derTino89/RotaCon/README.md

# RotaCon
 full Project with 3D-Print, PCB-Layouts, Arduino-Program etc.
