derTino89/RotaCon/Documentation/dokumentation.pdf

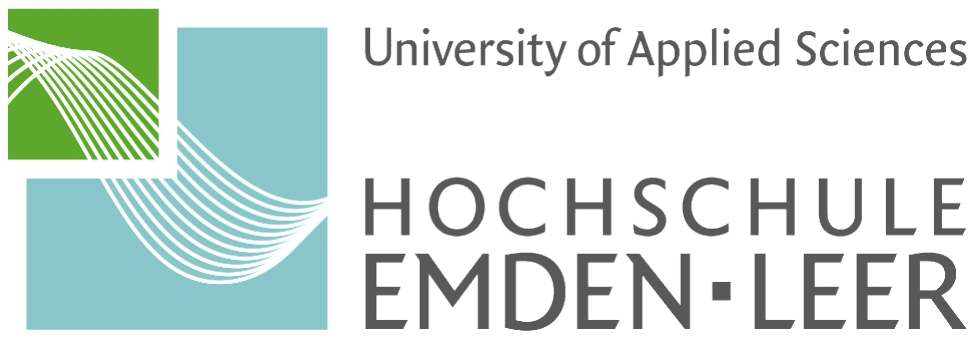
[picture p15: figure]

Projektarbeit

# RotaCon - Dokumentation

### vorgelegt von:

### - Tino Liebenow - Matrikelnummer 7011830

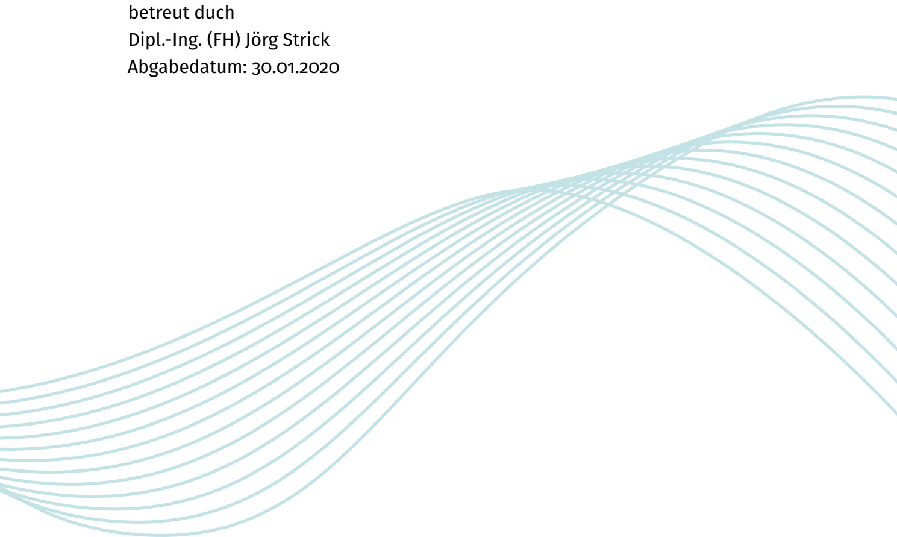
[picture p16: figure]
betreut duch; Dipl.-Ing. (FH) Jörg Strick; Abgabedatum: 30.01.2020

# Inhaltsverzeichnis

1 Prolog | 4
2 Konzeptentwurf | 5
3 Prototyp-Entwicklung | 7

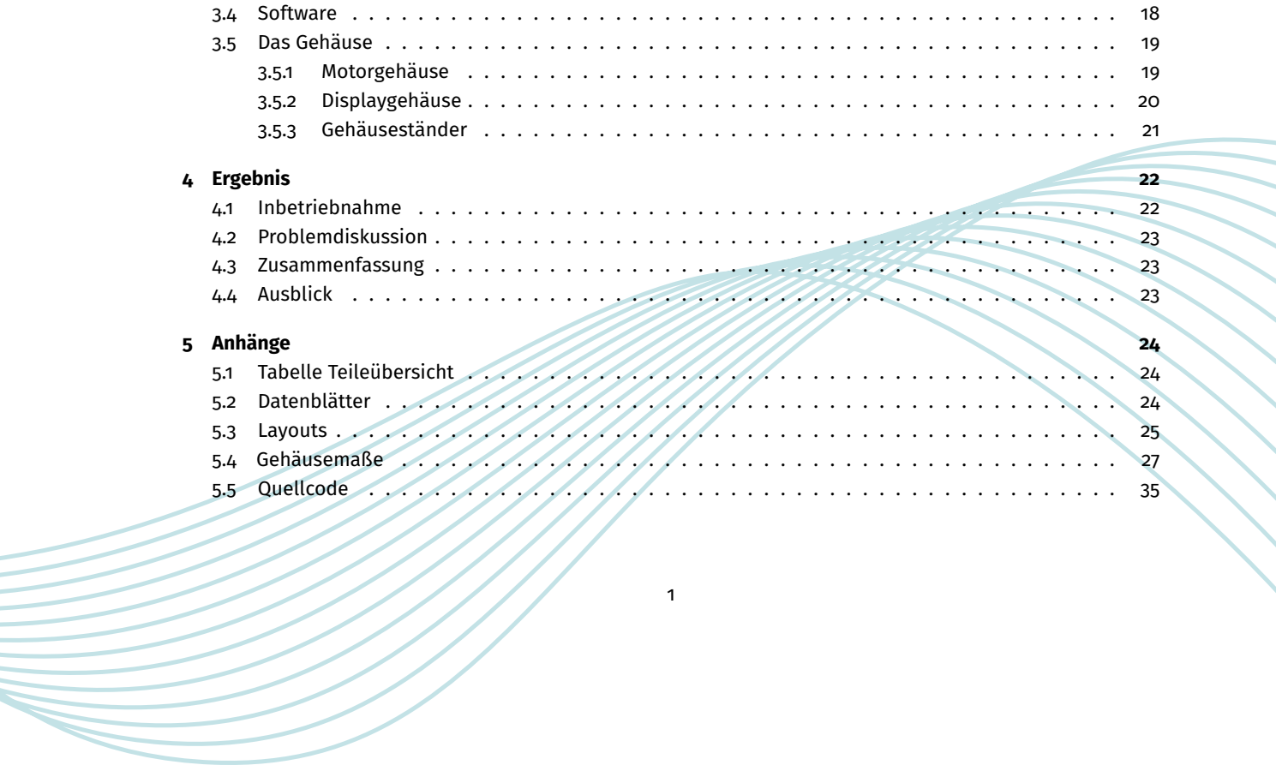
[picture p17: figure]
4 Ergebnis; 5 Anhänge

# Abbildungsverzeichnis

3.1 | Aufbau eines unipolaren Schrittmotors. | | | 9
3.2 | Ansteuerung des Motors durch Arduino und Darlington-Transistortreiber ULN2003. | | | 10
3.3 | Infrarot-Empfänger mit Pull-Up-Widerstand und Filterkondensator. | | | 11
3.4 | D-Sub-Pinbelegung für Display und IR-Receiver(gestrichelte Linie) | | 12
3.5 | Einsatz eines nicht-invertierenden Verstärkers zur Strommessung | | | 13
3.6 | Finale Schaltung der Display-Platine | | 16
3.7 | Finale Schaltung der Motor-Platine. | | | 17
3.8 | Skizze Des Motorgehäuses | | | 19
3.9 | Skizze Des Displaygehäuses | | 20
3.10 Gehäuseständer des Prototyps | | | 21
5.1 | Display-Platine | | 25
5.2 | Motor-Platine | | | 26

# Tabellenverzeichnis

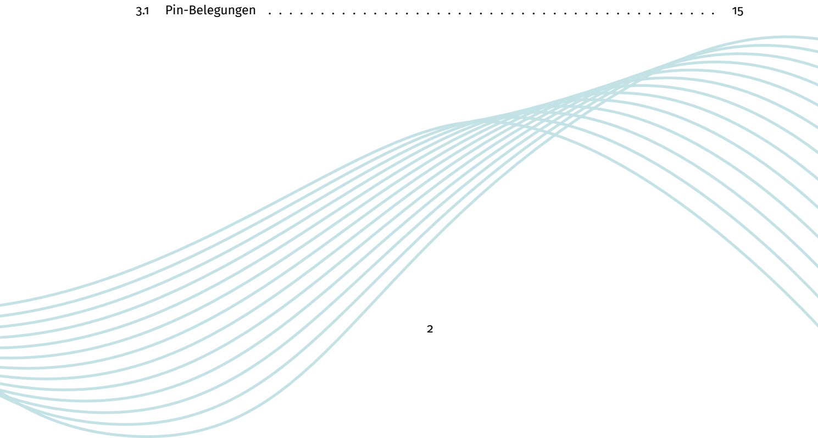
[picture p18: figure]

3.1 | Pin-Belegungen | | | 15

# Abkürzungsverzeichnis

### A/D Analog / Digital

CAD computer-aided design

D-Sub D-Subminiatur, eine Bauform für ein Steckersystem

EEPROM electrically erasable programmable read-only memory

### EQ Equalizer

HSEL Hochschule Emden Leer

IDE Integrated Development Environment

I/O Input / Output

IR Infrarot

### LCD liquid crystal display

TP Tiefpass

USB Universal Serial Bus

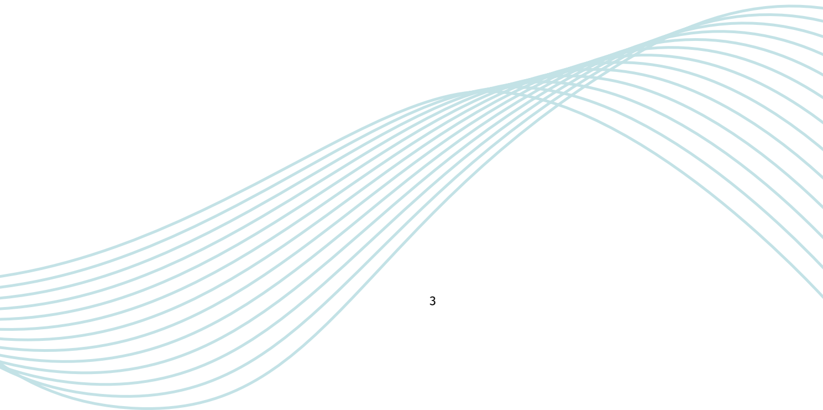
[picture p19: figure]

# Kapitel 1

# Prolog

Hier wird Tino am Ende der Arbeit eine tolle Einleitung hinzaubern, die dei Ausgangslage zu derzeitigen Aktiv-

lautsprechern beschreibt, ähnlich der Idee. Außerdem schreibe ich in männlicher Form etc...

Außerdem reden wir immer vom AKTIV-Lautsprecher...

# Überblick

Überblick über den Aufbau der Dokumentation.

Diese Dokumentation ist in vier Hauptteile gegliedert. Im Prolog wird die Ausgangssituation geschildert, sowie

die Kerngedanken zum RotaCon.

# Ziel

was möchte Tino heute eigentlich machen?

Ziel ist es ein Gerät zur Fernbedienbarkeit von Potentiometern, speziell an Lautsprechern, zu entwickeln.

Dabei sollen weder Veränderungen am Lautsprechergehäuse, oder an der Technik vorgenommen werden.

Zusätzlich ist eine Diskretisierung der Pegelwerte und deren Visualisierung via LCD-Display angedacht, sodass

der Benutzer sichtbare Werte zur Orientierung der aktuellen Einstellung bekommt.

# Stand der Technik

gibts sowas schon?

Fernsteuerungen für Pegeleinstellungen sind nicht neu auf dem Markt. Dabei sind zwei Varianten verbreitet,

zum Einen besteht die Möglichkeit, den Potentiometer auf der Platine des Lautsprechers auszutauschen, zum

Anderen die Integrierung eines Controllers in den Signalweg. Die erste Variante setzt somit die Önung des

Lautsprechergehäuses sowie Manipulation der Elektronik voraus. Dies ist nicht nur für den durchschnittlichen

Lautsprecherbesitzer ein schwieriger Eingri, sondern hat ebenfalls Einfluss auf diverse Garantieansprüche.

Die andere Variante beinhaltet keine Veränderungen am Lautsprecher selbst, regelt jedoch nur die Signalpegel

zum Lautsprecher hin und nicht den integrierten Verstärker. Somit muss für diese Version der Verstärker stets

auf Maximum geregelt sein, dies hat je nach Verstärker Einflüsse auf Soundqualität und Stromverbrauch.

4

# Kapitel 2

# Konzeptentwurf

Das folgende Kapitel beinhaltet die theoretischen Bestandteile zur Umsetzung der Idee. Diese bilden in ihrer

Gesamtheit das Konzept, nachdem der Prototyp entwickelt wird.

# 2.1 Theorie Hardware

Lautstärkeregler sind in den meisten Fällen Potentiometer oder Inkrementalgeber. Diese besitzen in der Regel

eine 6mm oder 6.35mm Achse, in D-Form oder gerielt. Um diese Achse rotieren zu können muss also ein Motor

mit einer passenden Kupplung angebracht werden. Für präzise Kontrolle und ausreichendes Drehmoment ist

ein Schrittmotor geeignet. Diesen gibt es in verschiedenen Ausfertigungen: unipolar und bipolar. Unipolare

Schrittmotoren haben vier Phasen (Elektromagnete) und werden nur in einer Richtung von Strom durchflossen.

Bipolare polen ihre Magnetfelder durch Umkehrung der Stromrichtung um, sie haben zwei Phasen, erreichen

ein höheres Drehmoment und sind durch ihre Funktionsweise etwas aufwendiger anzusteuern.

Für eine Schrittmotorsteuerung sind drei Funktionseinheiten notwendig. Diese bestehen aus Mikrocontroller,

Steuerschaltung und Treiberstufen. Für dieses Projekt ist ein unipolarer Schrittmotor ausreichend, da keine

hohen Drehmomente erreicht werden müssen. Dies hat zusätzlich den Vorteil, dass die Steuerschaltung simpel

ist und rein auf Softwarebasis gelegt werden kann. Als Treiber soll eine Darlington-Schaltung für den Motor

dienen. Die softwaretechnische Besteuerung ist durch ein Arduino mit integriertem Mikrocontroller angestrebt,

dessen Spannungsversorgung von 5V idealer Weise auch für die anderen Komponenten ausreichen soll, sodass

ein Betrieb des Gerätes durch USB-Spannungsversorgung ermöglicht wird.

Da analoge Drehregler durch eine Minimal- und Maximalstellung begrenzt sind, ist auch der Antrieb des Motors

in diesen Bereichen zu stoppen. In erster Linie sollen Endschalter den Potentiometer-Anschlag erkennen und

Software-gesteuert die Rotation einstellen. Redundant dazu wird der Stromverbrauch des Schrittmotors durch

die Kombination eines nicht-invertierenden Verstärkers und dem Analog-Digital-Wandler vom Mikrocontroller

überwacht.

Für die Bedienung des Gerätes soll ein Infrarotempfänger mit passender Fernbedienung im Frequenzbereich

verwendet werden. Da sich Lautstärkeregler meist nicht sichtbar am Lautsprecher befinden, ein IR-Empfänger

jedoch eine quasioptische Verbindung voraussetzt, bieten sich zwei getrennte Gehäuseteile an, die durch ein

Kabel verbunden sind. In dem sichtbaren Gehäuse befindet sich zusätzlich das Display.

5

# 2.2 Theorie Software

Softwaretechnisch sind drei Bereiche in diesem Projekt abzudecken:

1. Programmierung des Mikrocontrollers
2. Entwurf von Schaltung und Platinenlayout
3. Modellierung der Gehäuse

Bei der Programmierung des Mikrocontrollers soll beachtet werden, dass die aktuellen Werte der Motorstellung

und der dazugehörigen Lautstärkeanzeige gespeichert werden, damit bei jeder Inbetriebnahme die jeweils

vorherigen Werte beibehalten bleiben. Die einzige Schnittstelle zum Benutzer ist das Display, daher müssen

Fehler, Warnungen und wichtige Informationen auf dem Display abgebildet werden. Alle variablen Funktionen

des Gerätes sollen über die Fernbedienung steuerbar sein, also die Steuerung der Lautstärke, aber auch das

Aktivieren, bzw. Deaktivieren der Displaybeleuchtung.

Für den Entwurf der Schaltung sowie die Erstellung des Platinenlayouts soll ein Leiterplatten-Editor benutzt

werden. So können externe Platinen-Hersteller oder hochschuleigene Maschinen die Produktion der

Leiterplatten sicherstellen.

Die Gestaltung der Gehäuse muss präzise modeliert werden, damit Steckverbindungen und Display form-

schlüssig integriert werden können. Dabei soll zusätzlich darauf geachtet werden, dass alle Teile von einem

3D-Drucker gerfertigt werden können.

# 2.3 Theorie Mechanik und Design

Die Übertragung des Drehmoments vom Motor an den Drehregler des Lautsprechers kann nur stattfinden,

wenn der Motor starr gelagert ist. Daher ist das Gehäuse mit Motor und Motorsteuerung zu fixieren. Weiterhin

sind Lautstärkeregler an unterschiedlichen Lautsprechern auch an verschiedenen Positionen, sodass dieses

Gehäuse zusätzlich in seiner Position variabel positionierbar sein muss.

Einige Lautsprecher mit stärkeren Verstärkern haben zusätzlich Kühlkörper an der Lautsprecherrückseite, aus

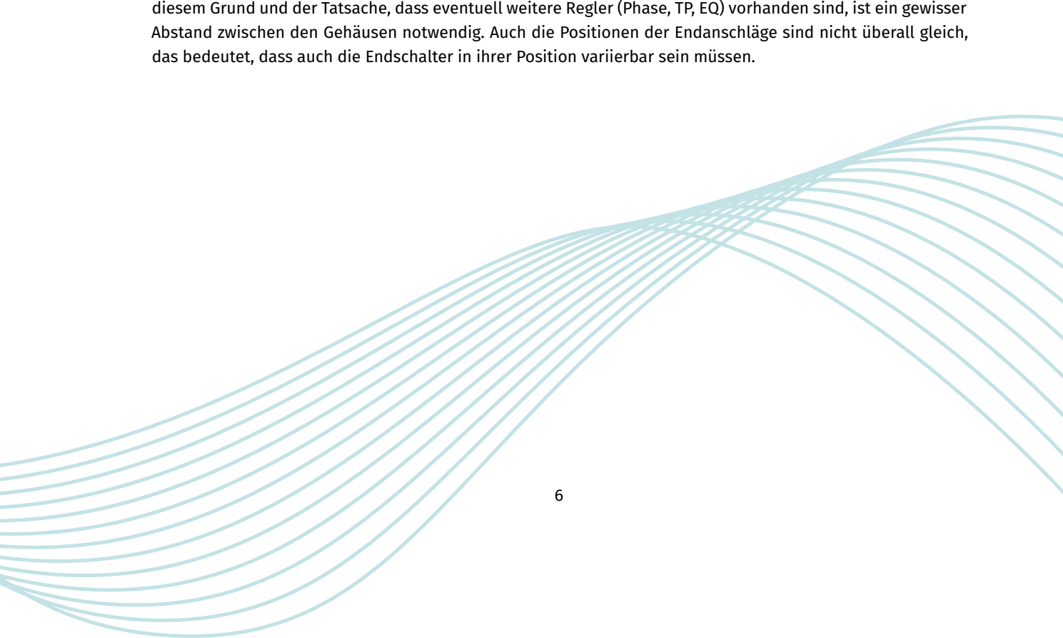
[picture p20: figure]

diesem Grund und der Tatsache, dass eventuell weitere Regler (Phase, TP, EQ) vorhanden sind, ist ein gewisser

Abstand zwischen den Gehäusen notwendig. Auch die Positionen der Endanschläge sind nicht überall gleich,

das bedeutet, dass auch die Endschalter in ihrer Position variierbar sein müssen.

# Kapitel 3

# Prototyp-Entwicklung

Folgendes Kapitel beinhaltet die Beschreibung aller im RotaCon verwendeten Bestandteile, sowie der Software,

die zum Entwickeln benutzt wurden. Es wird auf die Programmierung des Mikrocontrollers eingegangen, die

elektronische Schaltung und der Entwurf der Gehäuse wird erläutert.

# 3.1 Notwendige Software

Die folgend näher erläuterten Programme wurden bei der Entwicklung des RotaCon verwendet und sind

keine zwingende Vorraussetzung zur Produktion. Jedes dieser Programme kann bei Bedarf durch äquivalente

Software ersetzt werden.

# Arduino IDE

Diese Entwicklungsumgebung (IDE¹

) stellt den Softareteil der Arduino-Plattform dar und basiert auf

Processing, einer | stark typisierten | Programmiersprache | mit integrierter | Entwicklungsumgebung. | Die
Programmiersprache | ähnelt C++ | und ist darauf ausgelegt, ohne | tiefgründige | Programmierkenntnisse

Programme schreiben zu können. Programme dieser IDE werden ”Sketch” genannt.

Solch ein Sketch wird in der Umgebung compiliert und kann via USB-Schnittstelle direkt auf den Speicher des

Arduino-Boards geladen werden. Ein in die IDE integrierter serieller Monitor kann die jeweiligen Zustände der

Ein- und Ausgänge überwachen und ist ein Hilfsmittel zur Fehlersuche in der Entwicklungsphase.

Damit die Übertragung des Sketches stattfinden kann, muss jedoch vorerst das richtige Board mit dem

richtigen Prozessor in den Werkzeugen ausgewählt werden. Verwendete Version: Arduino 1.8.10

# FreeCAD

### FreeCAD²

ist eine parametrische Modellierungsanwendung. 3D-Objekte können mit hoher Päzision modelliert

und angeordnet werden. Vorteil gegenüber einer Modellierungsanwendung, wie Cinema 4D, besteht in der

Möglichkeit der Herstellung von Unterlagen zum designten Modell. So können beispielsweise technische

Zeichnungen und Montagepläne erstellt werden. [FreeCAD(1)]

Die Anwendung ist ein Open-Source Projekt, daher wird es gemeinschaftlich weiterentwickelt und wächst in

seinem Funktionsumfang. Verwendete Version: FreeCAD 0.18

1
IDE steht für Integrated Development Environment und bedeutet Entwicklungsumgebung.

2
CAD steht für computer-aided design und beschreibt das rechnergestützte Erzeugen geometrischer Modelle

7

# Cura

Cura ist eine Slicing Software der Firma Ultimaker. Dieses Programm ist für die Umwandlung von 3D-

Objektmodellen in spezifische Druckanweisungen verantwortlich. Dazu wird ein 3D-Modell zu einem Stapel

von flachen Schichten umgerechnet beziehungsweise ”zerschnitten”. Zusätzliche Einstellungen für den

3D-Drucker werden vorgegeben, sodass Druckablauf, Temperaturen von Druckbett und Extruder, Filament-Art,

Vortriebsgeschwindigkeiten und gegebenenfalls Stützen für den Druck von Überhängen festgelegt sind. [Cura

User-Manual(2, S.26-29)]

# Eagle

Die Software Eagle von Autodesk ist ein Platinen-CAD Programm zum entwerfen von Schaltplänen und

Platinenlayouts. Dabei sind zwei Hauptschritte der Bearbeitung auszuführen. Zum Einen die Gestaltung des

Schaltplans, dazu bietet Eagle durch Einbinden von Bibliotheken annähernd alle erdenklichen Schaltsymbole

und Bezeichnungen die für den Entwurf der Schaltung notwendig sind. Zusätzlich können manuell Symbole

erstellt werden, falls spezielle unkonventionelle oder eigens entwickelte Elemente verwendet werden. Im

zweiten Schritt wird das Layout der Platine entworfen, um die Leiterbahnen und Bohrungen passend zu

platzieren bzw. zu dimensionieren.

# 3.2 Verwendete Hardware

# Arduino Nano

Arduino ist eine Open-Source Elektronik Plattform, die aus zwei Teilen besteht. Einem Hardware- und einem

Softwareteil [Brühlmann | (3, S.23)]. | Der | Hardware-Teil ist eine | Mikrocontroller-Schaltung mit serieller

Schnittstelle. Diese ”Mikrocontroller-Boards” gibt es in verschiedenen Ausführungen und unterscheiden sich

in ihrer Größe, dem verwendeten Mikrocontroller und den somit einhergehenden Eigenschaften von Ein- und

Ausgängen. Die Eingänge können Daten von Sensoren einlesen, die Ausgänge dienen zur Ansteuerung von

Motoren, Dioden, Relais oder anderen elektronischen Komponenten. Die Spannungsversorgung kann über

die USB-Schnittstelle oder externem Netzteil erfolgen. Der im RotaCon verwendete Arduino Nano ist eine

Leiterplattenversion von geringer Baugröße und nutzt als Basis den ATmega328 [Arduino (4)]. Der Arduino

Nano hat insgesamt 22 Input/Output-Pins, 8 davon können als analoge Eingänge benutzt werden. Die

logische Spannung des Nanos beträgt 5V, die maximale Stromstärke pro Pin 40 mA. Mit einer Taktrate von 16

MHz und einem integrierten Speicher (EEPROM) von 1KB ist der Arduino Nano in seinen Funktionen für dieses

Projekt gweählt worden.

8

# Schrittmotor (unipolar)

Der im RotaCon verwendete unipolare Schrittmotor 28BYJ-48 hat vier Phasen. Das bedeutet vier Elektro-

magneten steuern die Bewegung des Dauermagnetrotors. Diese vier Elektromagneten werden durch zwei

Spulen realisiert, deren Wicklungen je hälftig aufgeteilt und entgegengesetzt gewickelt sind. Sie sind

statisch um den Rotor angeordnet (3.1a). Die einzelnen Phasen werden nur in einer Richtung von Strom

durchflossen und steuern so die Polung der Magneten beziehungsweise die Rotationsrichtung des Motors.

Die Versorgungsspannung beträgt 5V und der Widerstand einer Spule ist mit 50Ω +- 7% angegeben. Je nach

Einphasensteuerung oder Zweiphasensteuerung ergeben sich daher Ströme von etwa 100mA (zweiphasig),

bzw. 200mA (einphasig). Bei Schrittmotoren werden im Datenblatt Schrittwinkel und Getriebeübersetzung

angegeben. Der hier verwendete Motor hat einen Schrittwinkel von 5,625° bei 64 Schritten angegeben und

ein Getriebeverhältnis von 1/64. Daraus ergibt sich, dass eine volle Umdrehung der Motorachse 4096

Schritte benötigt (64x64). Diese Winkelangabe bezieht sich auf einen Halbschrittbetrieb, daher ist im

Vollschrittbetrieb der Schrittwinkel 11,25° und eine Achsenumdrehung benötigt 2048 Schritte [vergl. Tkotz et

al. (5, S.641)]. Bei einem Halbschrittverfahren werden Ein- und Zweiphasensteuerung zusammen benutzt um

den Motor in 45° Schritten zu bewegen [vergl. Deltron AG (6)] Die Verwendung eines unipolaren Motors hat

den Vorteil, dass auf Grund der einseitigen Stromflussrichtung, die Steuerung rein durch Software erfolgen

kann und daher auf H-Brücken oder ähnliche zusätzliche Schutzmaßnahmen in diesem Projekt verzichtet

werden kann.

I =

U
R

=

5V
50Ω

# = 100mA bzw. =

5V
25Ω
= 200mA | (3.1)

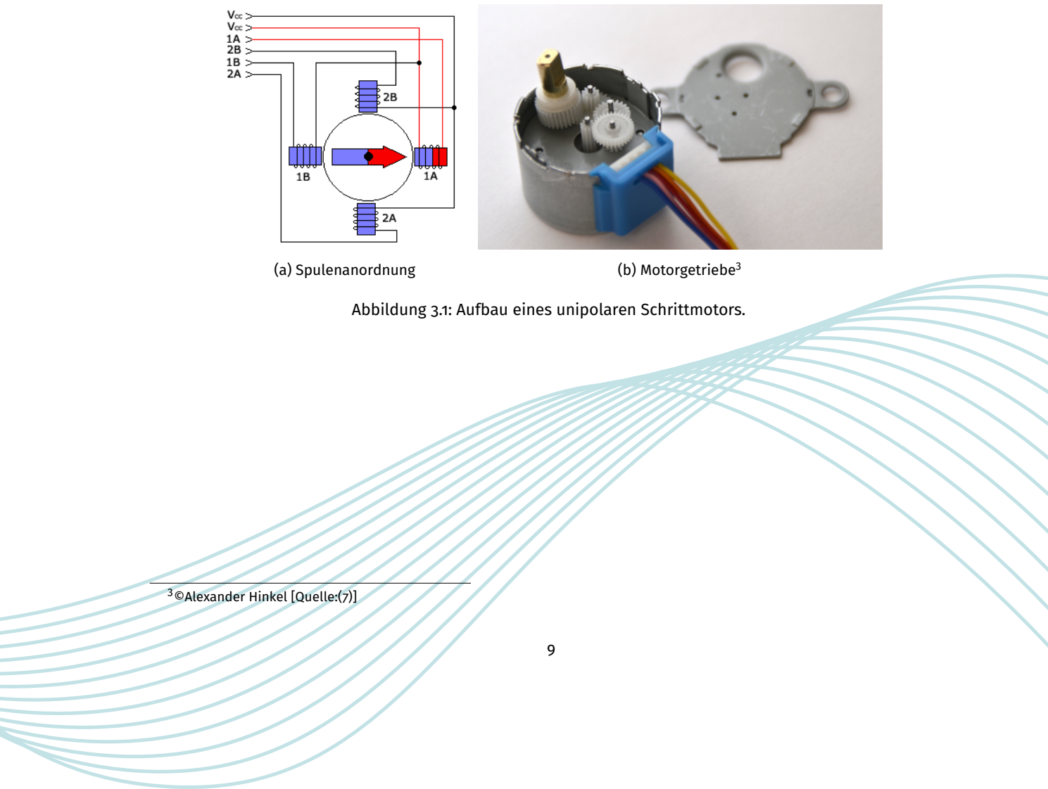
[picture p21: figure]
(a) Spulenanordnung; (b) Motorgetriebe³; 3©Alexander Hinkel [Quelle:(7)]

Abbildung 3.1: Aufbau eines unipolaren Schrittmotors.

# 3.3 Realisierung der Schaltung

# 3.3.1 Motorsteuerung

Eine Darlington-Schaltung ist eine Schaltung zweier Transistoren mit hoher Stromverstärkung und wird zur

Schaltung beziehungsweise Steuerung größerer Lasten eingesetzt [Böhmer et al. (8, S.290)]. Dabei können die

nötigen Steuerströme gering gehalten werden. Der hier verwendete ULN2003 beinhaltet mehrere Darlington-

Transistoren in einem Gehäuse und verstärkt die Steuersignale des Arduinos ohne dessen Ausgänge mit

zu hohen Stromstärken zu belasten. Gemäß Datenblatt ist die Kollektor-Emitter-Sättigungs-Spannung im

leitenden Zustand zwischen 0,9 und 1,3 Volt bei in Kapitel 3.2 angenommenen 100mA bis 200mA. Bei der

höchsten angenommenen Sättigungsspannung von 1,3 V ergibt sich ein Potentialunterschied an den

jeweiligen Wicklungen von 3,7 V. Die Messung der Widerstände der einzelnen Halbspulen⁴ des verwendeten

Motors ergibt, dass jede Phase etwa 23 Ω Widerstand hat. Bei Vollschrittbetrieb des Motors, bei dem je genau

eine Phase geschalten wird, lassen sich die Ströme daher berechnen:

### IP hase =

Versorgungsspannung (5V) − Sättigungsspannung

Phasenwiderstand

(3.2)

Stromberechung⁵
je nach Sättigung:

### Imin =

3, 7V
23Ω
= 160mA | Imax =

4, 1V
23Ω
= 178mA | (3.3)

Da die Spannungsversorgung des Motors je zwischen den Halbspulen anliegt (vergl.3.1) und sie somit parallel

geschaltet sind, betragen Strom und Spannung bei einer Zweiphasensteuerung pro Phase nur die Hälfte. Der

Gesamtstrom am Treiber jedoch entspricht dem der Einphasensteuerung.

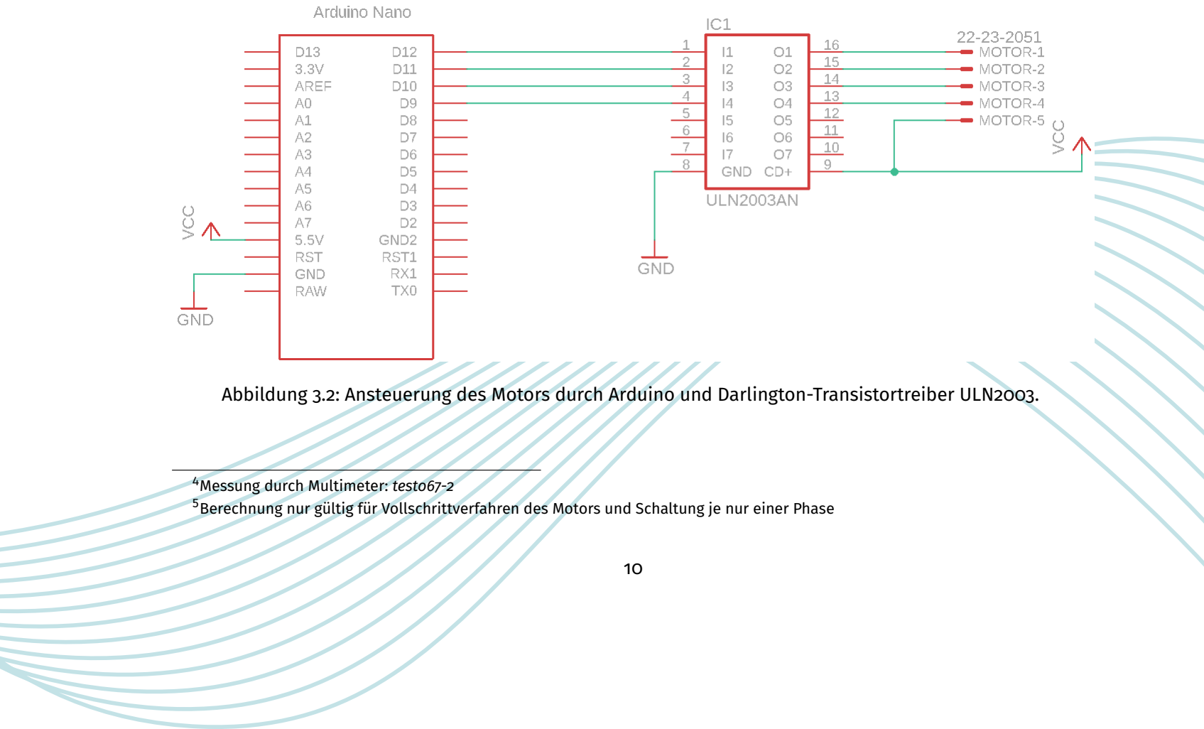
[picture p22: figure]
4Messung durch Multimeter: testo67-2

Abbildung 3.2: Ansteuerung des Motors durch Arduino und Darlington-Transistortreiber ULN2003.

Berechnung nur gültig für Vollschrittverfahren des Motors und Schaltung je nur einer Phase

# 3.3.2 IR-Empfänger

Das | verwendete | Infrarotempfänger-Modul TSOP4838 beinhaltet einen | Photosensor, Demodulator | und

Vorverstärker. Signalpulse mit einer Trägerfrequenz von 38 KHz werden Empfangen, demoduliert, vorverstärkt

und an den Output gegeben. Durch den Pull-Up-Widerstand wird dieses Signal weiter verstärkt und an den

Arduino Nano geleitet. Der analoge Eingang A5 des Arduinos kann als digitaler Eingang betrieben werden und

wird hier benutzt um das Platinenlayout übersichtlich zu halten. Zur Filterung von Störsignalen dient der

RC-Tiefpassfilter.

Tastendrücke auf einer Fernbedieung in diesem Frequenzbereich werden vom Empfänger als Hexadezimalco-

de weitergegeben. Bei Betrieb des Arduinos und zeitgleich verbundener serieller Schnittstelle, können die de-

modulierten Hexadezimalcodes über den Seriellen Monitor der Arduino IDE ausgegeben werden.

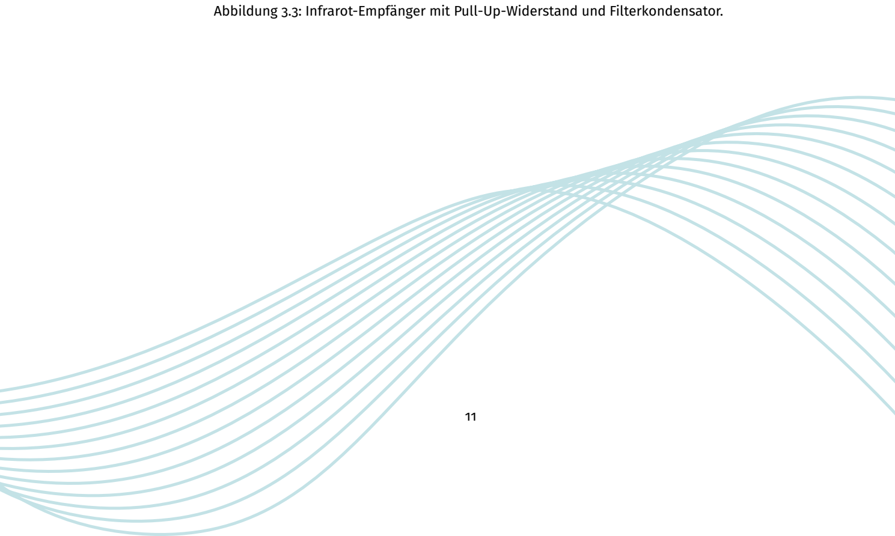
[picture p23: figure]

Abbildung 3.3: Infrarot-Empfänger mit Pull-Up-Widerstand und Filterkondensator.

# 3.3.3 Display

Das im RotaCon verwendete LCD-Display ist ein TC1602B-01. Wie in Kapitel 2.1 erläutert, besteht der RotaCon

aus 2 Gehäusen. Neben dem IR-Empfänger befindet sich auch das Display in einem für den Nutzer sichtbaren

Gehäuse, dass mit einem D-Sub-Kabel⁶
verbunden ist. Die meisten Pins sind direkt mit dem Arduino Nano

verbunden, werden rein über Software gesteuert und sind in 3.3.6 beschrieben oder dem Datenblatt zu

entnehmen. | Display-Pin | 3 setzt zusätzlich einen | Spannungsteiler | voraus | um | den | Bildschirmkontrast

festzulegen. Die im RotaCon benutzten Widerstandsgrößen sind durch den Einsatz eines Potentiometers

(10kΩ) ermittelt und ergeben die optimale Lesbarkeit bei einer Versorgungsspannung des verwendeten

Display von 5V.


Abbildung 3.4: D-Sub-Pinbelegung für Display und IR-Receiver(gestrichelte Linie).

An dieser Stelle sei genannt, dass durch die Spiegelung der D-Dub-Schnittstelle die Pin-Nummern beachtet

werden müssen. So ist beispielsweise die Versorgungsspannung bei dem D-Sub der Hauptplatine auf Pin 1, bei

### der Display-Platine jedoch auf Pin 5. (siehe Abbildung 3.4)

6
D-Sub ist eine Bauform für Steckersysteme mit n Datenpolen und einer Zusätzlichen Masse. Im RotaCon wird ein 9 Pol D-Sub

benutzt

12

# 3.3.4 Anschlagerkennung durch Strommessung

LM324N Durch eine zusätzliche Schaltung wird der durch den Motor verbrauchte Strom gemessen. Dadurch

wird untersucht, ob der Motor bei Erreichen der Maximalstellung des Potentiometers vom Normalstrom-

verbrauch abweicht und dies softwaretechnisch zur Motorsteuerung beitragen kann. Durch einen nicht

invertierenden Verstärker wird der Strom zu einer für den Arduino auswertbaren Spannung gewandelt. Die

allgemeine Funktionsweise von Operationsverstärkern wird hier nicht weiter erläutert. Aufgrund der in

Abschnitt 3.3.1 genannten Sättigung wird die Ausgangsspannung (Ua) der Operationsverstärkerschaltung als

Ausgangsgröße auf 4V festgelegt. Diese soll durch den in den Arduino integrierten Analog-Digitalwandler

ausgewertet werden können. Für einen möglichst geringen Leistungsverlust, werden 2 parallel geschal-

tete Strommess-Widerstände (R1 und R2 in Abb.3.5) eingesetzt und die Eingangsspannung (Ue) auf 0,5V

festgelegt. R3 und R4 in der Schaltung haben einen Widerstand von 4,7 kΩ. Durch die angenommenen

Spannungen ergibt sich ein benötigter Verstärkungsfaktor (V) von 8, welcher wiederum zur Berechnung von

R5 ausschlaggebend ist.

V =

Ua
Ue

=

4V
0, 5V
= 8 | V = 1 + R5 R4

# R5 = R4 · V − 1 = 32900Ω ≡ 33kΩ (3.4)

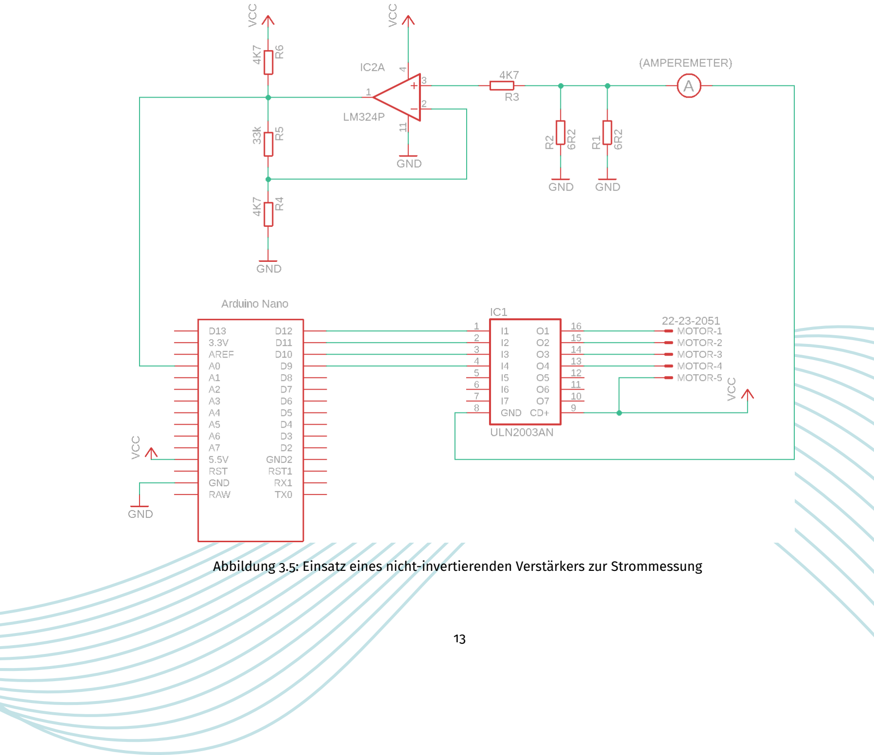
[picture p24: figure]

Abbildung 3.5: Einsatz eines nicht-invertierenden Verstärkers zur Strommessung

Der in Abschnitt 3.3.1 ermittelte Strom wird für diese Berechnung auf 160 mA festgelegt und teilt sich hälftig auf

die beiden Messwiderstände R1 und R2 auf an denen je die Eingangsspannung Ue anliegt. Durch das ohmsche

Gesetz leiten sich daher die Widerstandsgrößen her.

# Ue = R1 ·

I
2
= 0, 5V | R1 = R2 =

2 · Ue
I

=

1V
0, 16A
= 6, 25Ω ≡ 6R2 | (3.5)

Bei Schaltung einer Phase des Motors misst der Arduino mit dem integrierten A/D-Wandler 3,5V. Durch

die bekannte Verstärkung⁷
errechnet sich so ein Ue von 0,441V am Widerstand R1. Daraus ergibt sich eine

errechnete Stromstärke von 146 mA. Das Amperemeter⁸
gemäß Abb. 3.5 misst 144mA als Maximalwert. Somit

entsprechen die im seriellen Monitor der Arduino IDE gelisteten Werte den etwa tatsächlichen Werten der

Schaltung und können ausgewertet werden.

Induktivitäten benötigen eine gewisse Zeit um sich zu entladen und ein Schritt des RotaCons entspricht 64

Schaltvorgängen, die mit einer Frequenz von 500Hz (siehe Abschnitt 3.4) stattfinden. Somit wird jede Phase

einmal alle 8ms geschalten wobei 2 Phasen zu je einer Induktivität gehören. Der Strom ist daher nicht konstant

und der Zeitpunkt des Messens muss möglichst nah am Schaltzeitpunkt liegen.

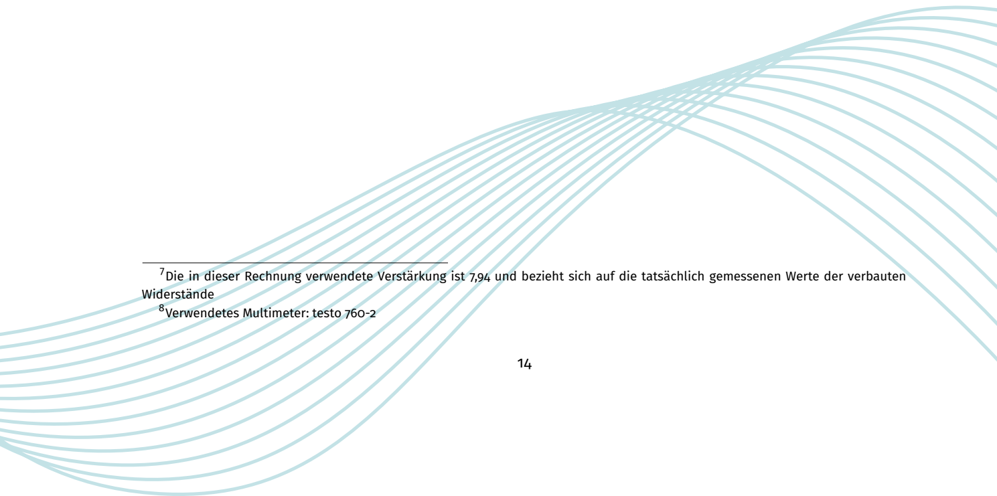
[picture p25: figure]
Widerstände; Verwendetes Multimeter: testo 760-2

Die in dieser Rechnung verwendete Verstärkung ist 7,94 und bezieht sich auf die tatsächlich gemessenen Werte der verbauten

# 3.3.5 Anschlagerkennung durch Endschalter

Redundant zur Strommessung und Auswertung besitzt der RotaCon zwei Endschalter, diese sind Mikroschal-

ter mit Flachhebel und im ”normaly open” -Modus betrieben. Bei dem Prototypen sind diese Schalter durch

Klebemasse befestigt und können je nach Potentiometer beliebig auf dem RotaCon-Gehäuse befestigt

werden. Motorachse und Potentiometer sind durch eine flexible Wellenkupplung verbunden. An dieser

Kupplung ist zusätzlich eine 25mm Schraube mit M4-Gewinde eingeschraubt, die als Hebel zum Auslösen der

Schalter dient. Sobald einer der Schalter ausgelöst wird, wechselt der entsprechende Pin des Arduinos auf

LOW und der Motor wird durch Software für diese Drehrichtung gestoppt.

# 3.3.6 Pinbelegungen

Durch die Verwendung zweier Platinen und resultierender Kabelverbindung, sind einzelne Signalpfade nur

schwer nachzuvollziehen. Folgende Tabelle bietet eine Übersicht aller Pins. Die Platinen sind abgekürzt mit

DB(Display-Board) und MB (Motor-Board).

Tabelle 3.1: Pin-Belegungen

Arduino | DSUB MB | DSUB DB | Leiste DB | Display | Symbol | Level | Beschreibung
– | – | – | Pin 1 | Pin 1 | VSS/GND | 0V | Ground
– | – | – | Pin 2 | Pin 2 | VDD/VCC | 5V | DP Versorgungsspannung
– | – | – | Pin 3 | Pin 3 | V0/CONTR | – | LCD-Kontrast
D2 | Pin 9 | Pin 6 | Pin 4 | Pin 4 | RS | H/L | H: Datensignal, L: Befehl
– | – | – | Pin 5 | Pin 5 | R/W | H/L | H: Lesen, L: Schreiben
D3 | Pin 4 | Pin 2 | Pin 6 | Pin 6 | E | H/L | Enable Display
– | – | – | – | Pin 7-10 | D0-D3 | H/L | Display-Daten
D4 | Pin 8 | Pin 7 | Pin 7 | Pin 11 | D4 | H/L | Display-Daten
D5 | Pin 3 | Pin 3 | Pin 8 | Pin 12 | D5 | H/L | Display-Daten
D6 | Pin 7 | Pin 8 | Pin 9 | Pin 13 | D6 | H/L | Display-Daten
D7 | Pin 2 | Pin 4 | Pin 10 | Pin 14 | D7 | H/L | Display-Daten
D8 | Pin 6 | Pin 9 | Pin 11 | Pin 15 | A | 5V | LED-Backlight Anode
– | – | – | Pin 12 | Pin 16 | K | 0V | LED-Backlight Kathode
D9 | – | – | – | – | Orange | H/L | Motor (Spule 1a)
D10 | – | – | – | – | Gelb | H/L | Motor (Spule 2a)
D11 | – | – | – | – | Pink | H/L | Motor (Spule 1b)
D12 | – | – | – | – | Blau | H/L | Motor (Spule 2b)
A5 | Pin 5 | Pin 1 | – | – | – | H/L | IR-Receiver
– | Pin 1 | Pin 5 | – | – | VCC | 5V | VCC
A0 | – | – | – | – | – | 0-5V | A/D Strommessung Motor
A1 | – | – | – | – | – | H/L | Taster 1
A2 | – | – | – | – | – | H/L | Taster 2

15

# 3.3.7 Gesamtschaltung der Display-Platine

Da das Display durch seine Platzierung im Displaygehäuse von der Platine getrennt ist, wird eine Pinleiste auf

der Platine eingesetzt. Display und Platine sind durch Kabelbrücken miteinander verbunden.

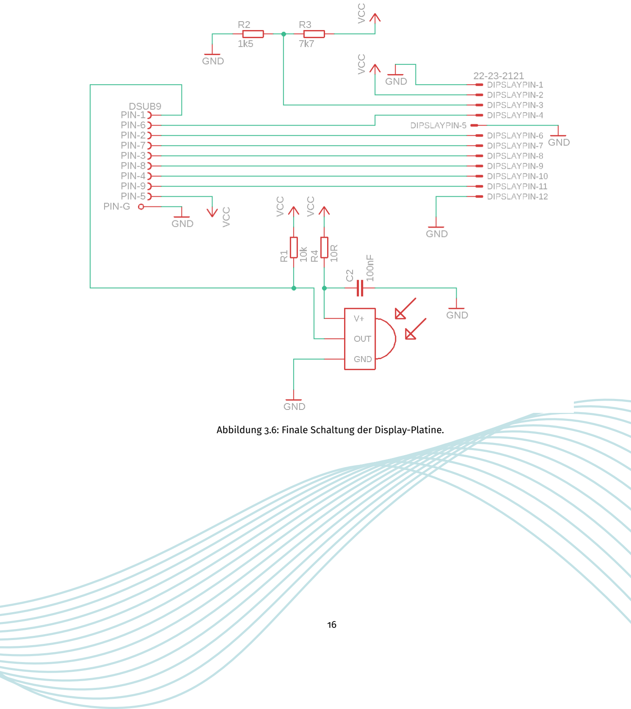
[picture p26: figure]

Abbildung 3.6: Finale Schaltung der Display-Platine.

# 3.3.8 Gesamtschaltung der Motor-Platine

Die Endschalter sind ebenfalls seperat zur Hauptplatine und daher nur als Steckverbindung zu erkennen.

Diverse Testpunkte sind in die Schaltung integriert. Die USB-Spannungsquelle sowie sätzliche Klemmen für

eine redundante Spannungsversorgung wurden hinzugefügt. Ein Anschluss für den Betrieb eines weiteren

Ports des Arduinos um eventuelle Erweiterungen durchzuführen ist ebenfalls implementiert (A3).

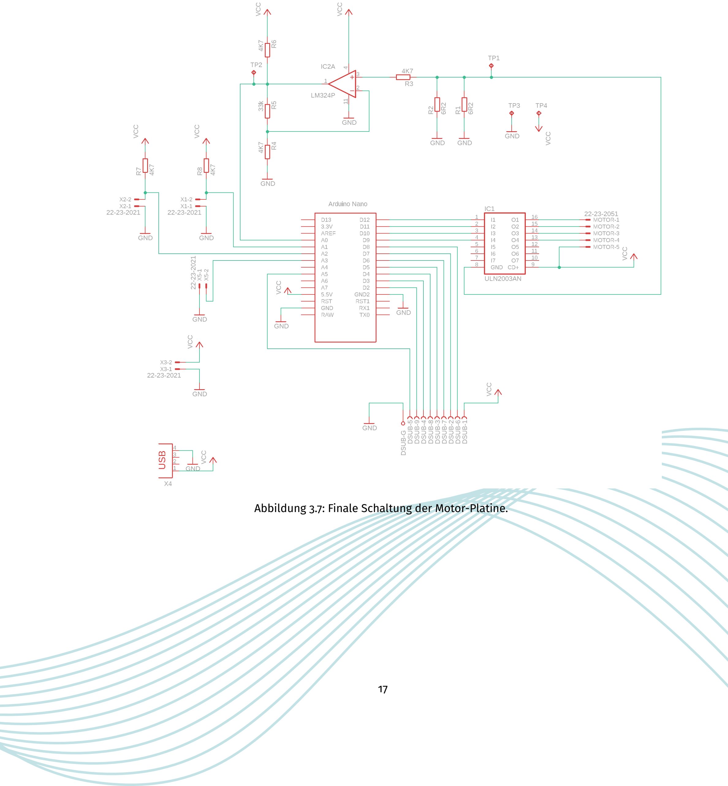
[picture p27: figure]

Abbildung 3.7: Finale Schaltung der Motor-Platine.

# 3.4 Software

Die Schaltung des Motors ist einfach gehalten. Die vier Phasen-Ports sind über eine Liste angesteuert in der

jeweils ein Wert auf HIGH und der Rest auf LOW gesetzt ist. Je nach Rotationsrichtung des Motors muss das

HIGH-Bit nun innerhalb der Liste verschoben werden. Da es bei dem Einphasenbetrieb im Vollschrittverfahren

nur vier Varianten dieser Liste gibt, wurde hier eine 4x4 Matrix implementiert deren Zeilen je einer dieser Listen

entsprechen:

## i n t s t epM a t rix [ 4 ] [ 4 ] = {

{ HIGH , LOW, LOW, LOW } ,

{LOW, HIGH , LOW, LOW } ,

{LOW, LOW, HIGH , LOW } ,

{LOW, LOW, LOW, HIGH } ,
} ;

Eine volle Umdrehung der Motorachse benötigt 2048 dieser ”Zeilensprünge” (siehe 3.2). Als Anhalt für

den maximalen Drehwinkel eines Potentiometers wird 320° angenommen. Dies entspricht etwa 1820

Motorschritten. Für die angestrebten 28 bis 30 Lautstärkestufen des RotaCons bedeutet das, dass je 64

Motorschritte für eine Lautstärkestufe passieren müssen. Damit Rotor und Getriebe sich in Bewegung setzen

können, ist bewusst ein Delay zwischen den einzelnen Schritten implementiert.

Unmittelbar nach jedem Schritt wird die am A/D-Wandler liegende Spannung abgefragt, die den Motor-

Stromverbrauch repräsentiert. Der tiefste Wert nach 64 Schritten wird übergeben und dient zur Feststellung

ob der Motor den Endanschlag des Potentiometers erreicht hat. Sind die Werte überhalb eines Schwellwertes,

ist dies ein Anzeichen, dass der Rotor starr schwischen den schaltenden Elektromagneten steht. Der

Schwellwert wurde über Tests im seriellen Monitor ermittelt und liegt bei 2,8V.

Wird somit ein Anschlag erkannt, oder einer der beiden Taster betätigt, ist die Motorsteuerung für eine

Rotation in diese Richtung gesperrt und auf dem Display wird eine Warnung ausgegeben. Das Display lässt

sich durch eine Methode deaktivieren, die die Hintergrundbeleuchtung ausschaltet.

Für die Displaysteuerung und Datenauwertung des Infrarotempfängers werden entsprechende Bibliotheken

benutzt. Eine ”Switch-Case-Anweisung” koordiniert die Eingaben der Fernbedienung. So kann jeder Hexadezi-

malwert vom IR-Empfänger einer Methode zugewiesen werden. Hält der Benutzer eine beliebige Taste der

Fernbedienung gedrückt, so sendet sie den Wert ”0xFFFFFFFF”. Dieser Wert steht für die Wiederholung des

zuletzt gesendeten Hex-Codes, daher ist dieser Wert gesondert in der Software betrachtet. (siehe Anhang 5.5)

Die aktuelle Motorposition, sowie Lautstärke wird im internen EEPROM-Speicher abgelegt. Sollte der RotaCon

vom Strom getrennt werden, bleiben diese Werte somit unverändert.

Die komplette Software ist in dem GitHub-Projekt einsehbar, daher werden weitere Details hier nicht weiter

erläutert um den Umpfang dieser Dokumentation übersichtlich zu halten.

18

# 3.5 Das Gehäuse

Dieser Abschnitt bezieht sich auf Feststellungen aus Kapitel 2.3. Alle Angaben beziehen sich auf die in diesem

Projekt verwendeten Materialien. So sind die Maße der Platinen und deren Bohrungen zum Beispiel

ausschlaggebend für den Gehäuseentwurf.

# 3.5.1 Motorgehäuse

Für den Prototypen wurde ein Gehäuse entworfen, dass weder verklebt noch vielseitig verschraubt werden

muss. Somit kann zu Entwicklungszwecken ein häufiges unkompliziertes Önen stattfinden. Exakte Maße sind

den detaillierteren technischen Zeichungen im Anhang zu entnehmen. Ausmaße des Gehäuses ergeben sich

durch Platinen- und Motorgröße, da der Motor komplett im Gehäuse untergebracht ist. Dieses Gehäuse

besteht aus zwei einzeln gefertigten Teilen, die mit einem 3D-Drucker produziert werden. 3D-Modell und

notwendige Dateien zum Druck sind im GitHub-Projekt abgelegt, variieren jedoch je nach verwendetem

Filament und Drucker.

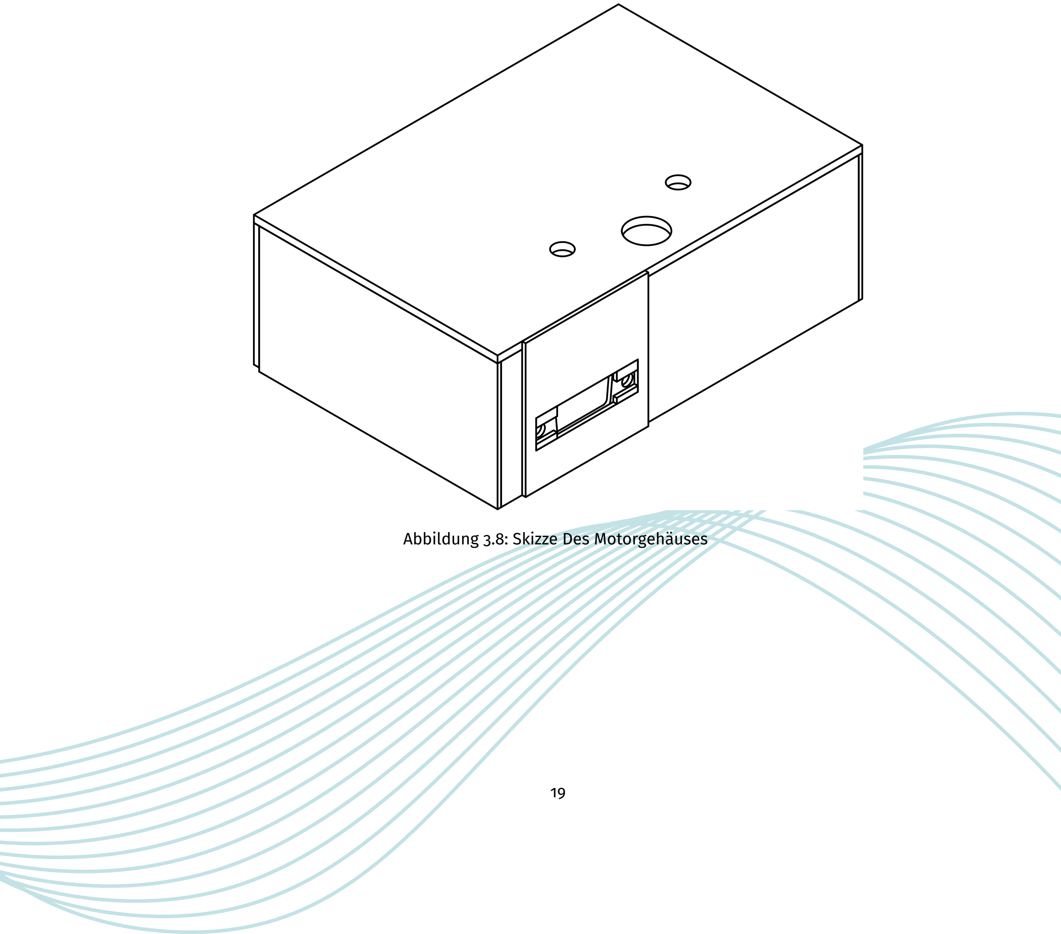
[picture p28: figure]
Abbildung 3.8: Skizze Des Motorgehäuses

# 3.5.2 Displaygehäuse

Auch bei diesem Gehäuse wurde darauf geachtet, dass es möglichst einfach geönet werden kann. Höhe und

Breite sind durch die Displaymaße beeinflusst. Die Önung für den IR-Empfänger ist mit möglichst dunkler

Folie verdeckt, da Licht der Displaybeleuchtung sonst nach außen scheint. Display und Platine sind in diesem

Gehäuse auf Platikstifte gesteckt und halten ohne Einsatz von Heißkleber oder Schrauben. Durch das 40cm

lange D-Sub-Kabel kann dieses Gehäuse frei auf der Oberseite des Lautsprechers platziert werden. Zum Einen

verbinden keilförmige Haken als Klemmverschlus die beiden Gehäuseteile miteinander, zum Anderen sorgt die

D-Sub-Steckverbindung für den Zusammenhalt.

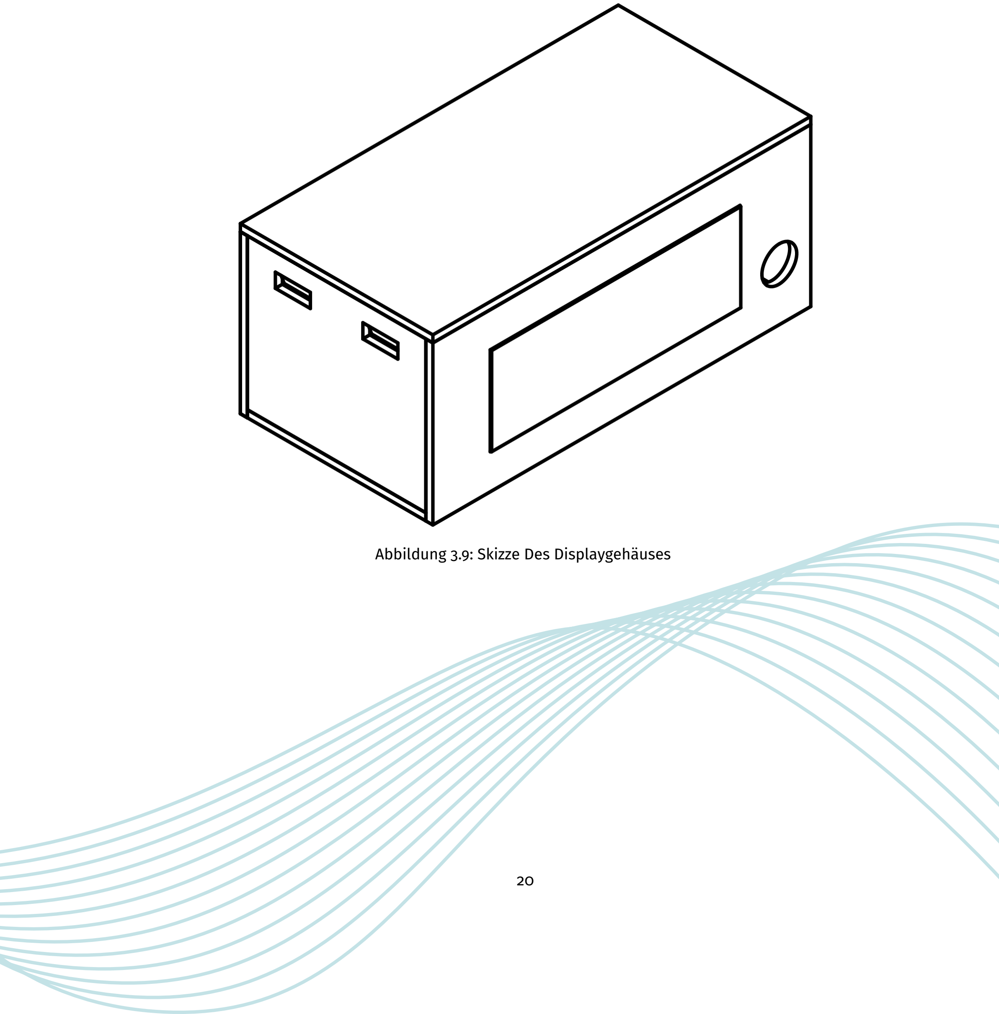
[picture p29: figure]

### Abbildung 3.9: Skizze Des Displaygehäuses

# 3.5.3 Gehäuseständer

Das Gehäusestativ ist provisorisch und aus entwicklungszeitlichen Gründen nur für den Protoytpen gestaltet.

Eine Gewindestange ist in eine Einschraubmutter des lackierten Holzfußes eingeschraubt und durch ein an das

Motorgehäuse geklebtes Winkelblech gesteckt. Durch Einsatz zweier Flügelmuttern und Unterlegscheiben lässt

sich das Gehäuse somit sehr fein in der Höhe verstellen. Dieses Winkelblech kann bei zukünftigen Versionen

zum Beispiel durch Laschen am Motorgehäuse direkt ersetzt werden. Angenehmer für den Benutzer wäre ein

Gewinde innerhalb dieser Laschen und die gewindelose Lagerung der Gewindestange im Fuß, so könnte die

Gehäusehöhe durch Rotation der Gewindestange eingestellt werden (z.B. via Motor oder Kurbel).

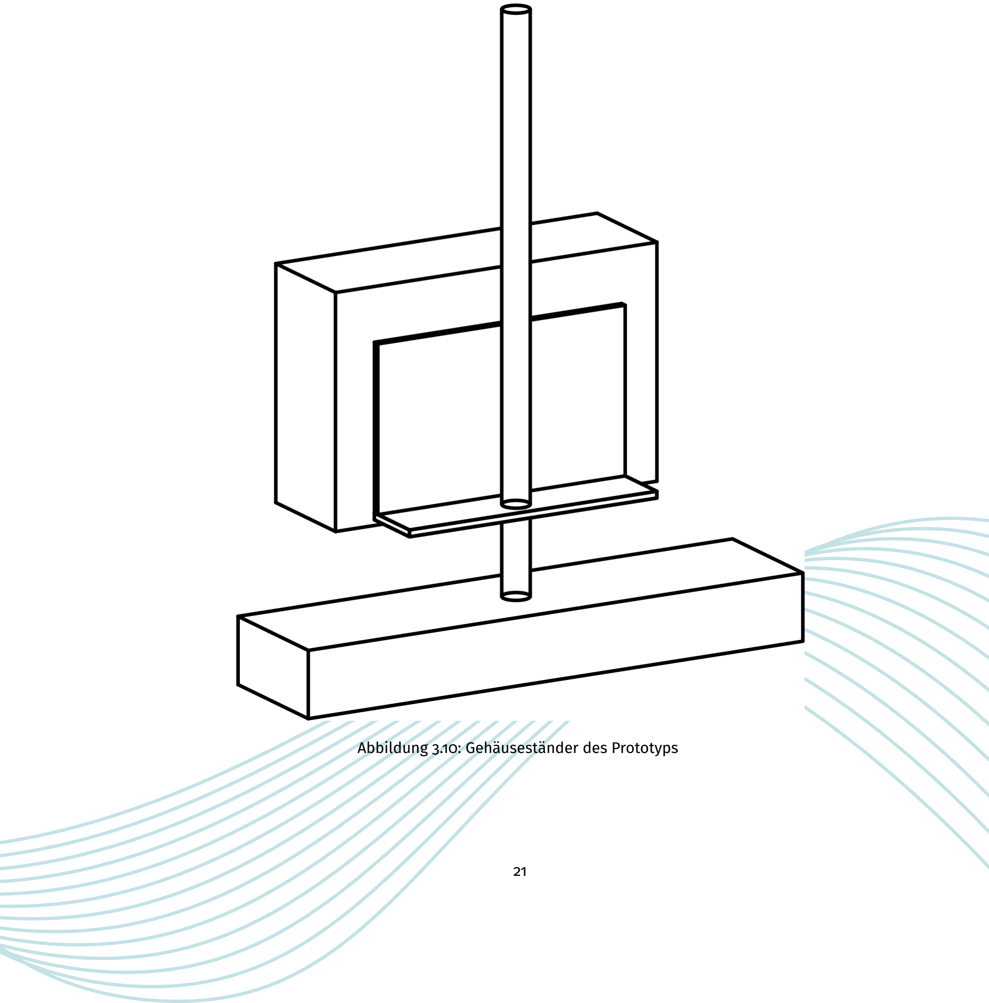
[picture p30: figure]

Abbildung 3.10: Gehäuseständer des Prototyps

# Kapitel 4

# Ergebnis

In diesem Kapitel wird die Inbetriebnahme des Prototypen geschildert. Probleme, die bei diesem Projekt

aufgetreten sind werden dargestellt und Lösungsansätze erwähnt. Nach einer kurzen Zusammenfassung des

RotaCon-Projekts folgt ein kurzer Abschnitt über mögliche Erweiterungen durch Folgeprojekte.

# 4.1 Inbetriebnahme

1. Abnehmen der Potentiometerkappe am Lautsprecher
2. Einstellen der Höhe des Motorgehäuses durch Flügelmuttern
3. Festschrauben der Wellenkupplung (Innensechskant 2mm)
4. Potentiometer mit Wellenkupplung auf Minimalwert stellen
5. Anbringen des ersten Tasters durch Klebemasse (Hebel gedrückt)
6. Stellung auf Maximalwert und letzten Schritt wiederholen

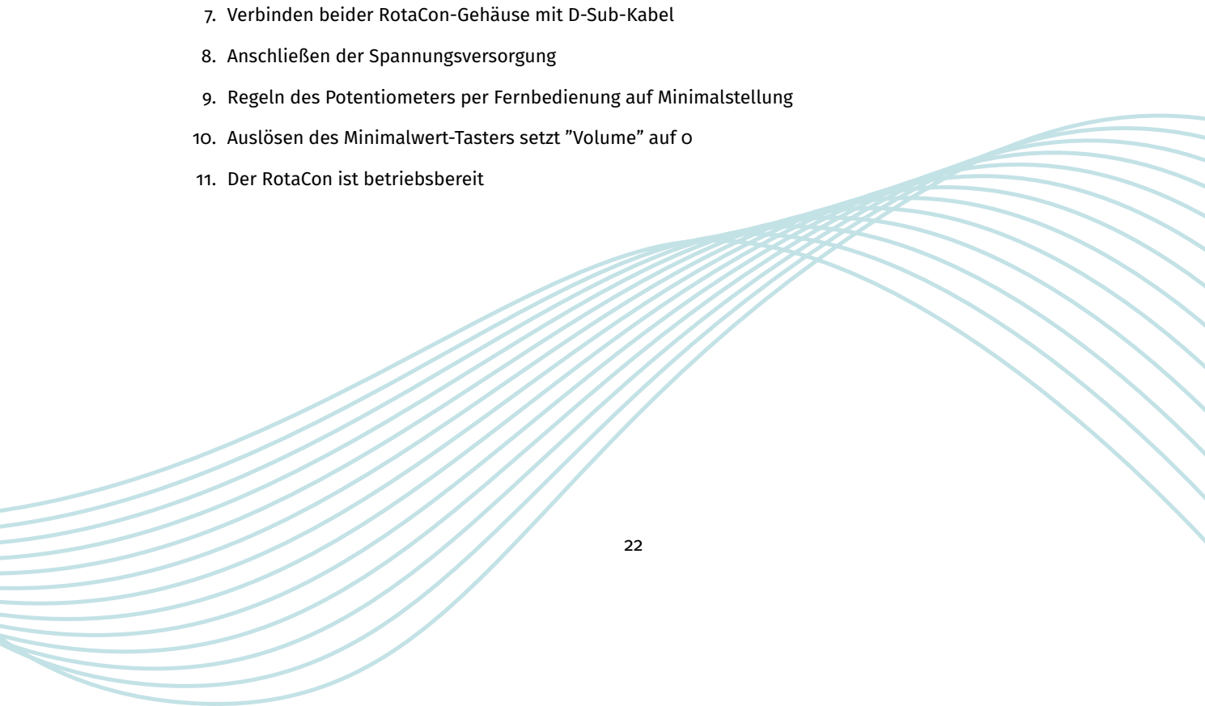
[picture p31: figure]
8. Anschließen der Spannungsversorgung; 11. Der RotaCon ist betriebsbereit

7. Verbinden beider RotaCon-Gehäuse mit D-Sub-Kabel
9. Regeln des Potentiometers per Fernbedienung auf Minimalstellung
10. Auslösen des Minimalwert-Tasters setzt ”Volume” auf 0

# 4.2 Problemdiskussion

Das D-Sub-Verbindungskabel ist sperrig und schränkt die Platzierung des Display-Gehäuses ein. Durch den

Einsatz eines I

2C-Datenbuses können die Pinbelegungen und somit auch die Anzahl der Leitungen im Kabel

so reduziert werden, dass ein flexibleres Micro-USB-Kabel verwendet werden kann.

Die Platzierung der Endschalter mit Klebemasse ist unzweckmäßig aber für den ersten Prototypen

ausreichend. Eine in das Gehäuse integrierte Ringscheibe auf der die beiden Endschalter verschoben

und befestigt werden können ist eine zweckmäßigere Variante. Darauf wurde jedoch aus Kosten- und

Aufwandsgründen bisher verzichtet.

Die Strommessung ist ein guter Ansatz, jedoch noch nicht ausreichend um sichere Aussagen über die

Stellung des Potentiometers treen zu können. Je nach Menge der Eingangssignale von der Fernbedienung

oder der Leichtgängigkeit des Potentiometers variieren die gemessenen Werte. Weitere Tests durch Variation

des Motorbetriebes (Softwaretechnisch) und damit verbundener Änderung der Messwiederstände können

Abhilfe schaen, wurden aus zeittechnischen Gründen in diesem Projekt jedoch nicht durchgeführt.

# 4.3 Zusammenfassung

Viele aktive Lautsprechersysteme werden über einen am Lautsprechergehäuse befindlichen Potentiometer

geregelt. Daher ist es üblich diese Pegel stets auf Maximalwert zu stellen und die tatsächliche Lautstärke

über den Signalpegel zum Lautsprecher hin zu verstellen. Je nach verbautem Verstärker kann dies zu

hohem Stromverbrauch, Störgeräuschen und hoher Temperaturentwicklung führen. Der RotaCon ist ein

Gerät, durch das der Benutzer in der Lage ist, das Potentiometer direkt fernzusteuern. Er besteht aus zwei

Gehäusen und einem Stativ. Das Hauptgehäuse auf dem Stativ ist in der Position verstellbar und beinhaltet

einen Schrittmotor zur Rotation des Potentiometers. Über ein Kabel ist das zweite Gehäuse verbunden,

welches auf dem Lautsprecher positioniert werden kann. Dieses beinhaltet den Infrarotempfänger für

die Fernbedienbarkeit und ein Display zur Visualisierung der Lautstärke. Der RotaCon verbraucht sehr

wenig Strom und ist daher über USB angeschlossen (Typ A male zu Typ A male). Um Motorgetriebe und

Potentiometer zu schonen, erkennt der RotaCon selbst die Maximalstellungen und verhindert weitere

Krafteinwirkung nach Anschlag. Dieser Prototyp wird über einen Arduino Nano gesteuert und bietet somit

eine geeignete Schnittstelle zur Anpassung und Weiterentwicklung.

# 4.4 Ausblick

Neben der Behebung bereits erwähnter Probleme und Optimierung des Gehäusedesigns bietet der Prototyp

des RotaCon mehrere Bereiche an, die erweitert werden können. Durch die Synchronisierung mehrerer

RotaCon zum Beispiel, wäre es möglich multiple Lautsprecher simultan oder unabhängig von einander mit

der gleichen Fernbedienung zu bedienen. Um den Benutzer selbst entscheiden zu lassen, wie sichtbar das

Gerät sein soll, wäre es möglich die Bedienung von Infrarotsteuerung auf WLAN-Steuerung zu verlegen.

Durch die Verwendung des Arduinos, ist es leicht weitere Funktionen zu implementieren, so zum Beispiel die

Speicherung von Pegelwerten als ”Preset” für ein schnelles Wechseln zwischen Standartlautstärken.

23

# Kapitel 5

# Anhänge

# 5.1 Tabelle Teileübersicht

# 5.2 Datenblätter

Eine Tabelle mit der Auflistung aller Einzelteile mit anschließenden wichtigen Bereichen der Datenblätter. Die

gesamten Datenblätter werden nicht eingefügt, jedoch ein Link der zu einem derzeitigen Datenblatt im Internet

führt.

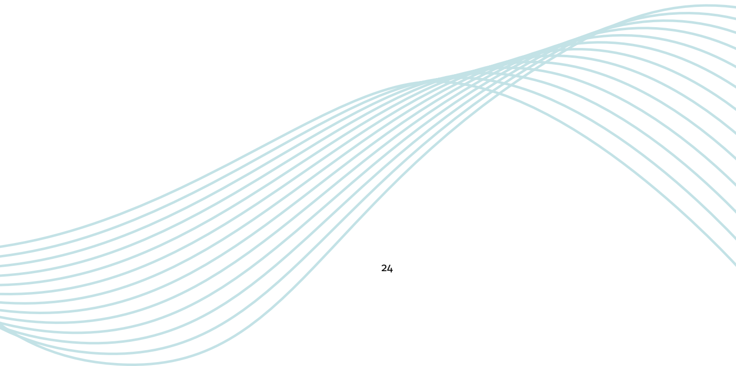
[picture p32: figure]

# 5.3 Layouts

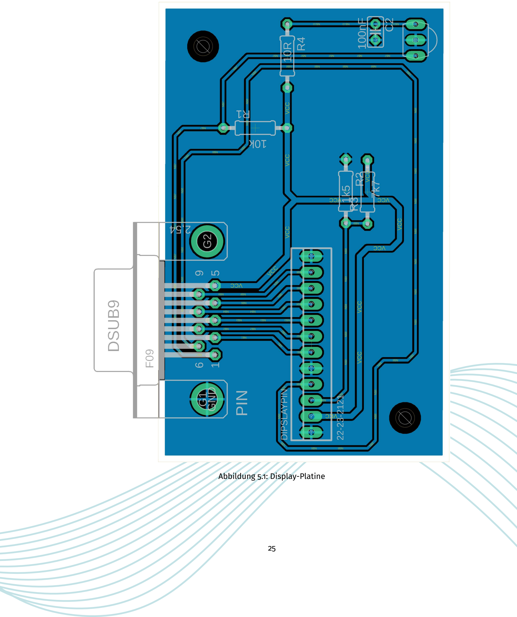
[picture p33: figure]
Abbildung 5.1: Display-Platine

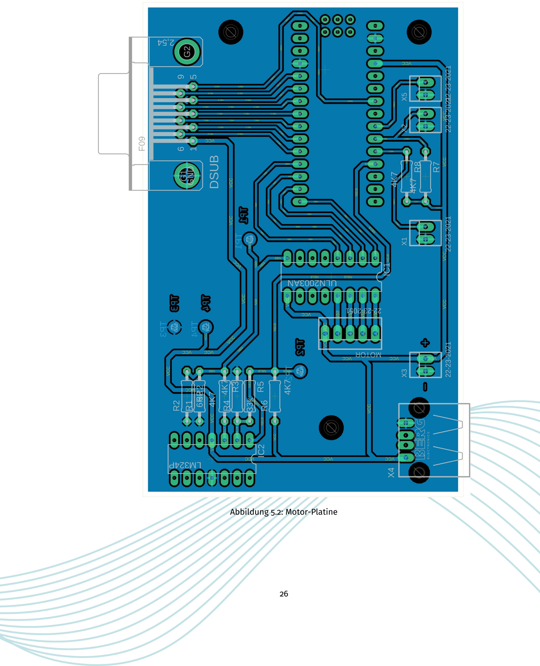
[picture p34: figure]
Abbildung 5.2: Motor-Platine

27

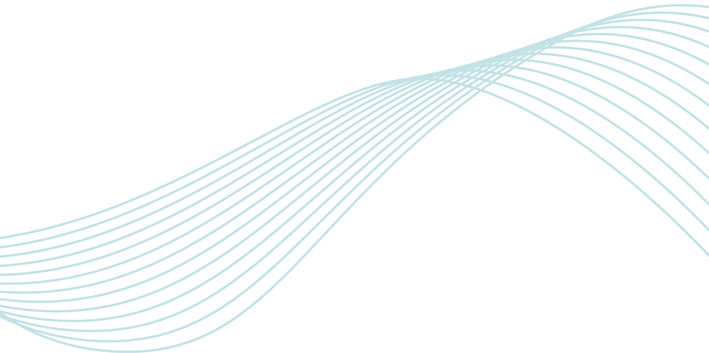
[picture p35: figure]
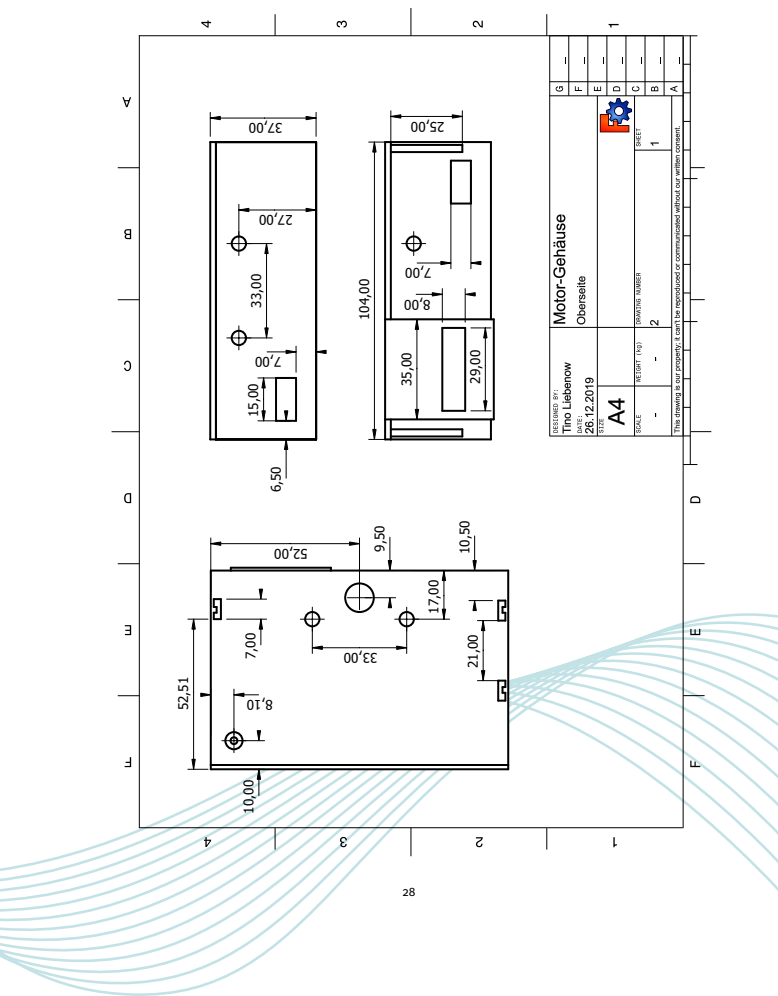
[picture p36: page 29]

29

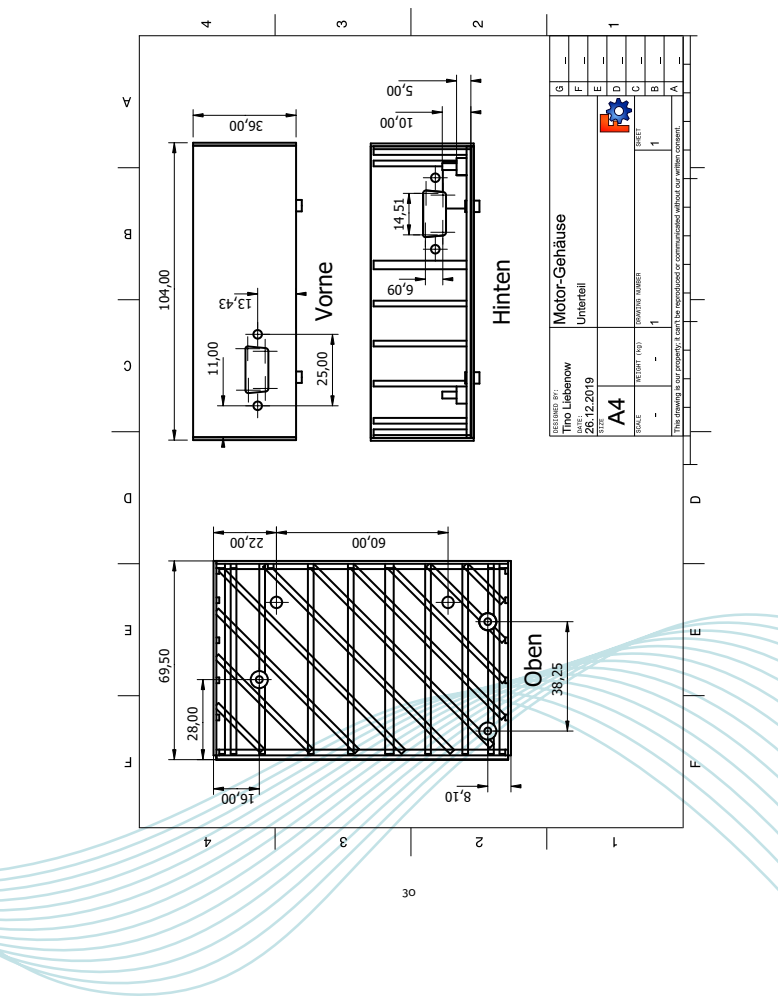
[picture p37: page 31]
Vorne 25,00; Oben; Hinten

31

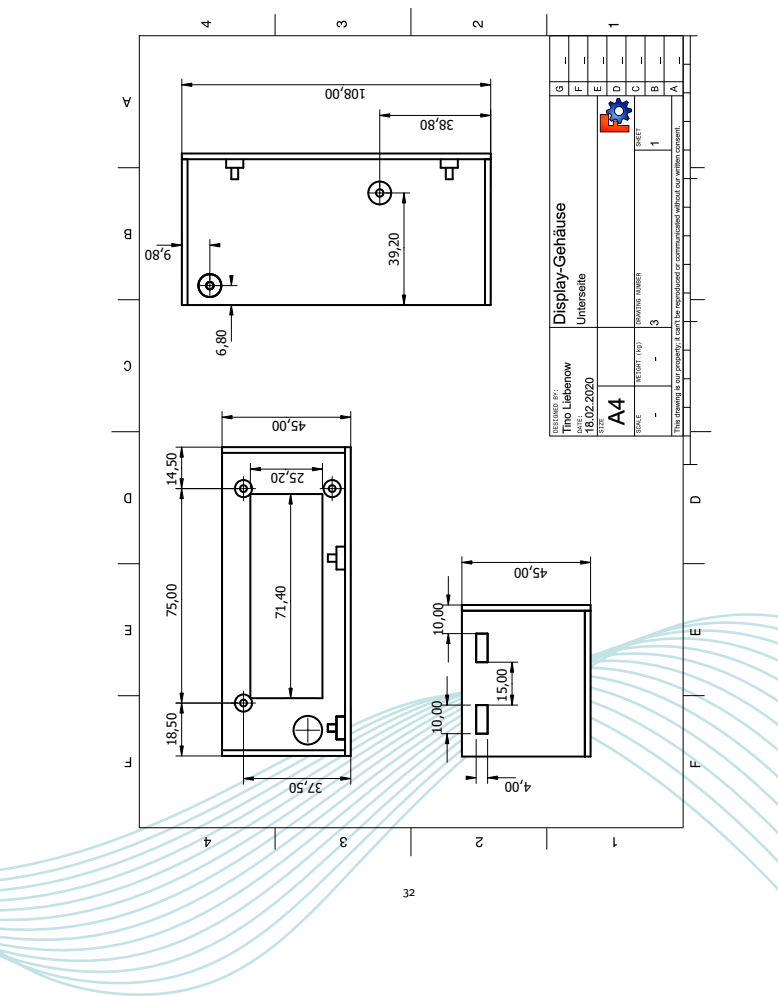
[picture p38: page 33]

33

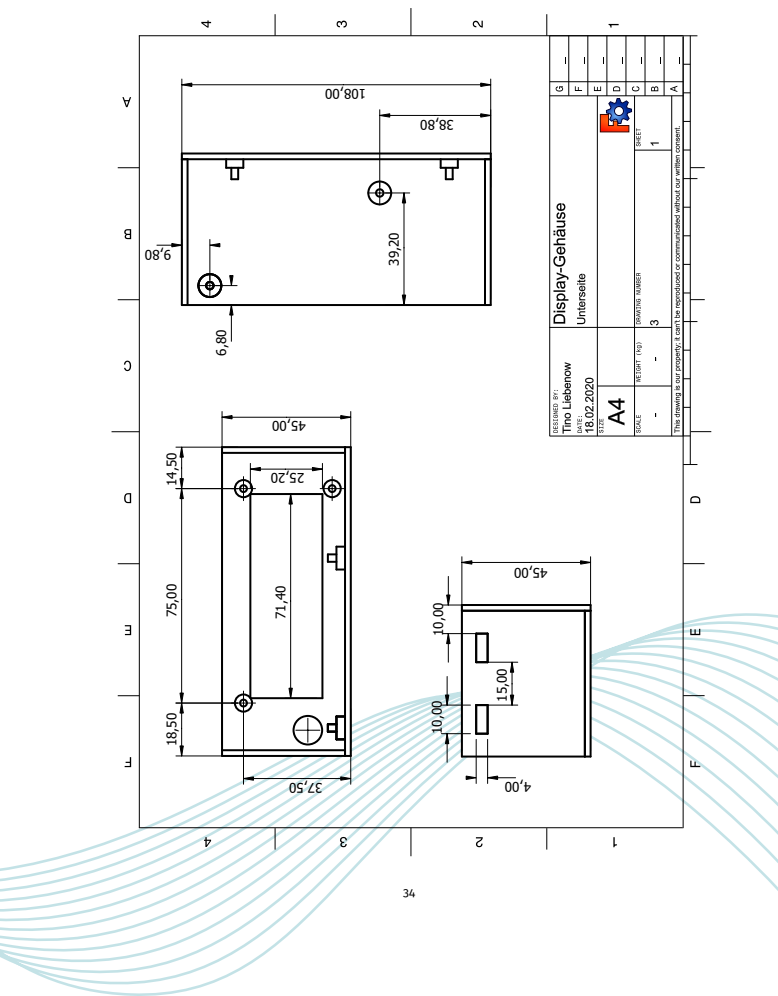
[picture p39: page 35]

# 5.5 Quellcode

Ausschnitte des Quellcodes zur Motorsteuerung:

i n t a r r ayD e f a ul t [ 4 ] = {LOW, LOW, LOW, LOW } ;

i n t ou tA r ray [ 4 ] ;

## i n t s t epM a t rix [ 4 ] [ 4 ] = {

{ HIGH , LOW, LOW, LOW } ,

{LOW, HIGH , LOW, LOW } ,

{LOW, LOW, HIGH , LOW } ,

{LOW, LOW, LOW, HIGH } ,
} ;

## void w ri te S tep ( i n t ou tA r ray [ 4 ] ) {

d i g i t a l W r i t e ( 9 , ou tA r ray [ 0 ] ) ;

d i g i t a l W r i t e ( 1 0 , ou tA r ray [ 1 ] ) ;

d i g i t a l W r i t e ( 1 1 , ou tA r ray [ 2 ] ) ;

d i g i t a l W r i t e ( 1 2 , ou tA r ray [ 3 ] ) ;
}

## void moveOneStep ( bool d i r ) { // di r = Richtung des S teps

i f ( cu r ren tS tep >= 0 | | | cu r ren tS tep <= | 3 ) {

w ri te S tep ( s t epM a t rix [ cu r ren tS tep ] ) ;

## } e lse {

w ri te S tep ( a r r ayD e f a ul t ) ;
}
( di r | == | true ) ? ( cu r ren tS tep ++ ) : | ( cu r ren tS tep −−);
i f ( cu r ren tS tep > | 3 ) {
cu r ren tS tep = | 0;
} e lse i f ( cu r ren tS tep < | 0 ) {
cu r ren tS tep = | 3 ;
}

EEPROM . put ( 1 , cu r ren tS tep ) ;
}
void moveSteps ( bool di r , | i n t s teps ) {
f l o a t lowes tVol tage | = | 5 . 0 ;
fo r ( i n t i = | 0; | i < | s teps ; | i ++ ) {

moveOneStep ( di r ) ;
f l o a t u= cu r r en t Vol t a g e ( ) ;
i f ( u < | lowes tVol tage ) {
lowes tVol tage | = u ;
}

delay ( 2 ) ;
}

lcd . cl e a r ( ) ;

uaMin= lowes tVol tage ;
}

35

Auschnitte der Messung und Auswertung der IR-Signale:

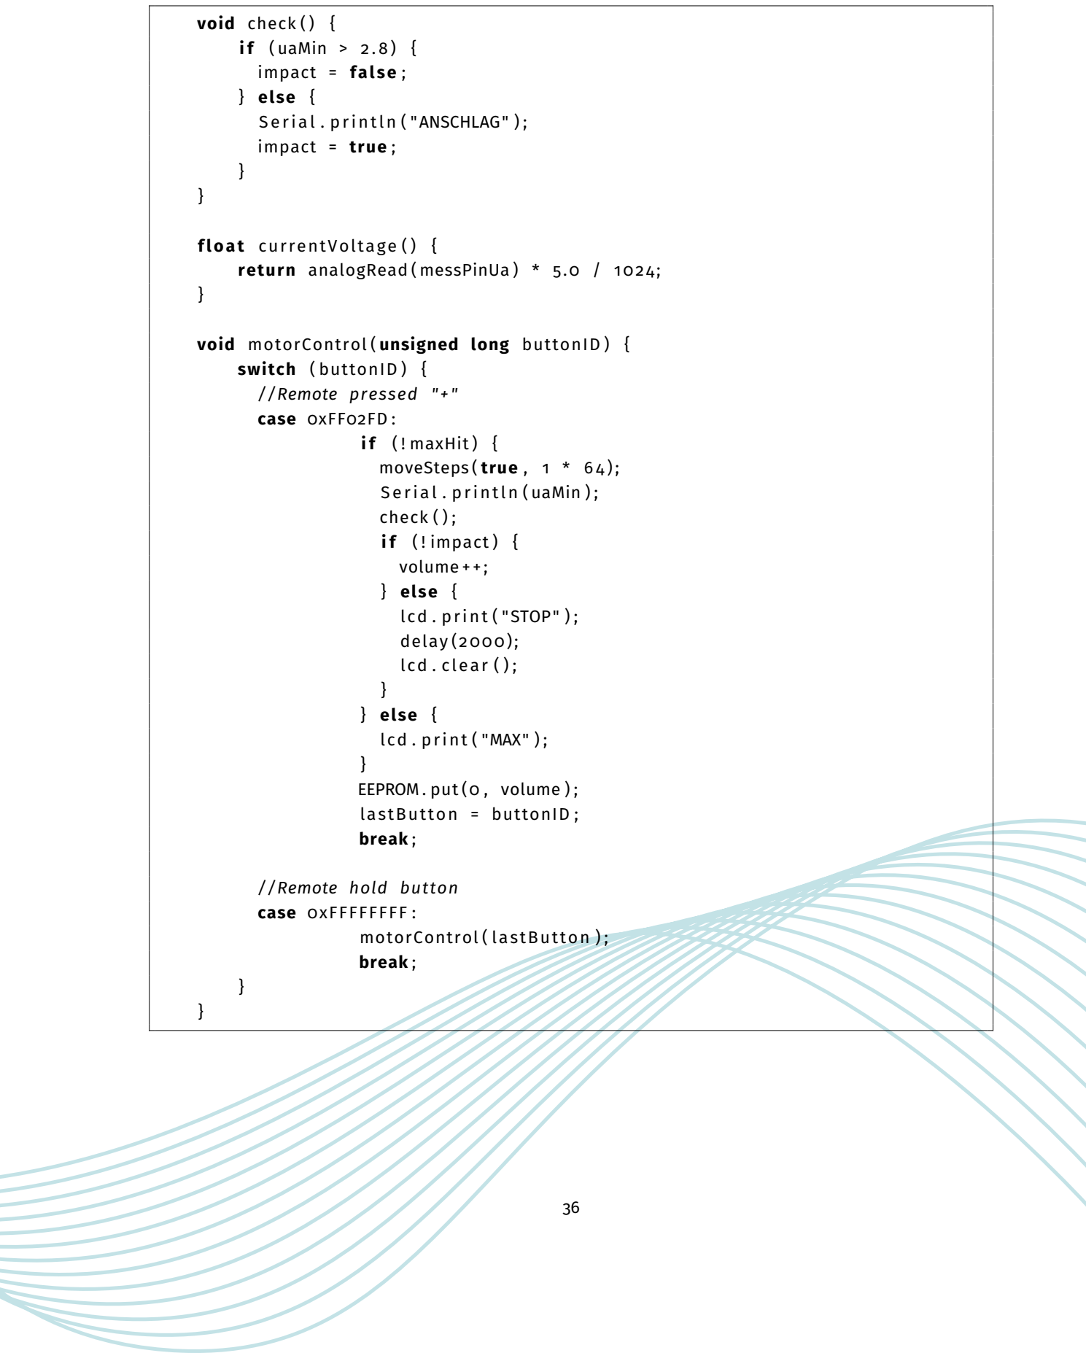
[picture p40: figure]
void check ( ) {; i f ( uaMin; impact =; } e lse {; true ;; f l o a t cu r r en t Vol t a g e ( ) {; switch ( bu ttonID ) {; //Remote pressed " + "; case 0xFF02FD : i f ( ! maxHit ) {; moveSteps ( true , 1; S e r i al . p r i n tl n ( uaMin ) ;; check ( ) ;; i f ( ! impact ) {; volume + + ; } e lse {; lcd . p ri n t ( " STOP " ) ;; delay ( 2 0 0 0 ) ;; lcd . cl e a r ( ) ;; lcd . p ri n t ( "MAX" ) ;; EEPROM . put ( 0 , volume ) ;; but tonID ;; break ;; //Remote hold button; case 0xFFFFFFFF :; motorControl ( l as tB u t to n ) ;

S e r i al . p r i n tl n ( "ANSCHLAG " ) ;

re tu rn analogRead ( messPinUa ) * 5.0 / 1 0 2 4 ;

## void motorControl ( unsigned long but tonID ) {

# Literatur

(1) o.A. Erste Schritte. 2020. url: https : / / www . freecadweb . org / wiki / Getting _ started / de (https://www.freecadweb.org/wiki/Getting_started/de)

(besucht am 13. 02. 2020) (siehe S. 7).
(2) o.A. Cura 13.11.2 User manual. o.J. url: https://ultimaker.com/download/170/Cura_User-

Manual_v1.0.pdf (https://ultimaker.com/download/170/Cura_User-Manual_v1.0.pdf) (besucht am 07. 02. 2020) (siehe S. 8).
(3) Thomas Brühlmann. Arduino Praxiseinstieg. Behandelt Arduino 1.0. mitp, 2012. isbn: 978-3-8266-8342-8

(siehe S. 8).
(4) o.A. Arduino Nano. o.J. url: https://store.arduino.cc/arduino-nano (besucht am 02. 02. 2020)

(siehe S. 8).

(5) Tkotz, Klaus Burgmaier, Monika Eichler, Walter Kober, Karsten Bastian, Peter Bumiller, Horst Käppel,

Thomas Spielvogel, Otto Schwarz, Jürgen Manderla, Jürgen Ziegler, Klaus Klee, Werner Winter, Ulrich.

Fachkunde Elektrotechnik. Europa-Fachbuchreihe für elektrotechnische Berufe. Europa Lehrmittel, 2009.

isbn: 978-3-8085-3188-4 (siehe S. 9).
(6) o.A. Schrittmotor kurz erklärt. o.J. url: https://wiki.ntb.ch/infoportal/_media/hardware/sysp/bauteile/schrittmotor_kurz_erklaert_d.pdf (https://wiki.ntb.ch/infoportal/_media/hardware/sysp/bauteile/schrittmotor_kurz_erklaert_d.pdf) (besucht am 02. 02. 2020) (siehe S. 9).
(7) Alexander Hinkel. Eagle Tutorial. o.J. url: http://www.arduino-projekte.de/index.php?n=63

(besucht am 02. 02. 2020) (siehe S. 9).
(8) Erwin Böhmer, Dietmar Ehrhardt, Wolfgang Oberschelp. Elemente der angewandten Elektronik. Kompendium für Ausbildung und Beruf. Vieweg+Teubner, 2010. isbn: 978-3-8348-0543-0 (siehe S. 10).

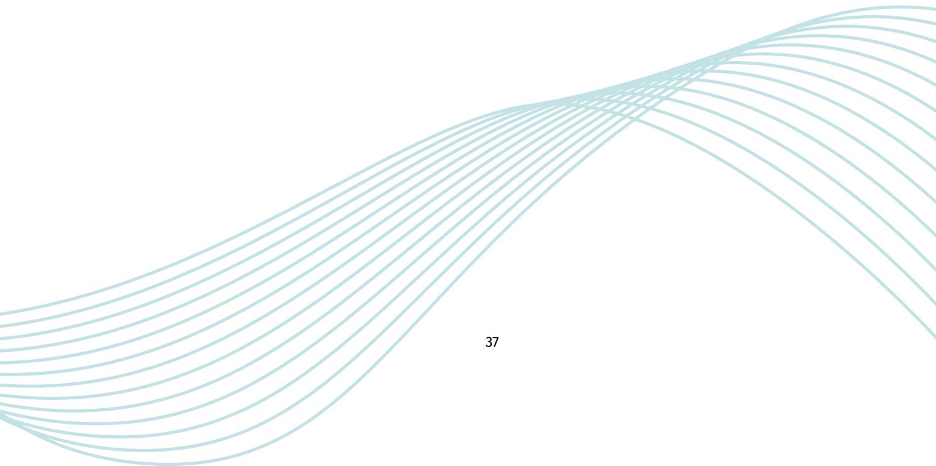
[picture p41: figure]
