derTino89/RotaCon/Datenblätter/arduino-nano-pins.pdf

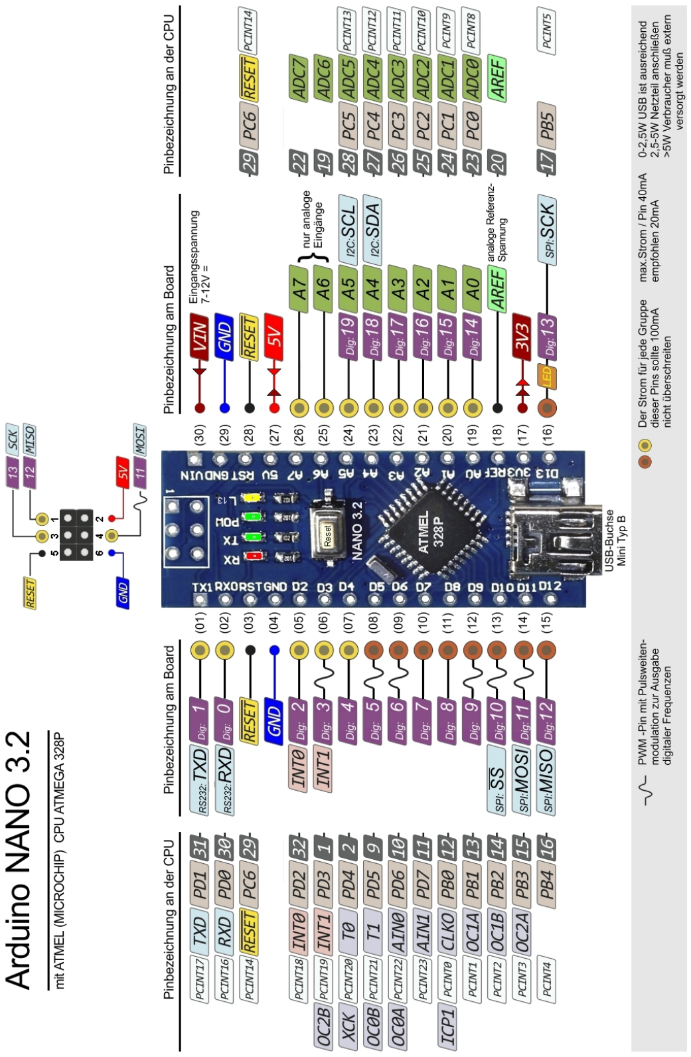
[picture p43: page 1]
