derTino89/RotaCon/Documentation/docs/Display_LayoutW.pdf

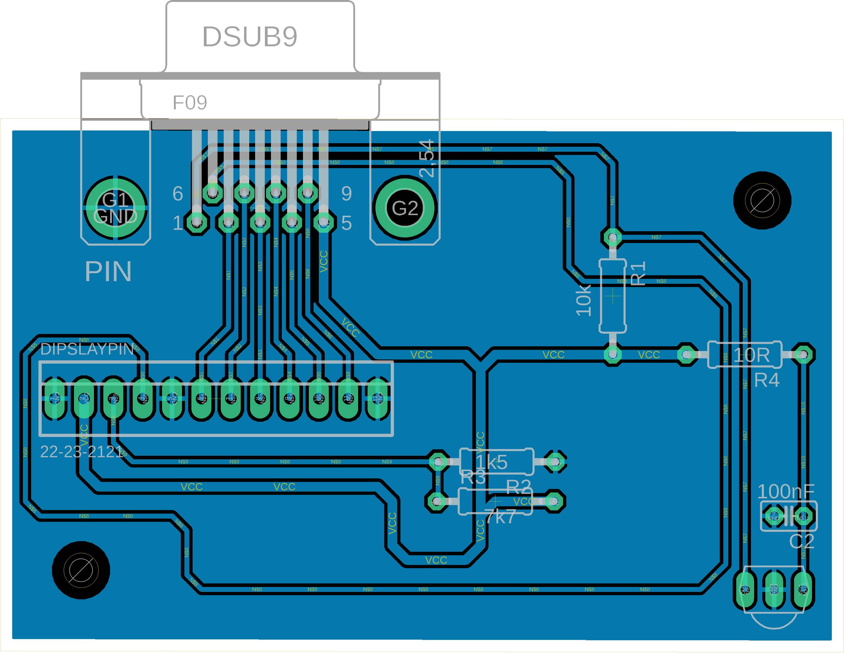
[picture p44: page 1]
