derTino89/RotaCon/Documentation/docs/Motor_Layout_white.pdf

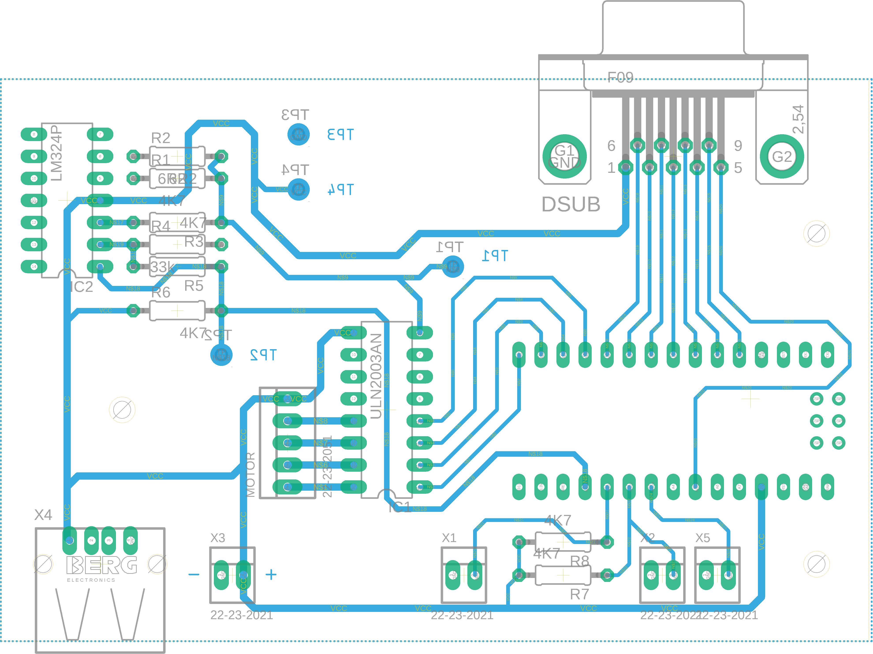
[picture p45: page 1]
