derTino89/RotaCon/Documentation/docs/Motor_LayoutW.pdf

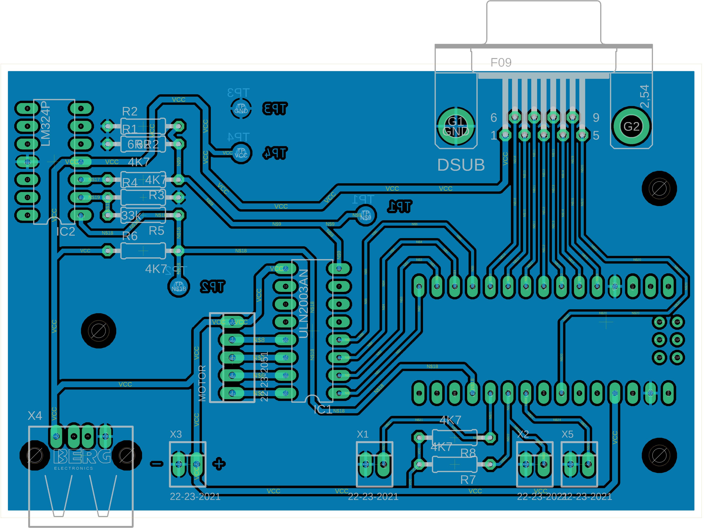
[picture p46: page 1]
