derTino89/RotaCon/Schaltung_Motorsteuerung/docuSymbol_0.1/Eagle für Dokus.pdf

# CadSoft EAGLE 7 für Dokumentationen

# Download

## EAGLE 7

# Download

## Infos & Symbole

Windows/Linux/Mac

Beim Installieren „Als Freeware lizenzieren“ Einschränkungen: Eine Schaltplanseite, 100x80mm Platinenfläche

Portable: Regulär installieren, Ordner „EAGLE-7.4.0“ auf Stick kopieren
X:\ EAGLE-7.4.0\bin\eagle.exe starten

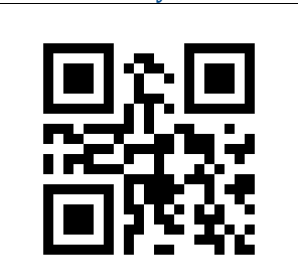
[picture p47: figure]

http://cadsoft.de/download-eagle | http://lowe.li/j

### Alternativen

- (Altium/Mentor Pads/Zuken)
- Fritzing
- KiCad
- Inkscape (Symbole: https://commons.wikimedia.org/wiki/Category:SVG_electrical_symbols)

### Lizenz der docuSymbol Bibliothek: CC-BY-SA 3.0
