derTino89/RotaCon/Documentation/img/display.png

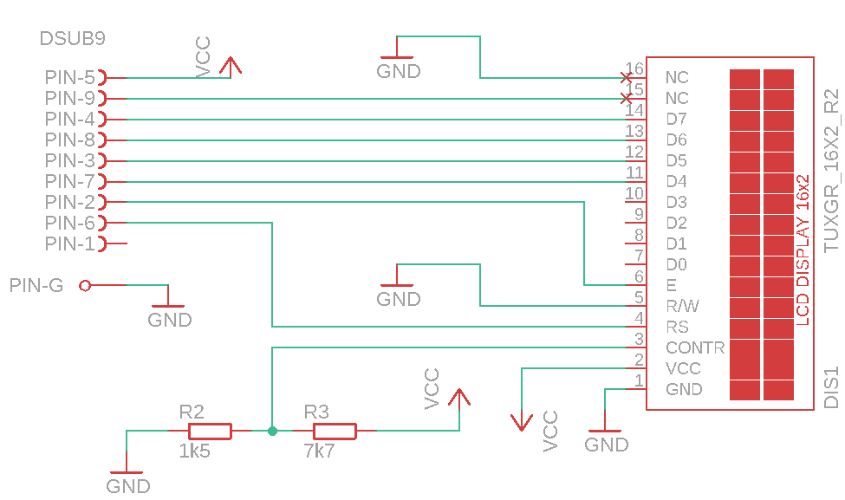
Documentation/img/display.png
