derTino89/RotaCon/Documentation/img/Display_Layout.png

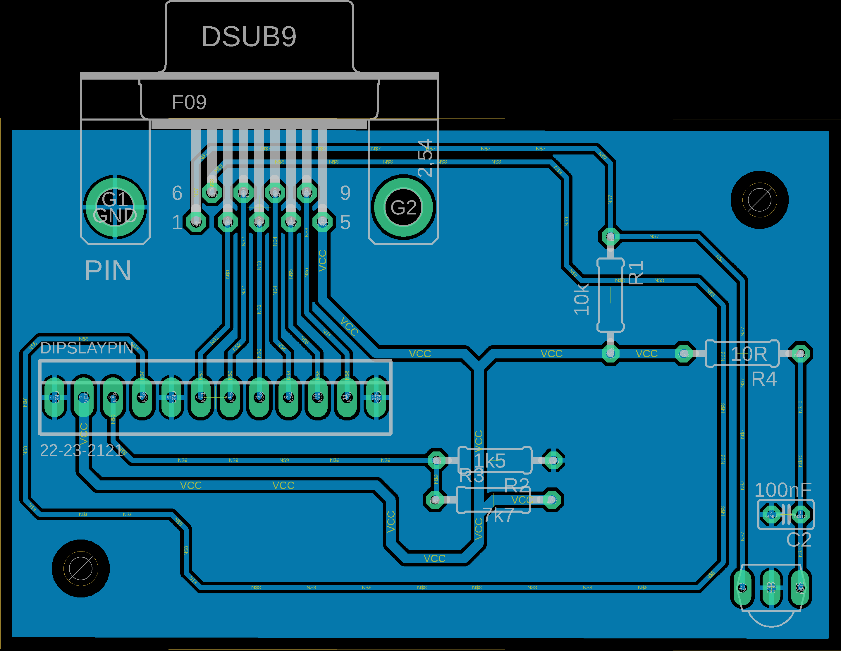
Documentation/img/Display_Layout.png
