derTino89/RotaCon/Documentation/img/dsub.png

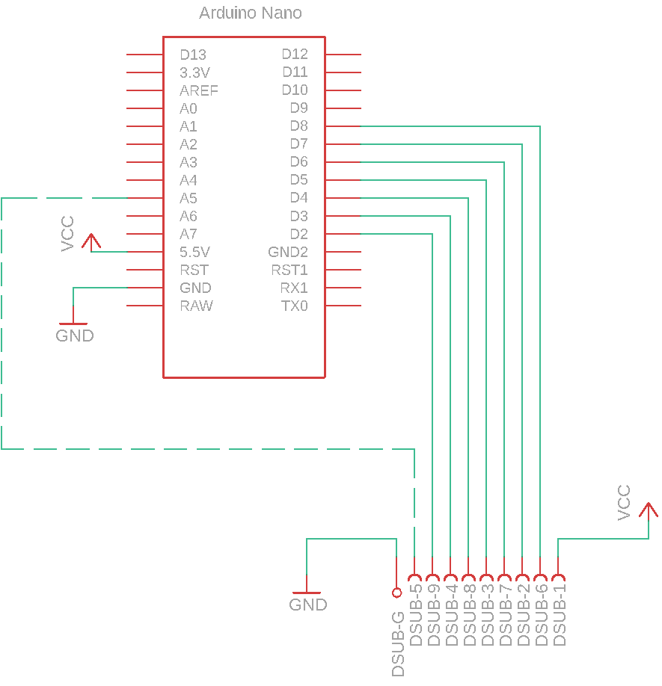
Documentation/img/dsub.png
