derTino89/RotaCon/Documentation/img/Motor_Layout.png

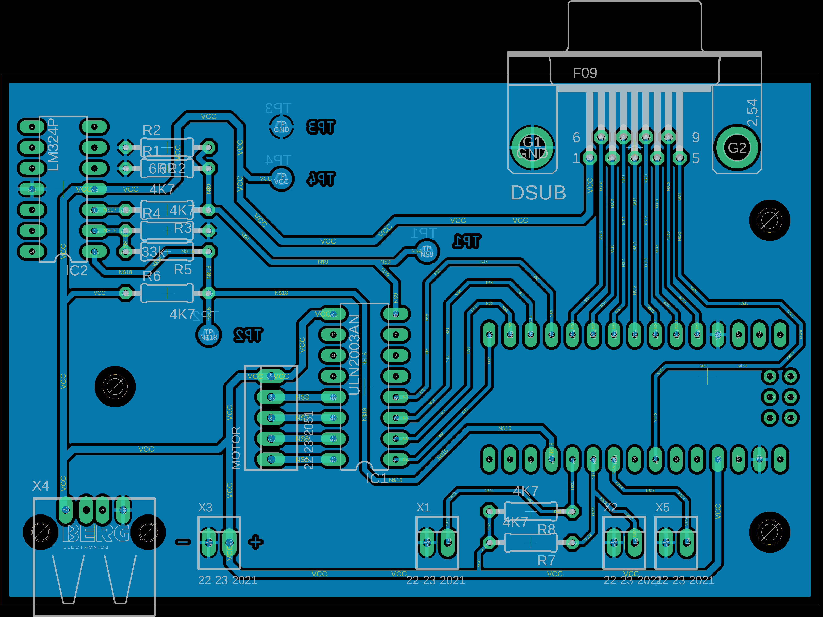
Documentation/img/Motor_Layout.png
