derTino89/RotaCon/Documentation/img/op.png

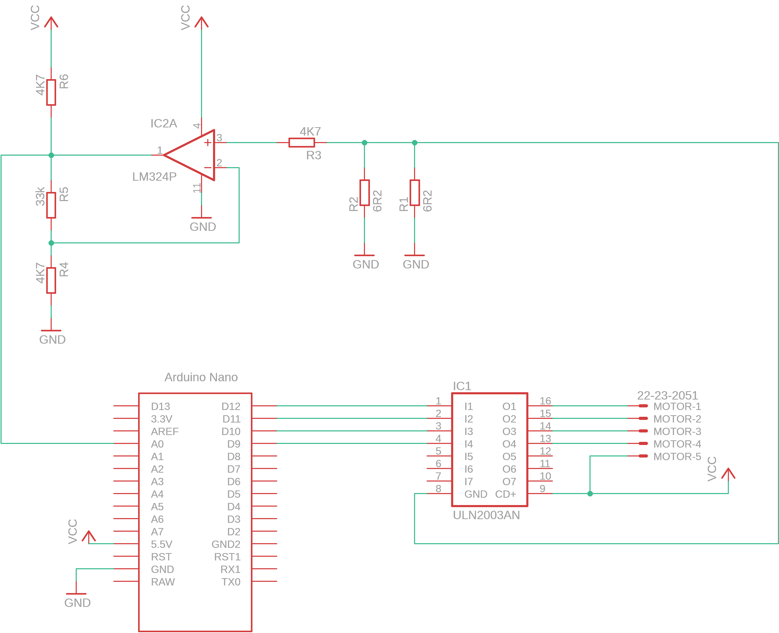
Documentation/img/op.png
