derTino89/RotaCon/Messergebnisse PreProtoTyp/einschalt 0.png

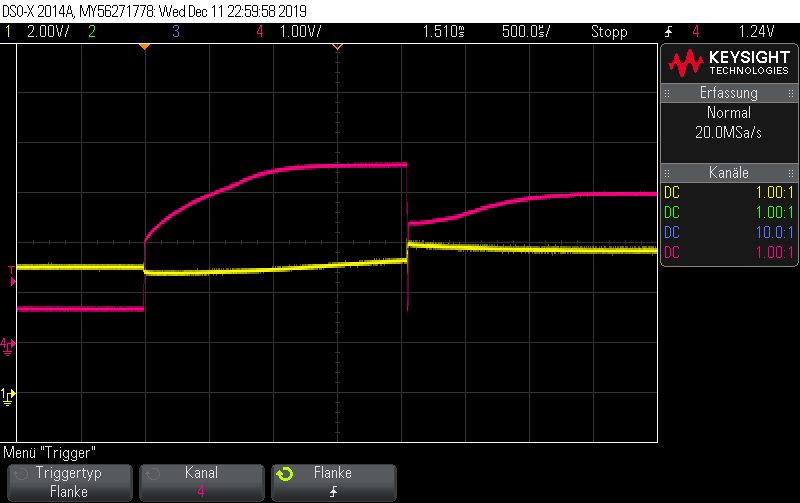
Messergebnisse PreProtoTyp/einschalt 0.png
