derTino89/RotaCon/Messergebnisse PreProtoTyp/mit halten zoom 0.png

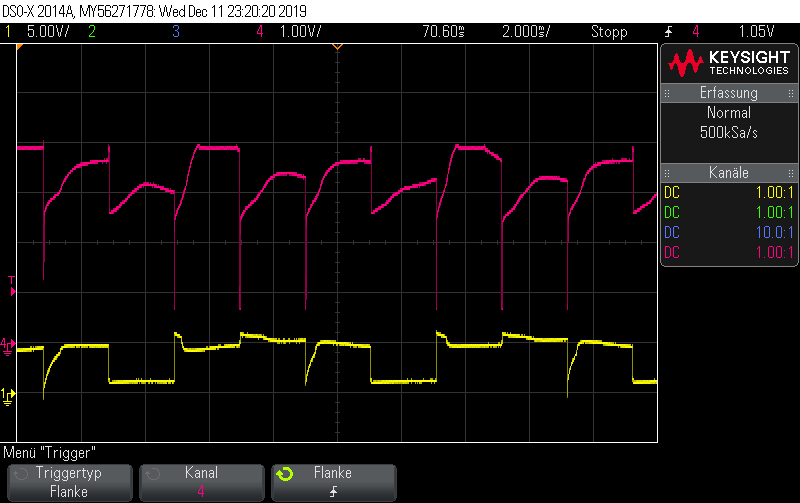
Messergebnisse PreProtoTyp/mit halten zoom 0.png
