derTino89/RotaCon/Messergebnisse PreProtoTyp/mit haltennn 0.png

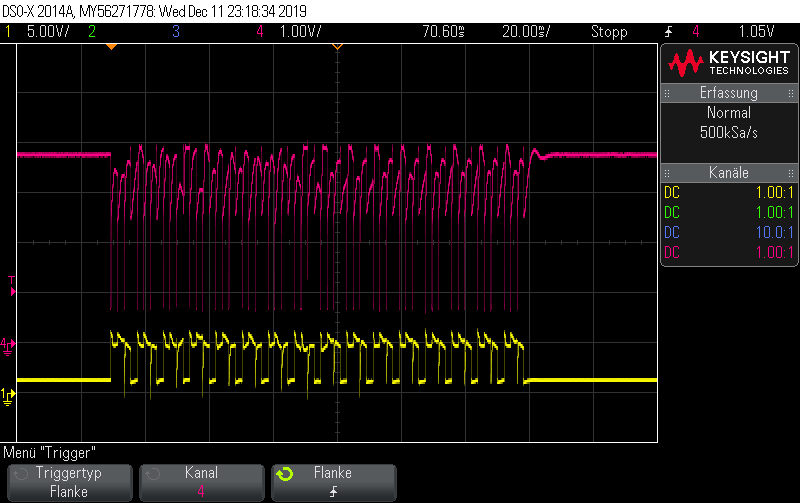
Messergebnisse PreProtoTyp/mit haltennn 0.png
