derTino89/RotaCon/Messergebnisse PreProtoTyp/ohne halten 0.png

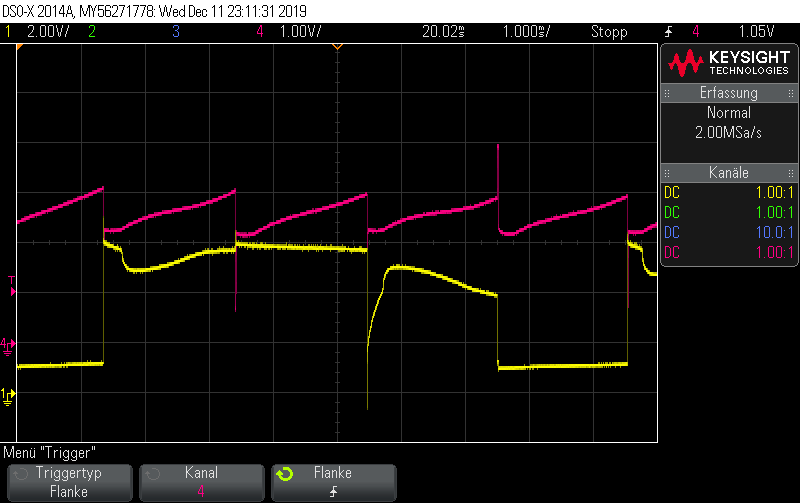
Messergebnisse PreProtoTyp/ohne halten 0.png
