derTino89/RotaCon/Messergebnisse PreProtoTyp/ohne halten zoom 0.png

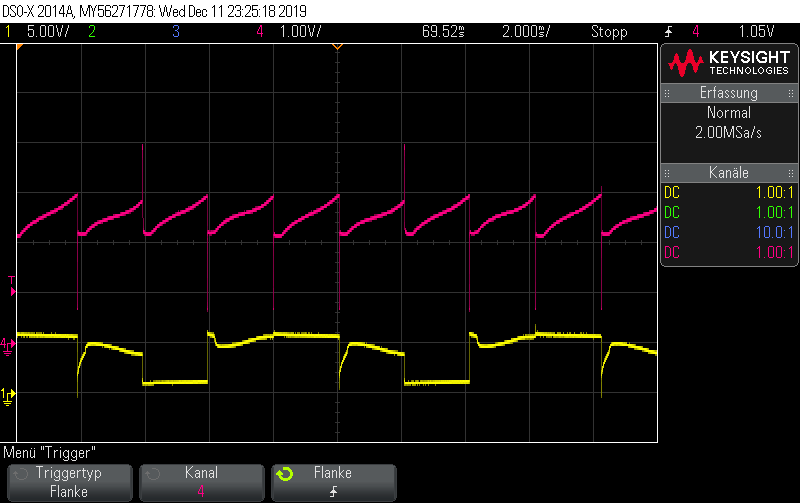
Messergebnisse PreProtoTyp/ohne halten zoom 0.png
