derTino89/RotaCon/Messergebnisse PreProtoTyp/ohne haltennn 0.png

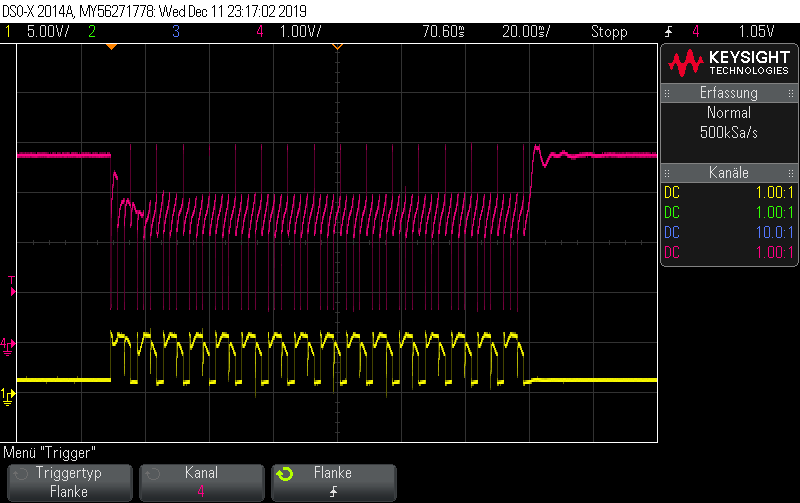
Messergebnisse PreProtoTyp/ohne haltennn 0.png
