derTino89/RotaCon/Messergebnisse PreProtoTyp/schalt 1 0.png

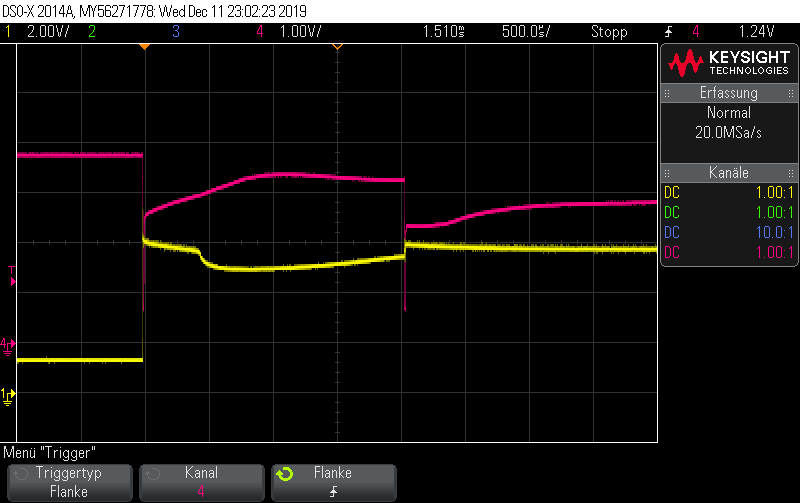
Messergebnisse PreProtoTyp/schalt 1 0.png
