derTino89/RotaCon/Messergebnisse PreProtoTyp/schalt halten 0.png

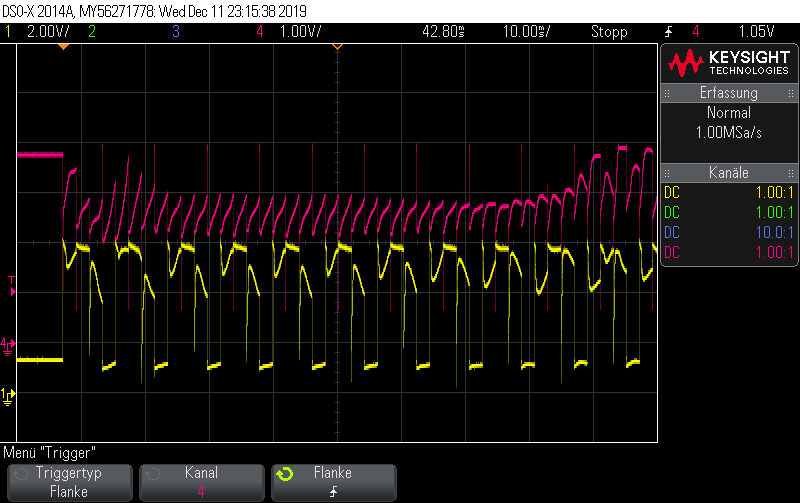
Messergebnisse PreProtoTyp/schalt halten 0.png
