derTino89/RotaCon/Messergebnisse PreProtoTyp/schaltt 0.png

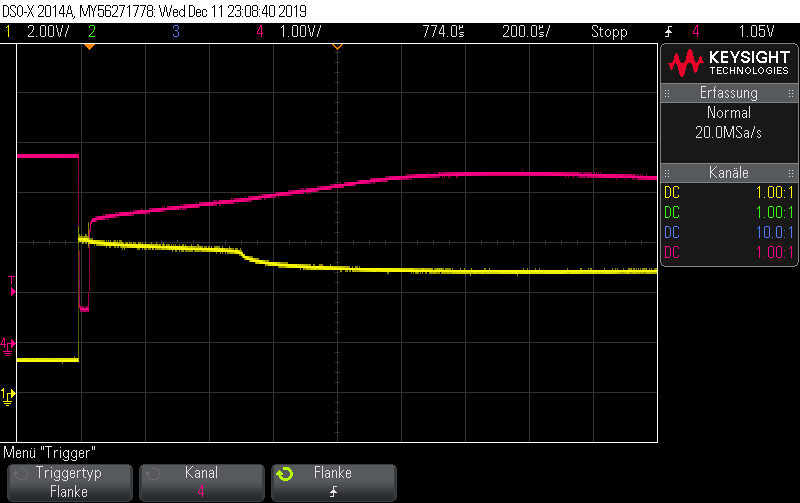
Messergebnisse PreProtoTyp/schaltt 0.png
