derTino89/RotaCon/Gehäuse/RotaCon.FCStd

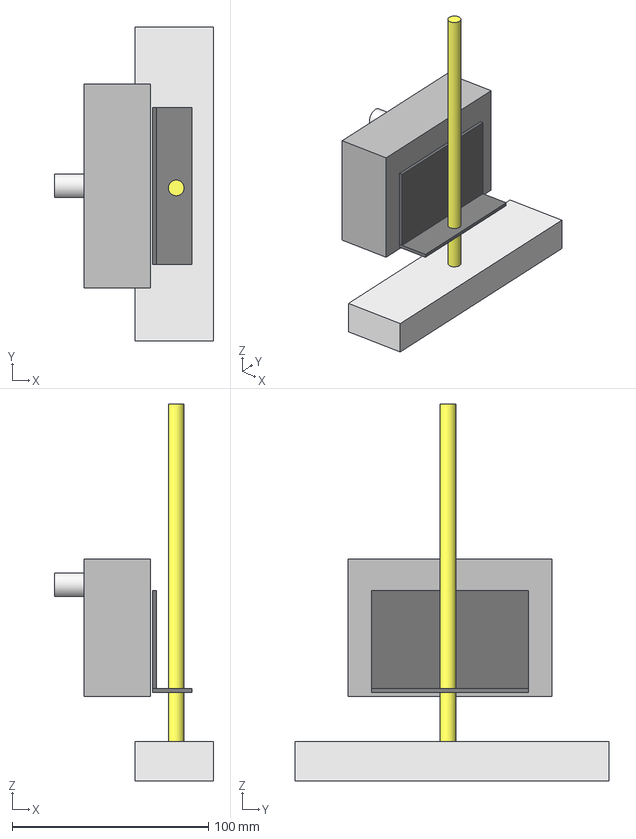
[picture p62: CAD file, 2020-02-19]
Gehäuse/RotaCon.FCStd
81.0 x 160.0 x 192.0 mm
Würfel
Würfel002
Zylinder
Zylinder001
