derTino89/RotaCon/Gehäuse/hauptgehäuse2.FCStd

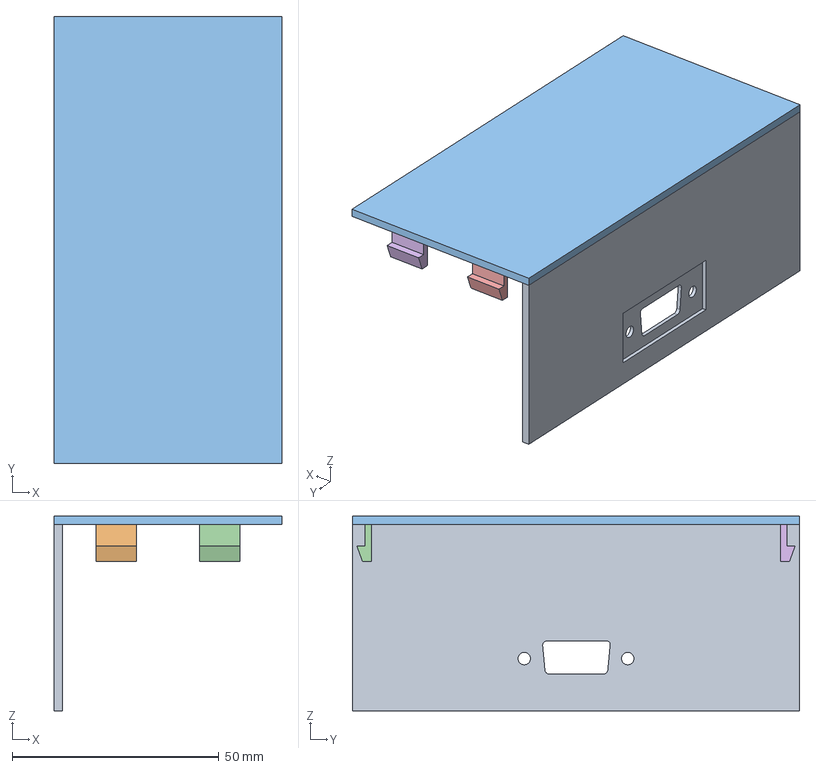
[picture p63: CAD file, 2020-02-19]
Gehäuse/hauptgehäuse2.FCStd
55.0 x 108.0 x 47.0 mm
Haken1
Deckel
Haken002
Haken003
Haken004
