derTino89/RotaCon/Gehäuse/hauptgehäuse1.FCStd

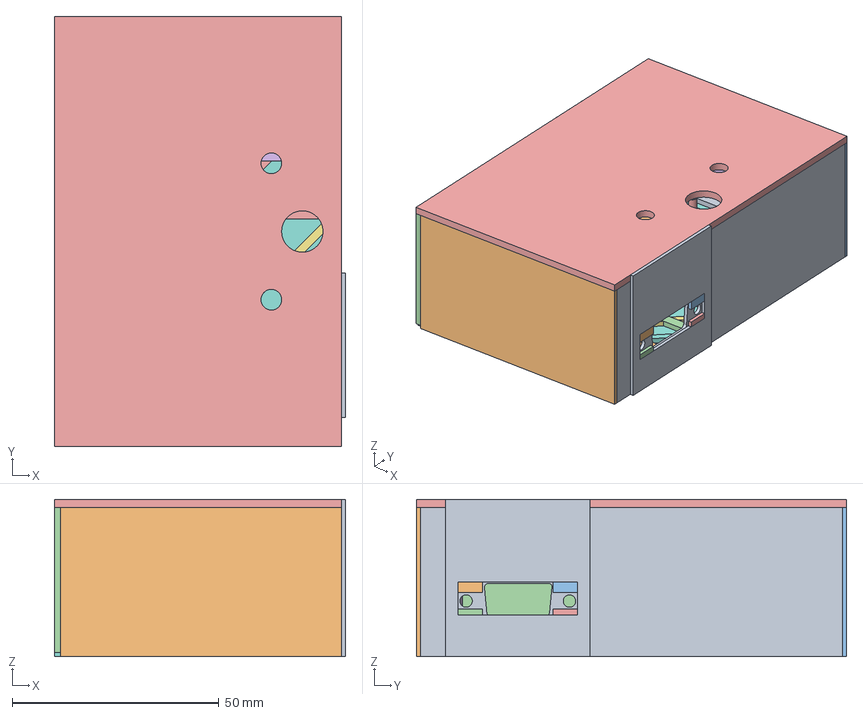
[picture p64: CAD file, 2020-02-19]
Gehäuse/hauptgehäuse1.FCStd
70.5 x 104.0 x 38.0 mm
seite1
seite002
haltenubsi Platine2
haltenubsi Platine3
haltenubsi Platine005
haltenubsi Platine006
boden
stecknubsi
Würfel001
Würfel002
Würfel003
Würfel004
Würfel005
Würfel006
Würfel007
Würfel008
Würfel010
Würfel012
Würfel015
Würfel009
Würfel014
Würfel013
Würfel011
Würfel016
Würfel018
Würfel017
Würfel019
Würfel020
Würfel021
Würfel022
Würfel023
Würfel024
Würfel025
Würfel026
Würfel027
Würfel028
Würfel029
Würfel030
Würfel031
Würfel032
Würfel033
Würfel034
Würfel035
Würfel036
Würfel040
Würfel041
Würfel038
Würfel042
Würfel039
Würfel037
Platte
Verst
Verst001
Verst002
Würfel053 x 2
Würfel054 x 2
Würfel055 x 2
Würfel056 x 2
