derTino89/RotaCon/Gehäuse/Gehäuse1B.stl

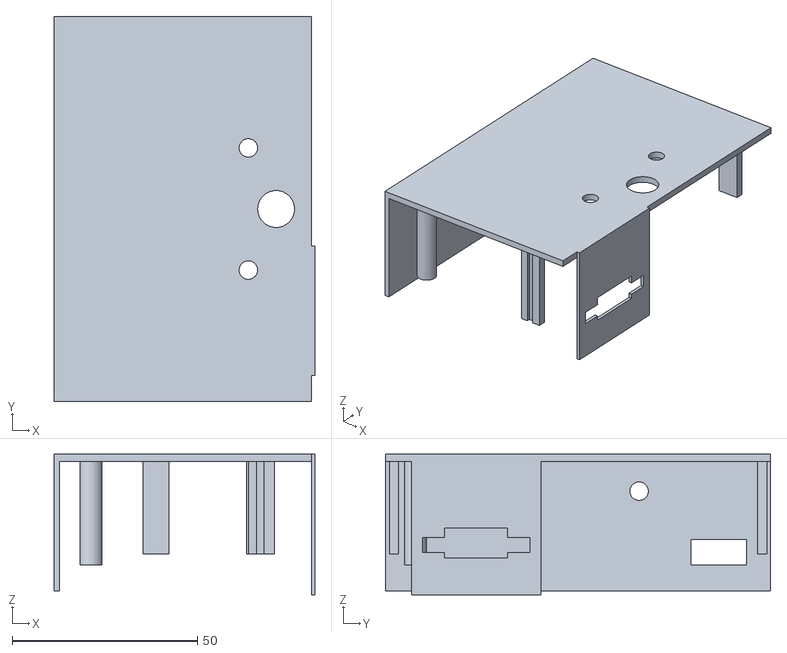
[picture p65: CAD file, 2020-01-16]
Gehäuse/Gehäuse1B.stl
70.5 x 104.0 x 38.0
