derTino89/RotaCon/Gehäuse/gehäuse1Neu.stl

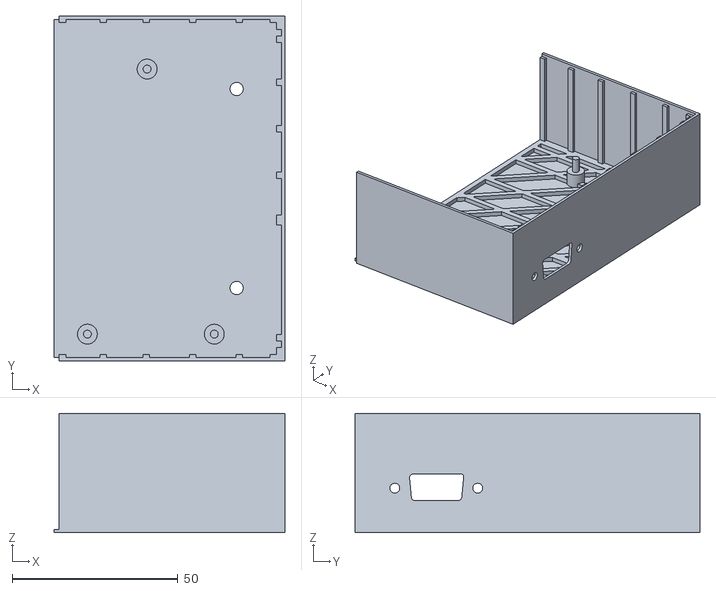
[picture p66: CAD file, 2020-01-16]
Gehäuse/gehäuse1Neu.stl
69.5 x 104.0 x 36.0
