derTino89/RotaCon/Gehäuse/CE3_Gehause2Unten.3mf

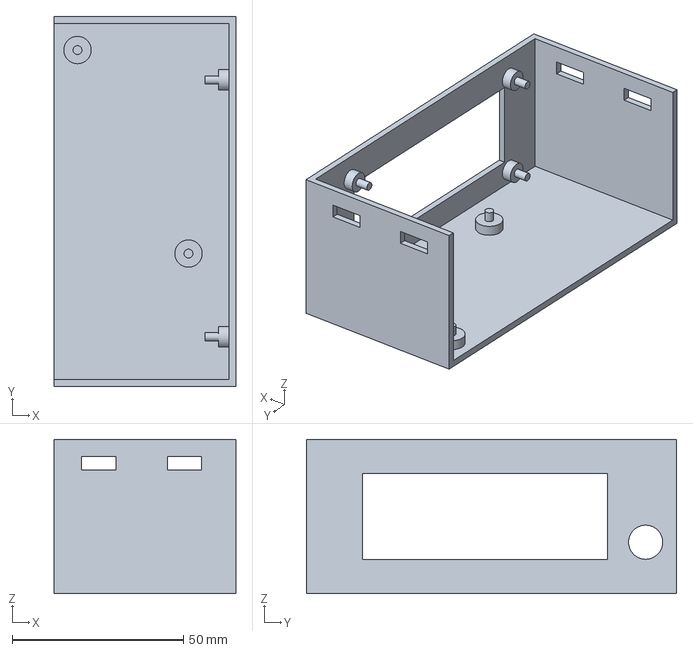
[picture p67: CAD file, 2020-01-16]
Gehäuse/CE3_Gehause2Unten.3mf
53.0 x 108.0 x 45.0 mm
