derTino89/RotaCon/(list of files, cad)

Other CAD files:
Gehäuse/Gehäuse2Oben.stl
Gehäuse/CE3_gehause1Neu.3mf
Gehäuse/CE3_Gehause2Oben.3mf
Gehäuse/Gehäuse2Unten.stl
