derTino89/RotaCon/Gehäuse/Display_Gehäuse.PDF

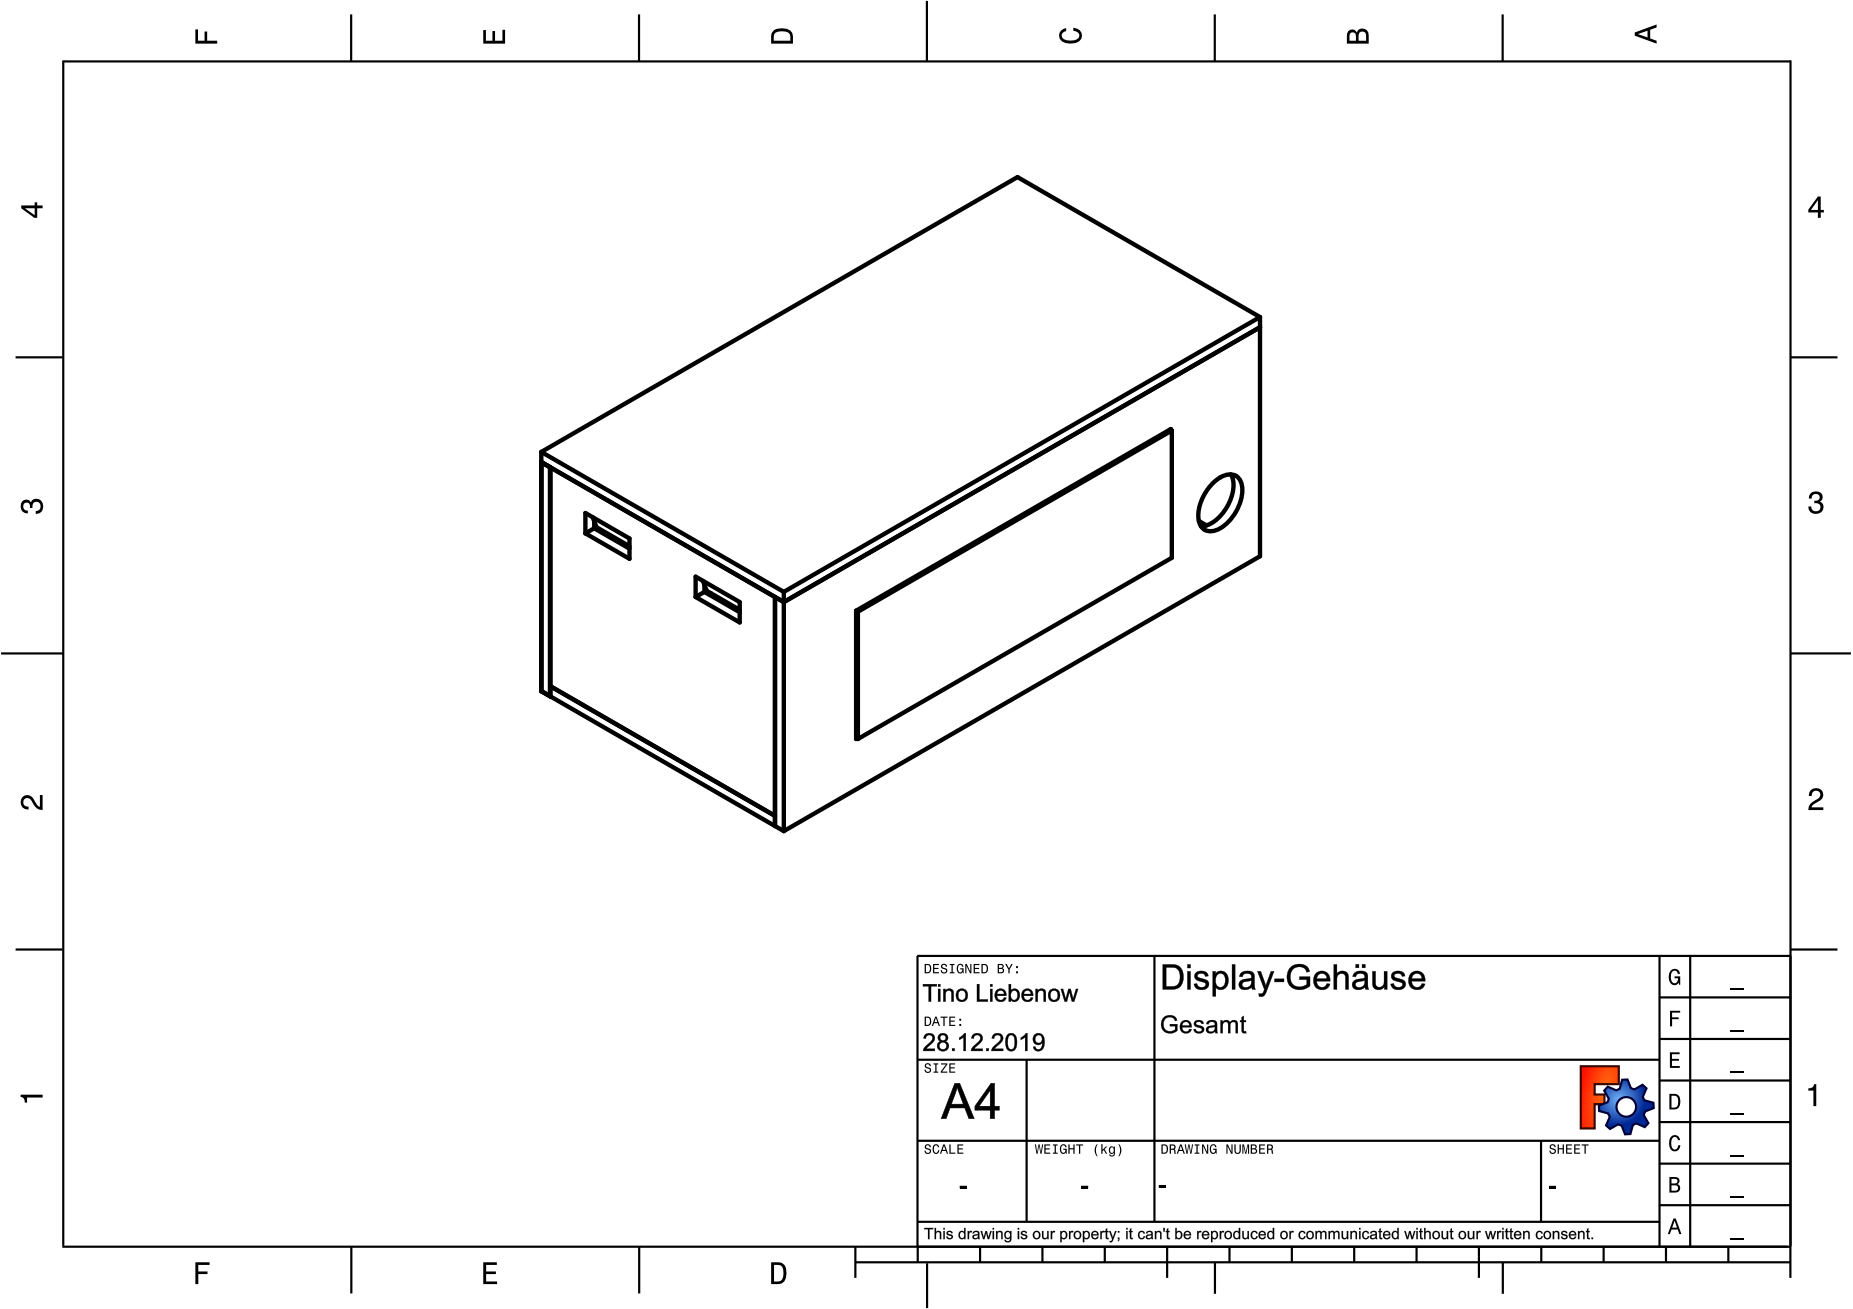
[picture p77: page 1]
