derTino89/RotaCon/Gehäuse/Display_Gehäuse_Oben.PDF

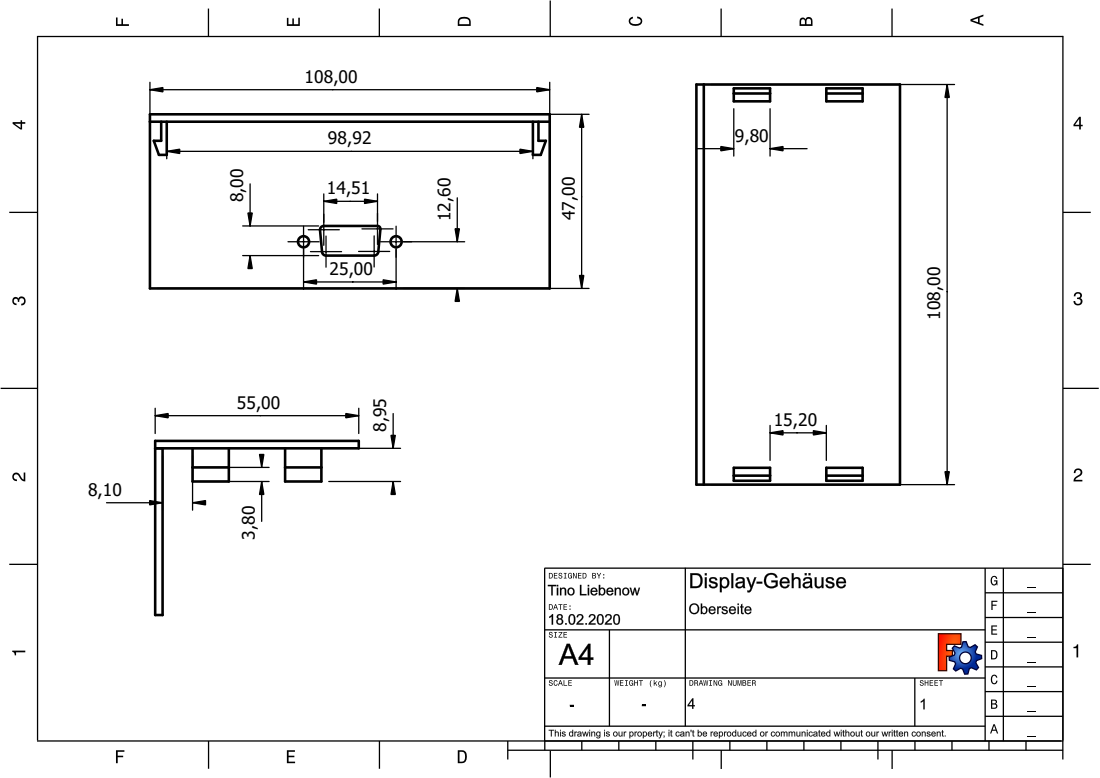
[picture p78: page 1]
