derTino89/RotaCon/Gehäuse/Display_Gehäuse_Unten.PDF

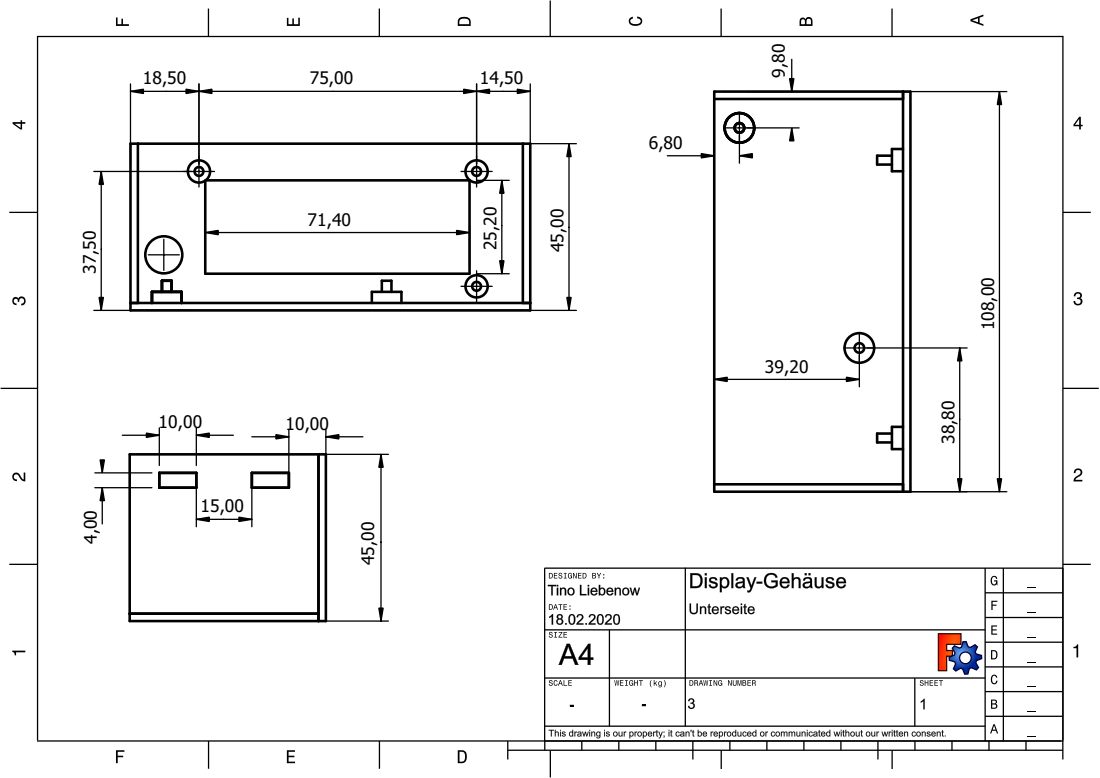
[picture p79: page 1]
