derTino89/RotaCon/Gehäuse/Motor_Gehäuse.PDF

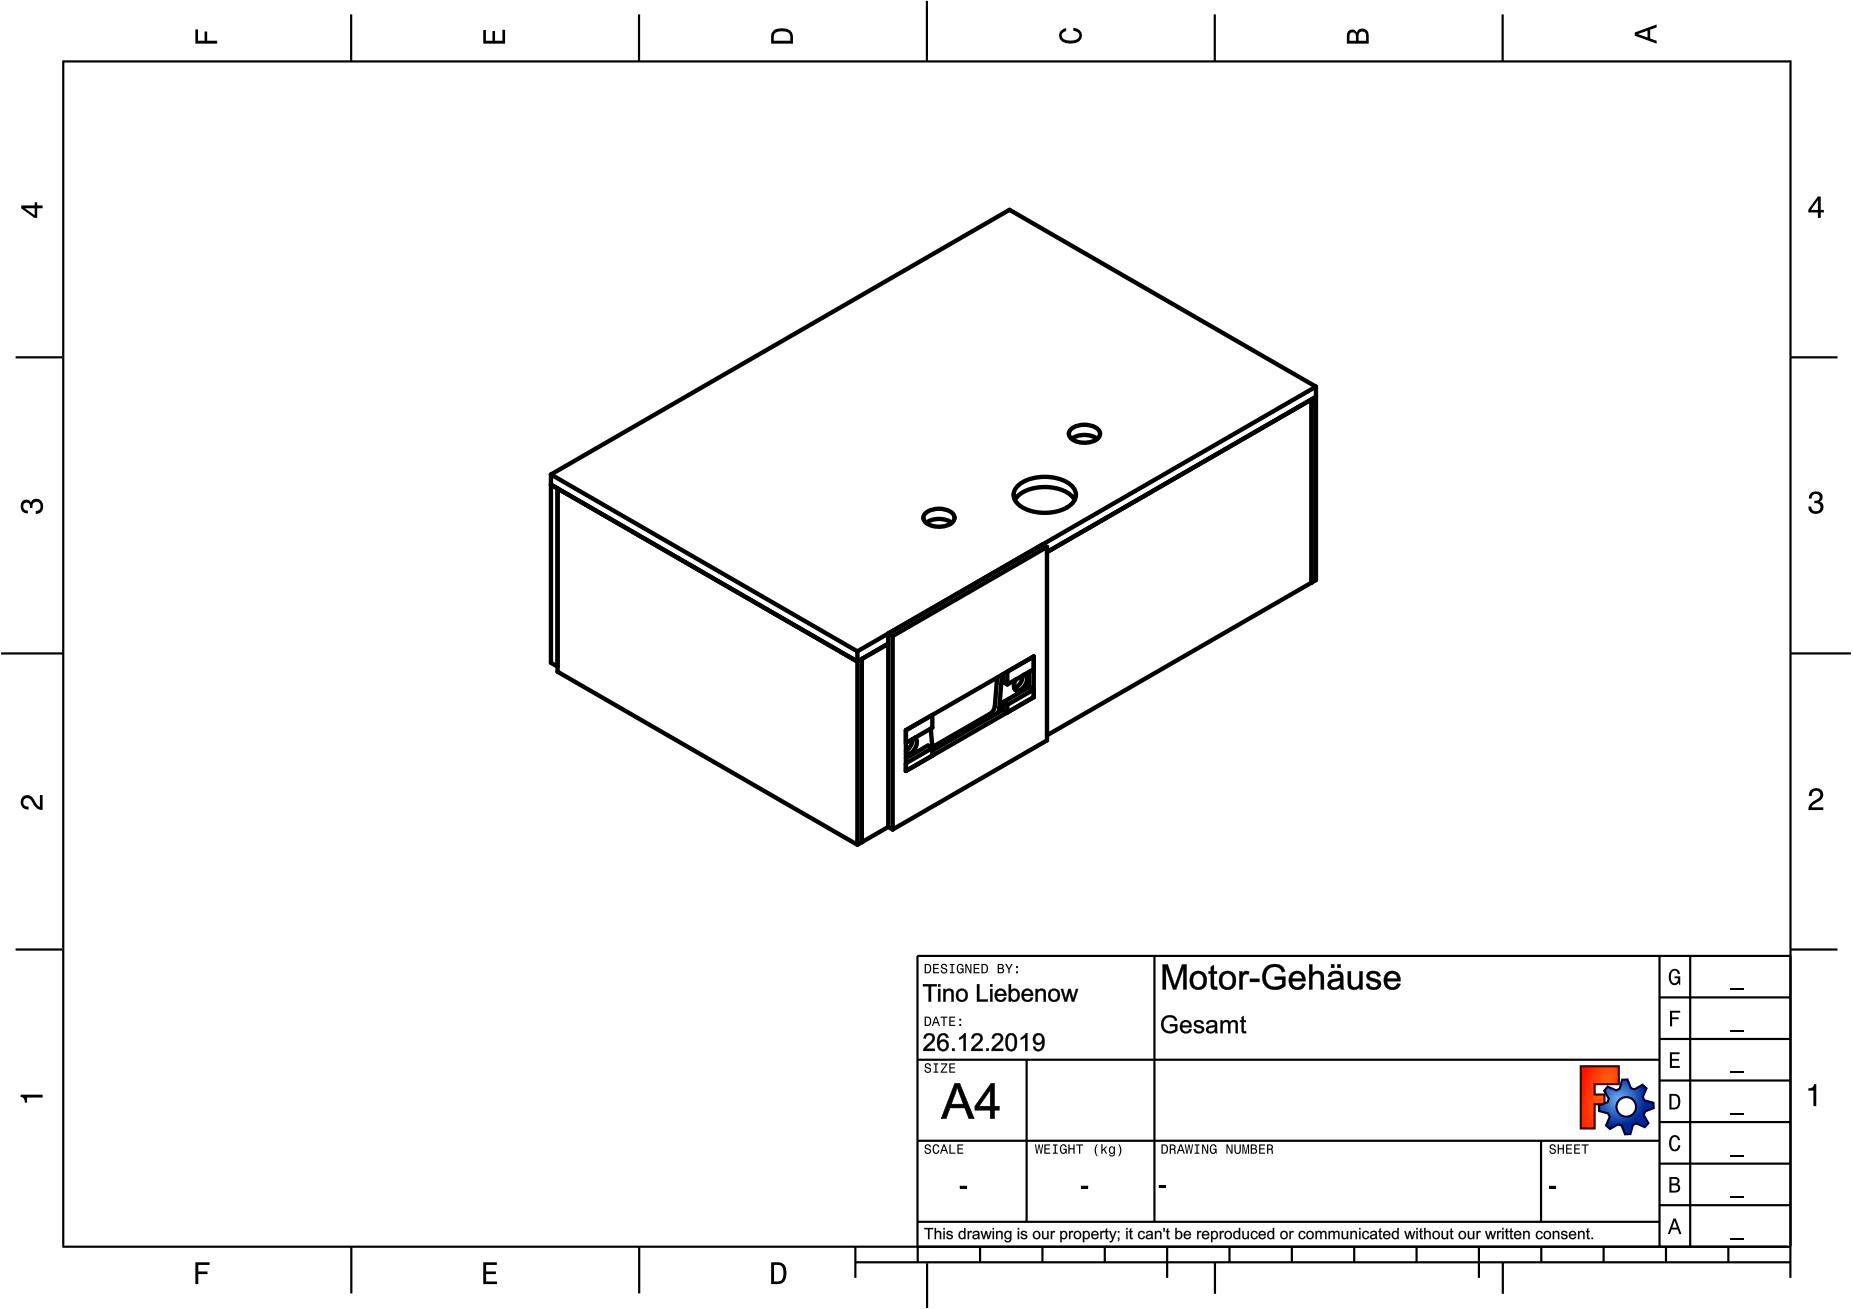
[picture p80: page 1]
