derTino89/RotaCon/Gehäuse/Motor_Gehäuse_Oben.PDF

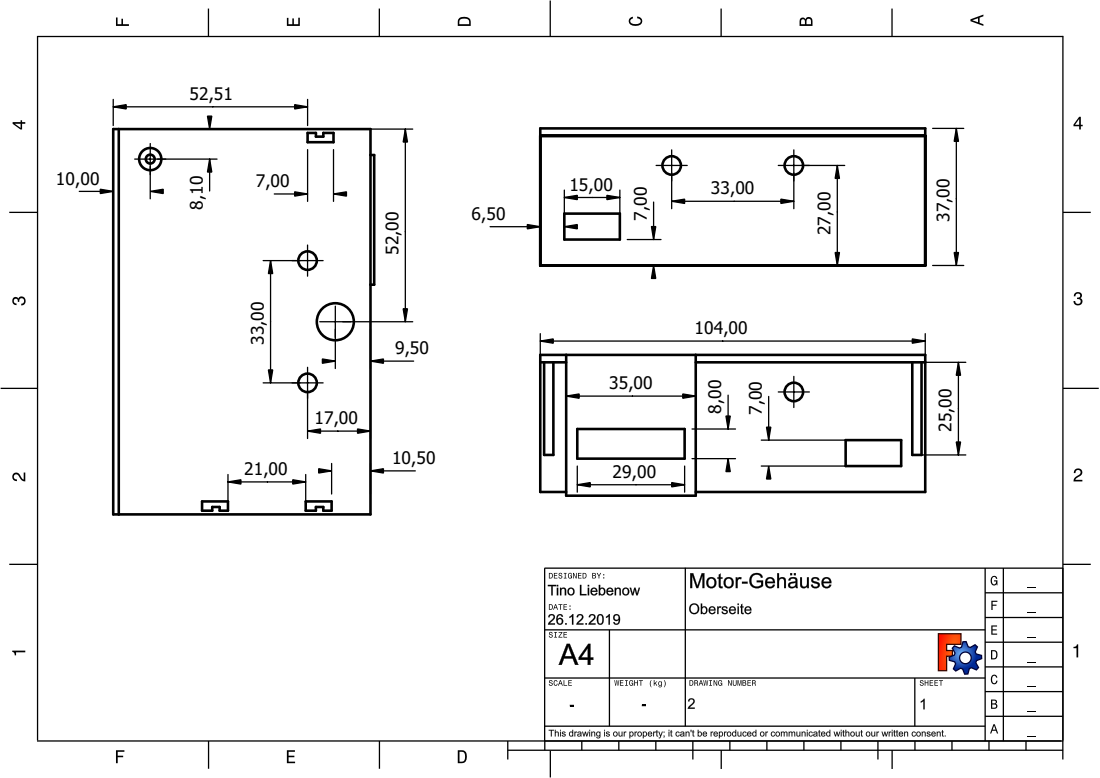
[picture p81: page 1]
