derTino89/RotaCon/Gehäuse/Motor_Gehäuse_Unten.PDF

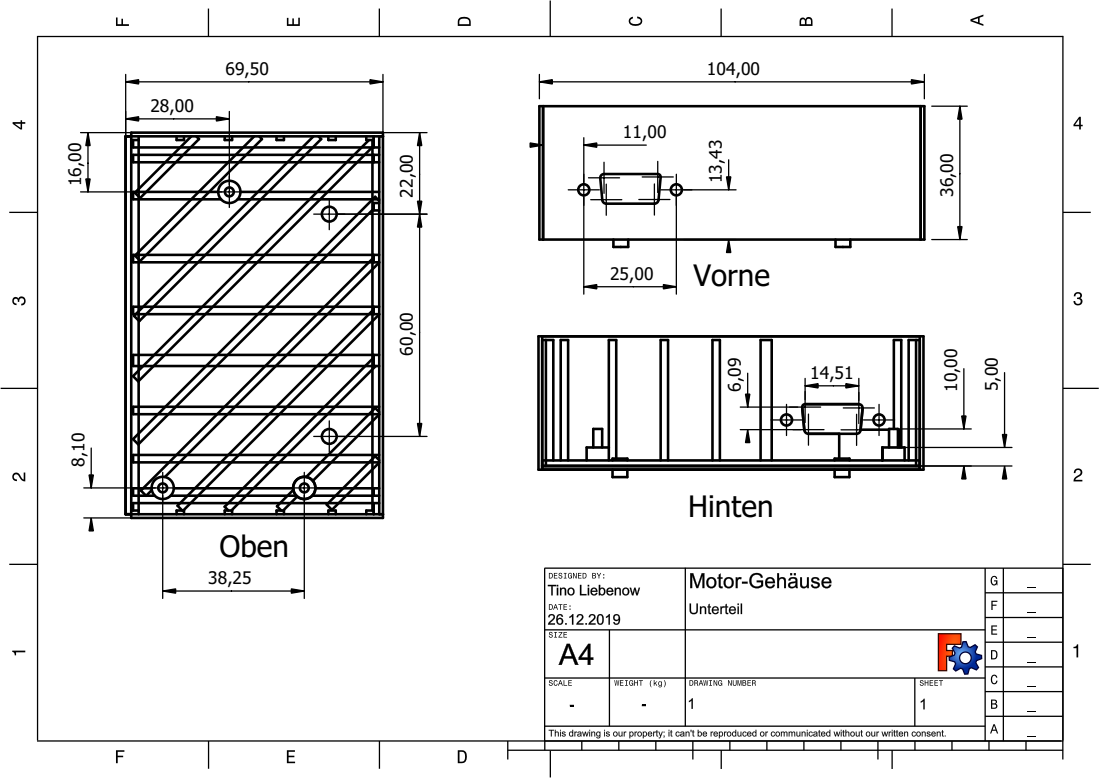
[picture p82: page 1]
V orn; Hinte
