derTino89/RotaCon/Gehäuse/RotaCon.PDF

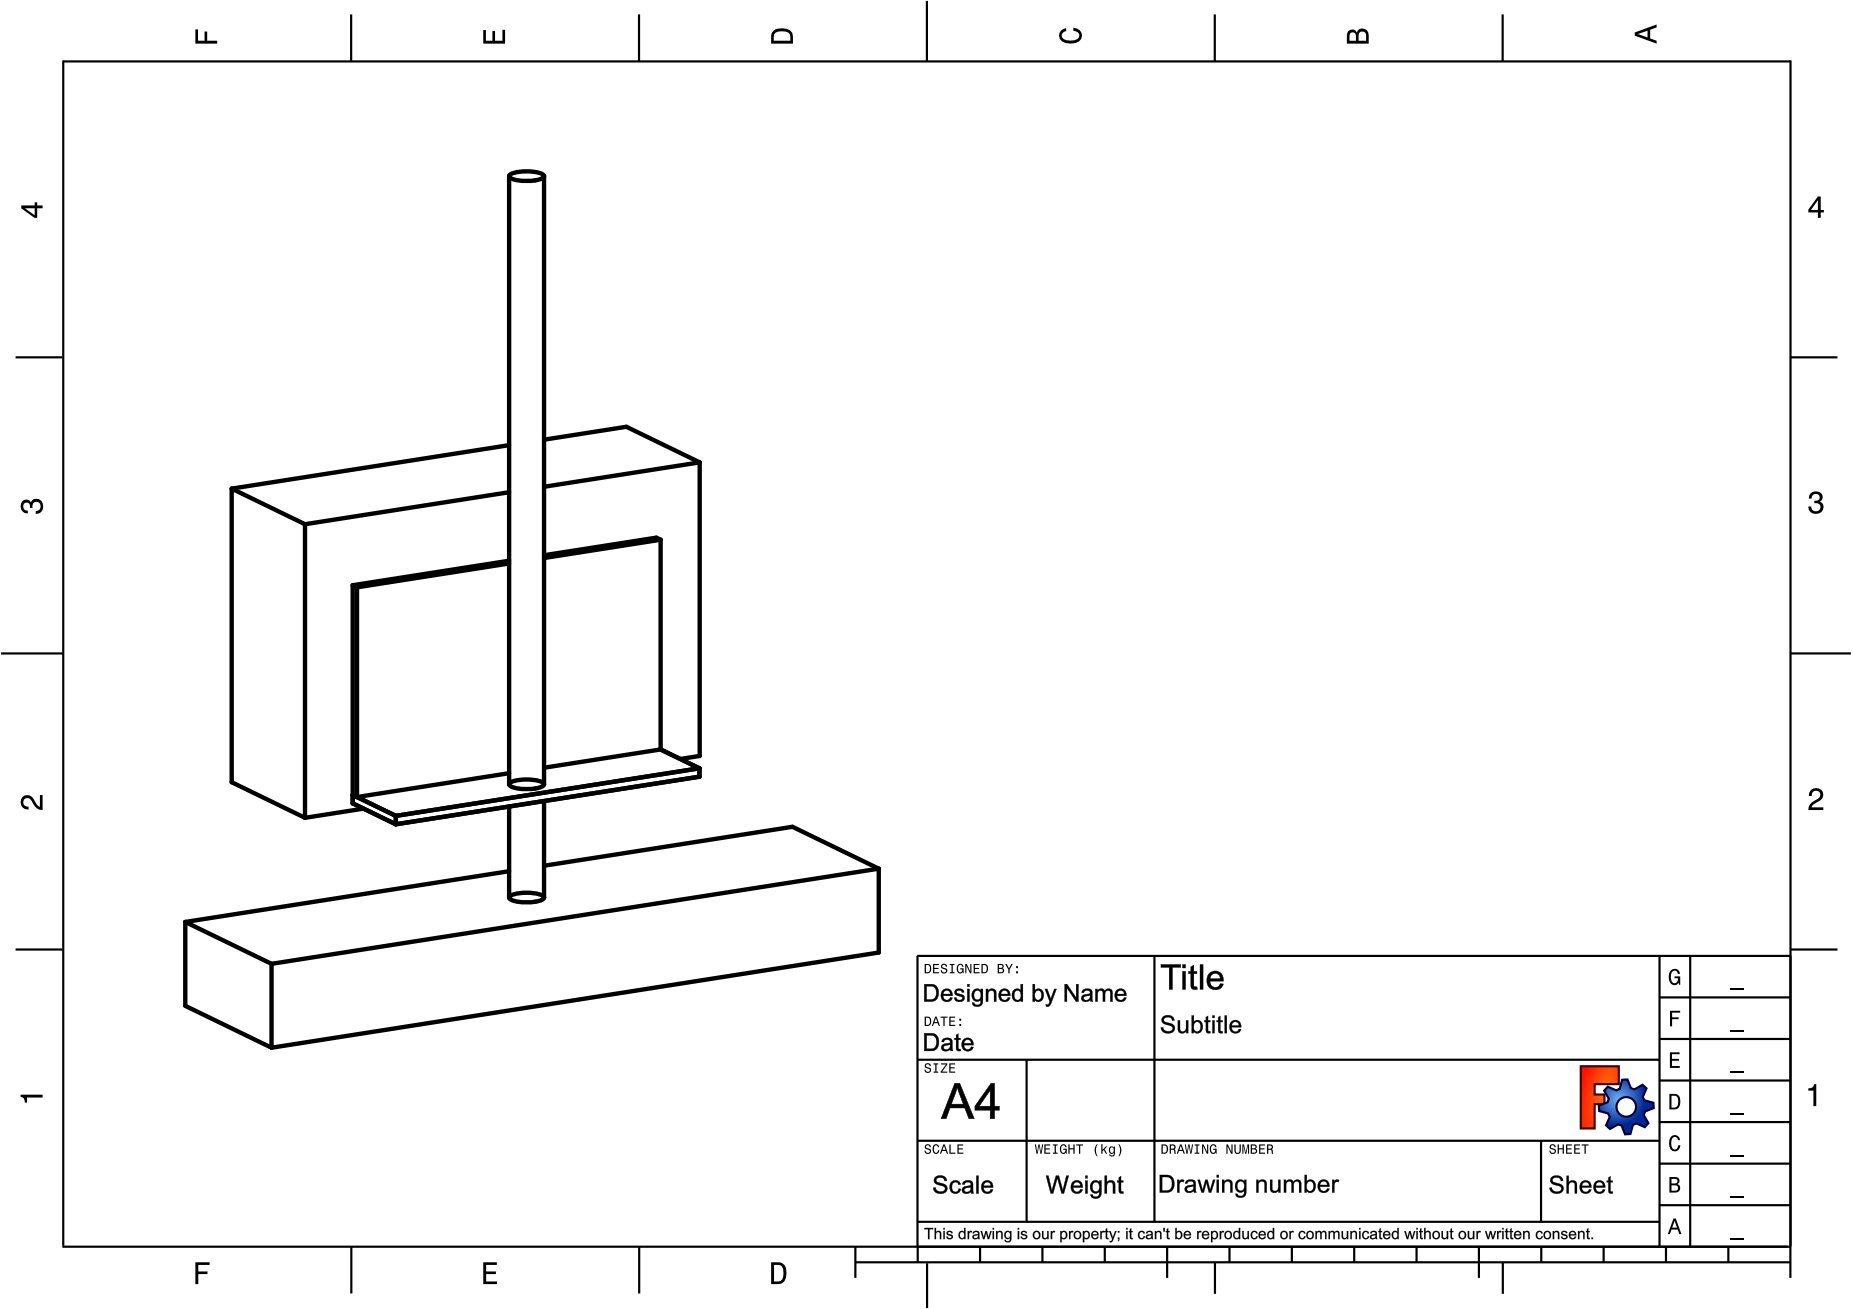
[picture p83: page 1]
