derTino89/RotaCon/Documentation/docs/Data_NanoV3_sch.pdf

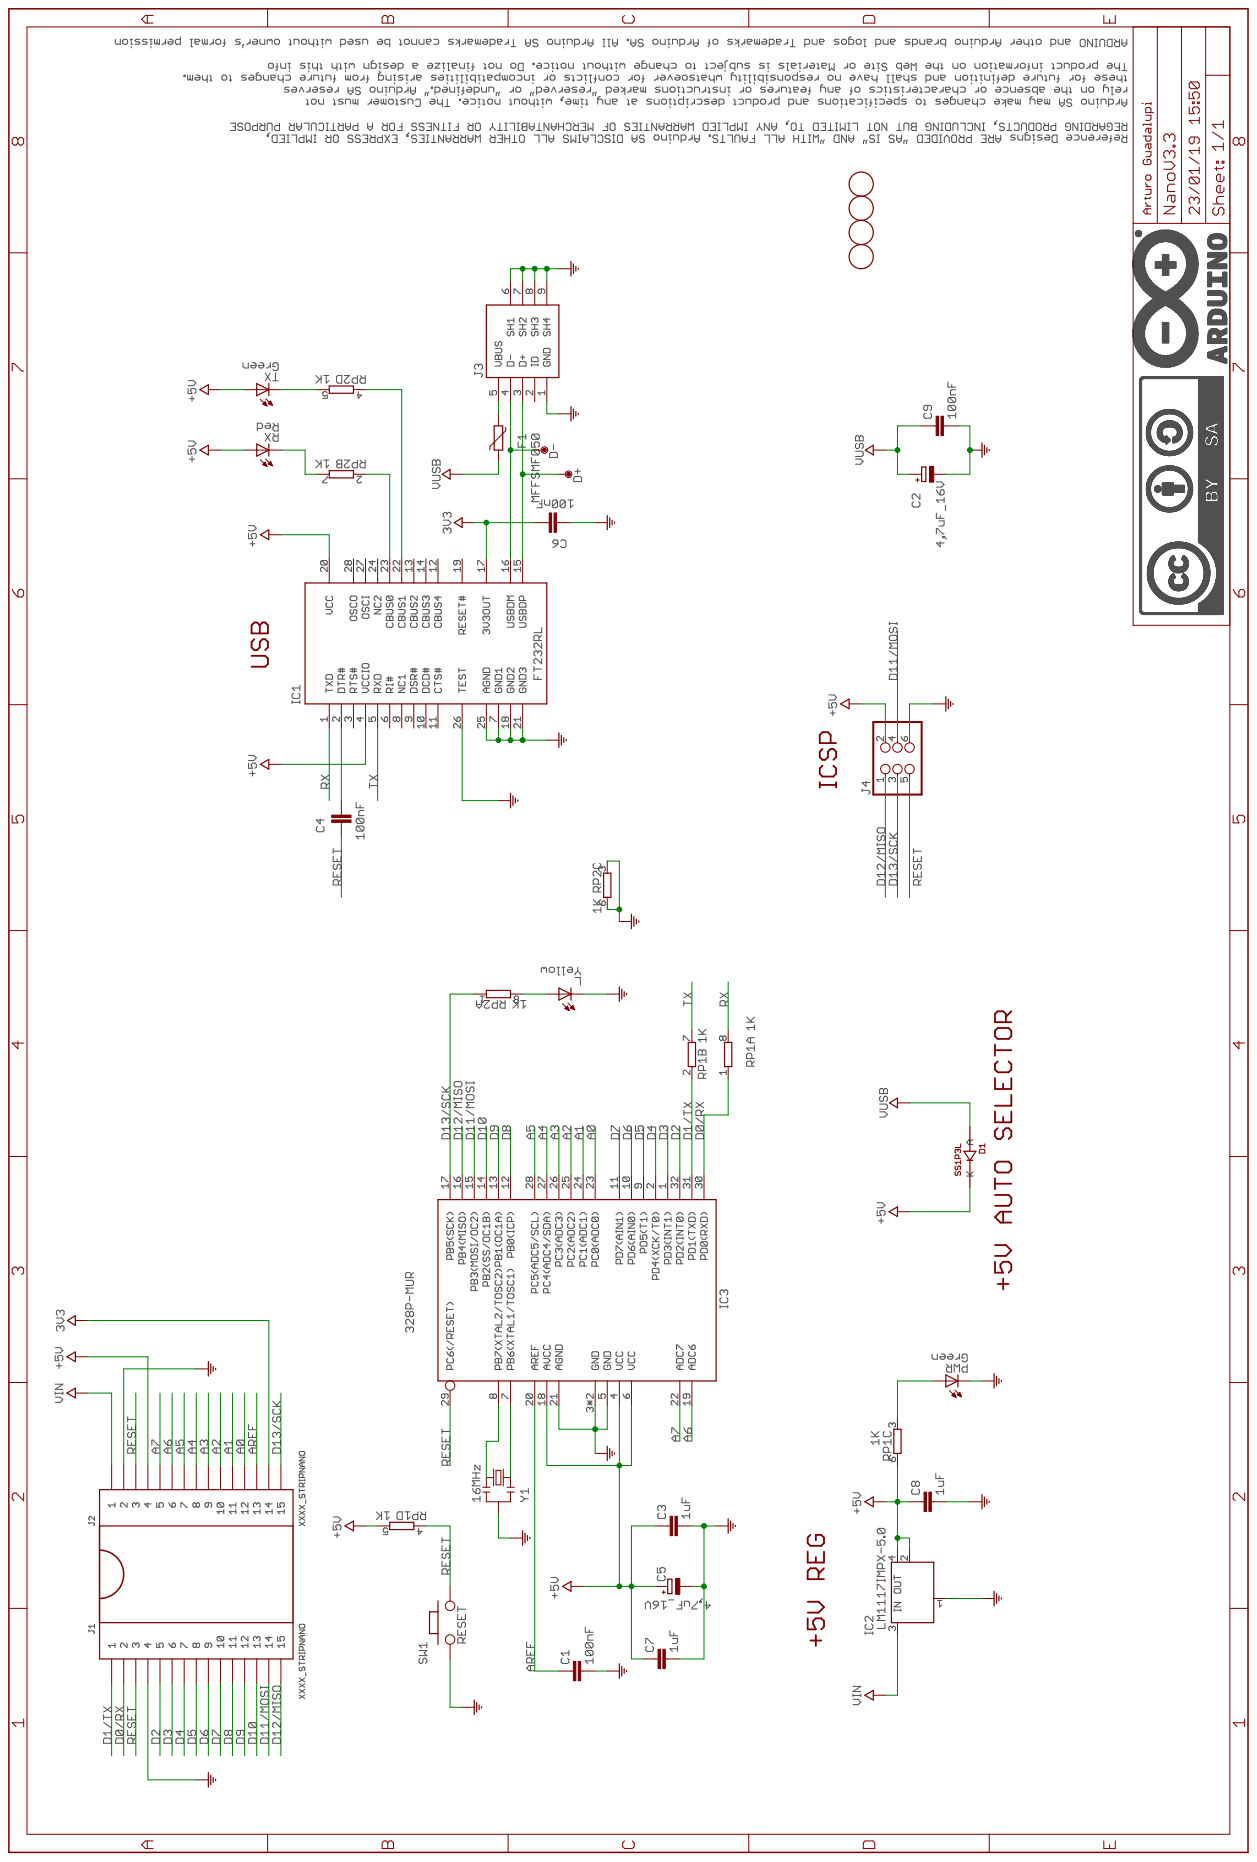
[picture p84: page 1]
