derTino89/RotaCon/Documentation/docs/Display_Case_Oben.PDF

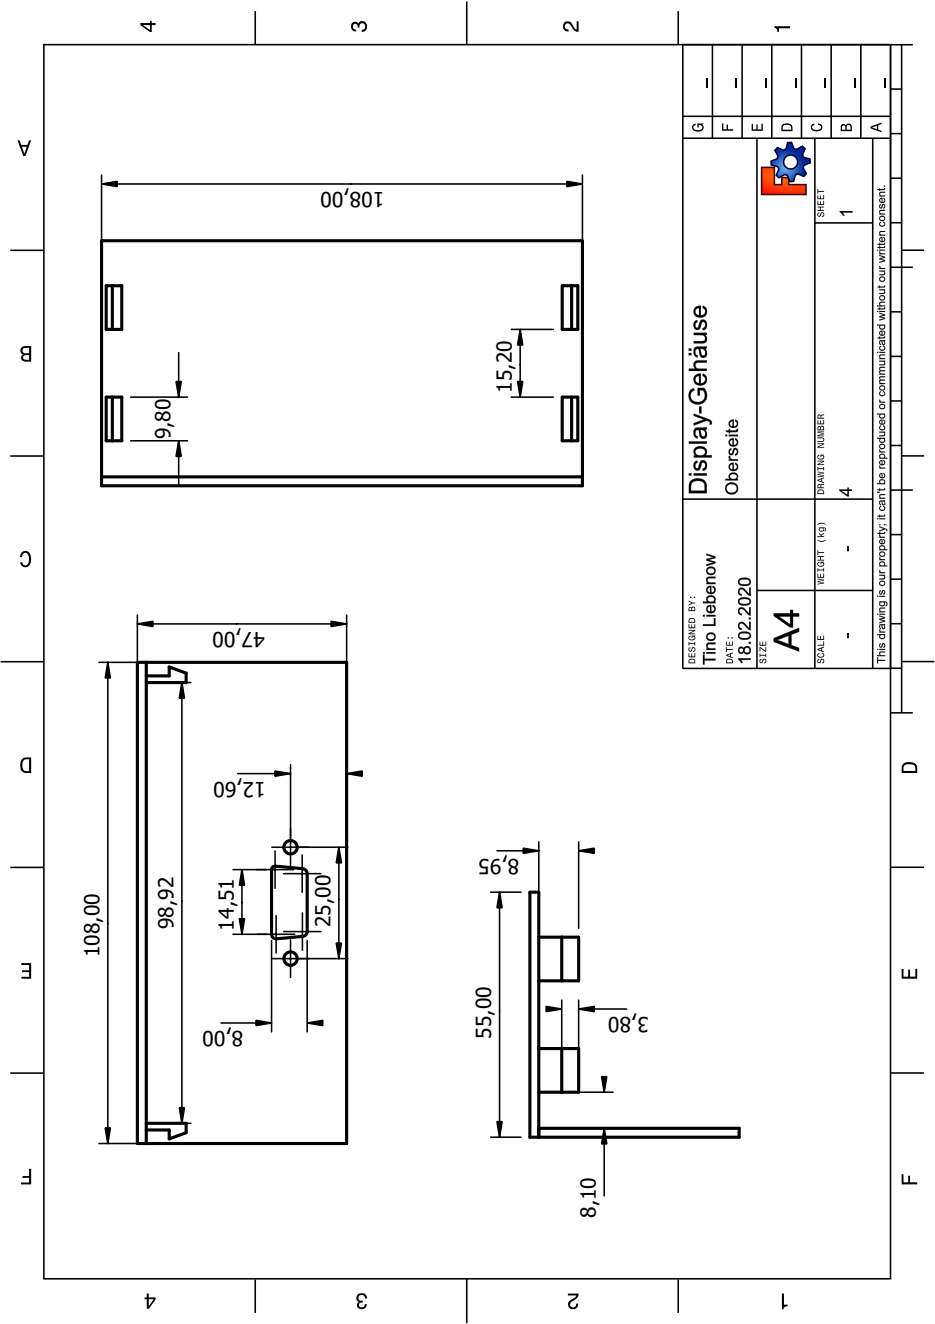
[picture p85: page 1]
