derTino89/RotaCon/Documentation/docs/Display_Case_Unten.PDF

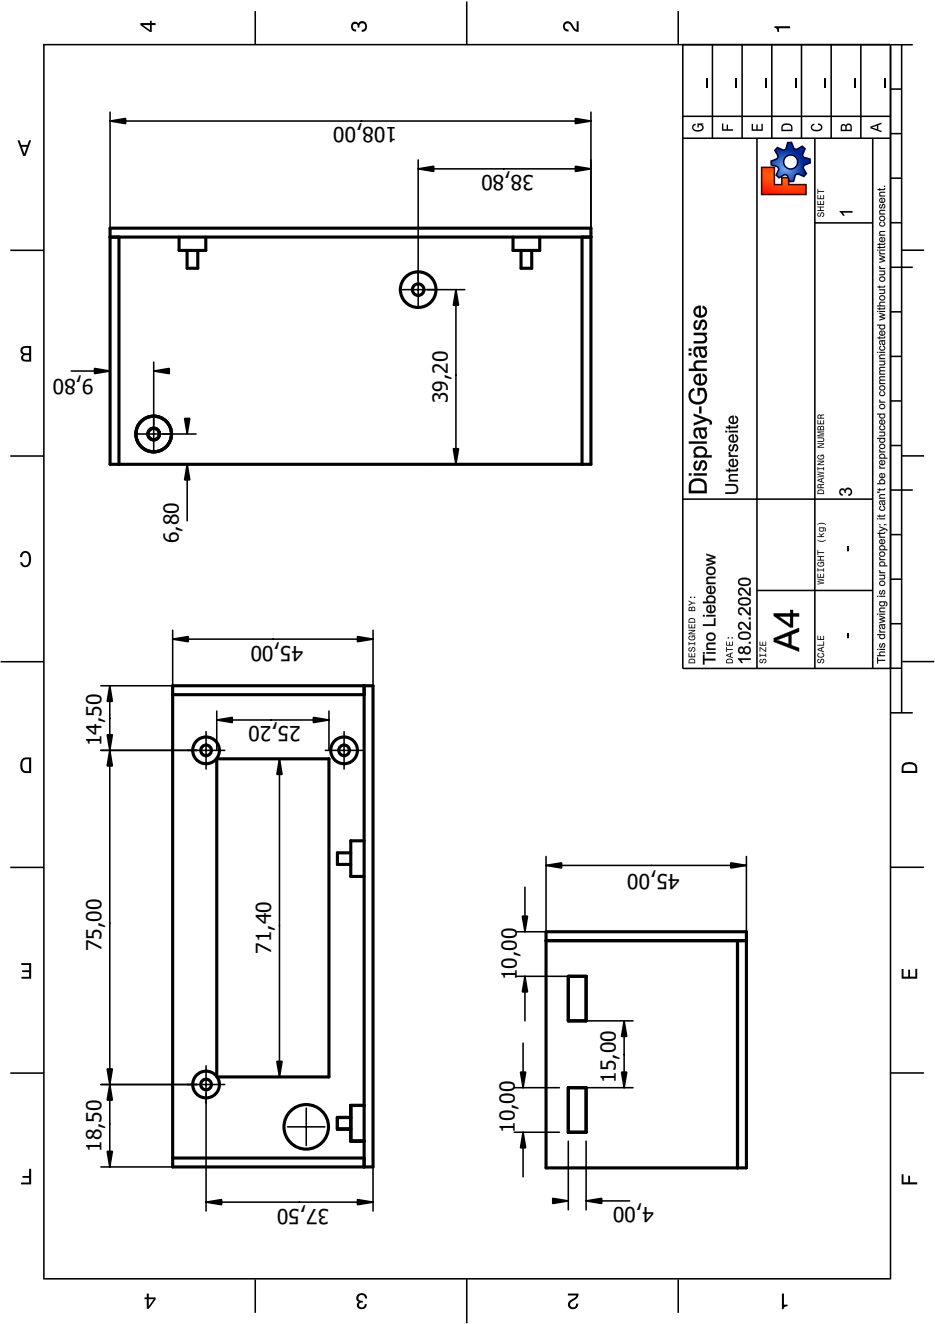
[picture p86: page 1]
