derTino89/RotaCon/Documentation/docs/Motor_Case_Oben.PDF

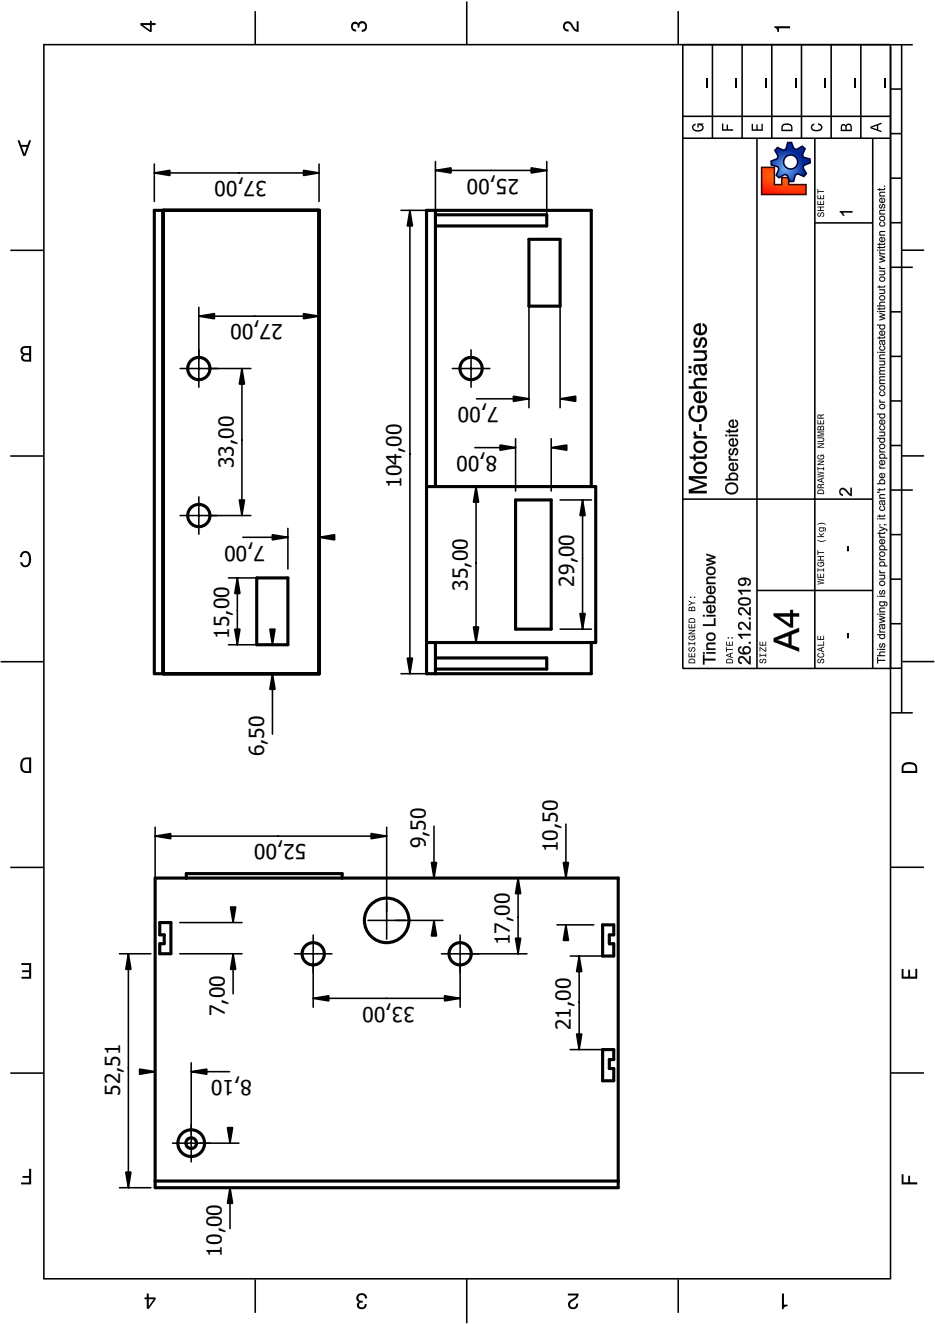
[picture p87: page 1]
