derTino89/RotaCon/Documentation/docs/Motor_Case_Unten.PDF

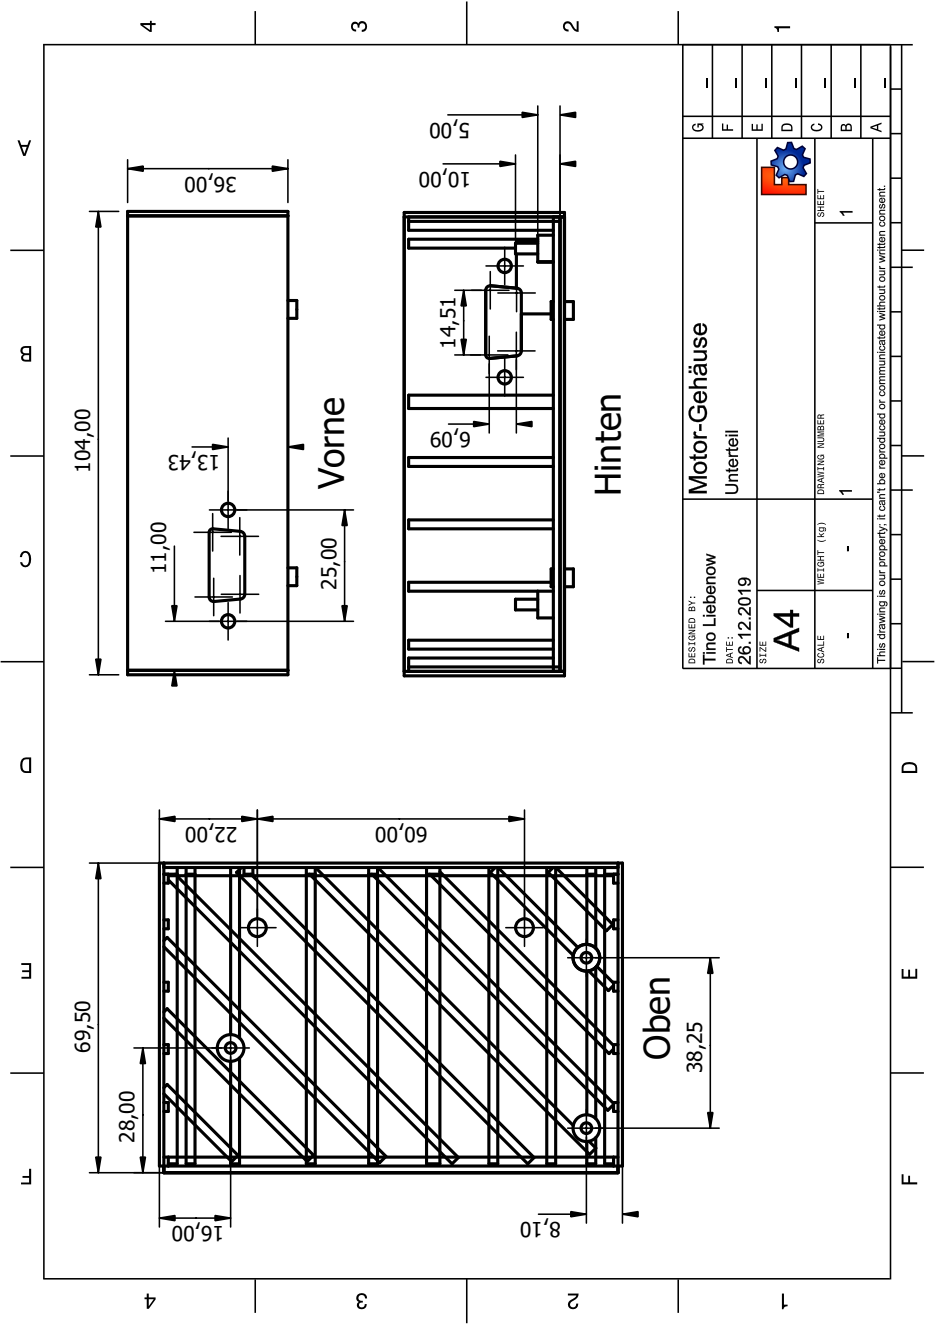
[picture p88: page 1]
orn; Hinte
