derTino89/RotaCon/Documentation/docs/Motorsteuerung.pdf

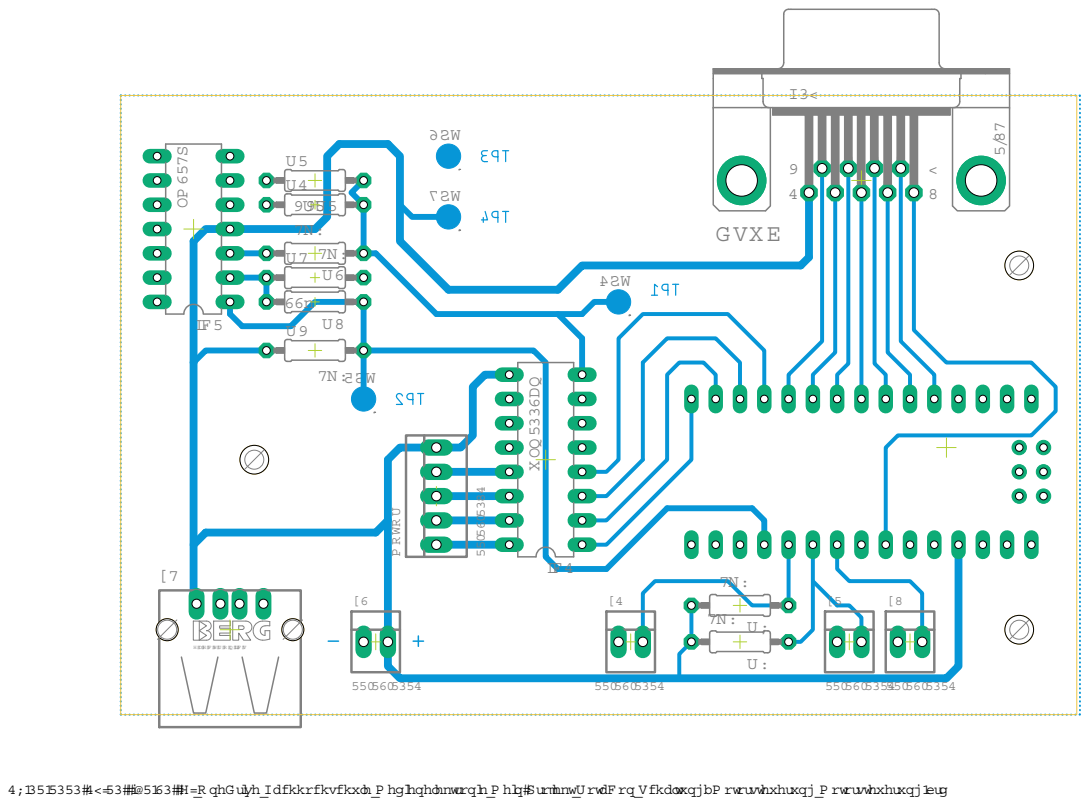
[picture p89: page 1]

O neD rive\Fachhochschule\M edienelektronik\M ein Projekt\R otaC on\Schaltung_M otorsteuerung\M otorsteuerung.brd
