derTino89/RotaCon/Schaltung_Display/Für Doku/displayhuhu.brd

## EAGLE design Schaltung_Display/Für Doku/displayhuhu.brd (2020-02-13)

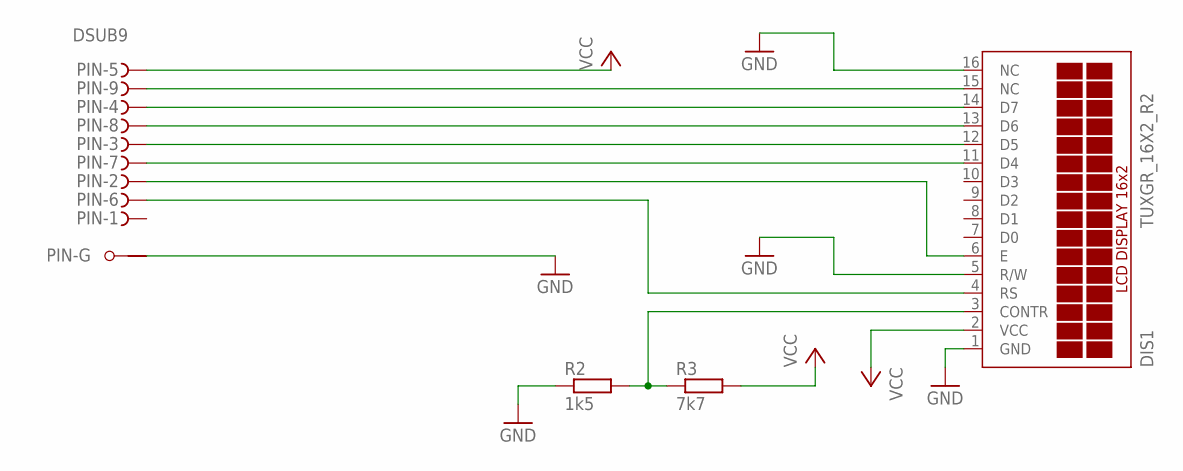
[picture p90: schematic displayhuhu.sch]

Parts:
DIS1: TUXGR_16X2_R2
PIN: DSUB9; F09HP
R2: 1k5; 0207/10
R3: 7k7; 0207/10

Connections:
GND: DIS1.1 (GND), DIS1.5 (R/W), DIS1.16 (NC), PIN.G1, R2.1
unnamed: DIS1.6 (E), PIN.2 (F)
unnamed: DIS1.11 (D4), PIN.7 (F)
unnamed: DIS1.12 (D5), PIN.3 (F)
unnamed: DIS1.13 (D6), PIN.8 (F)
unnamed: DIS1.14 (D7), PIN.4 (F)
unnamed: DIS1.15 (NC), PIN.9 (F)
unnamed: DIS1.4 (RS), PIN.6 (F)
unnamed: DIS1.3 (CONTR), R2.2, R3.1
VCC: DIS1.2 (VCC), PIN.5 (F), R3.2

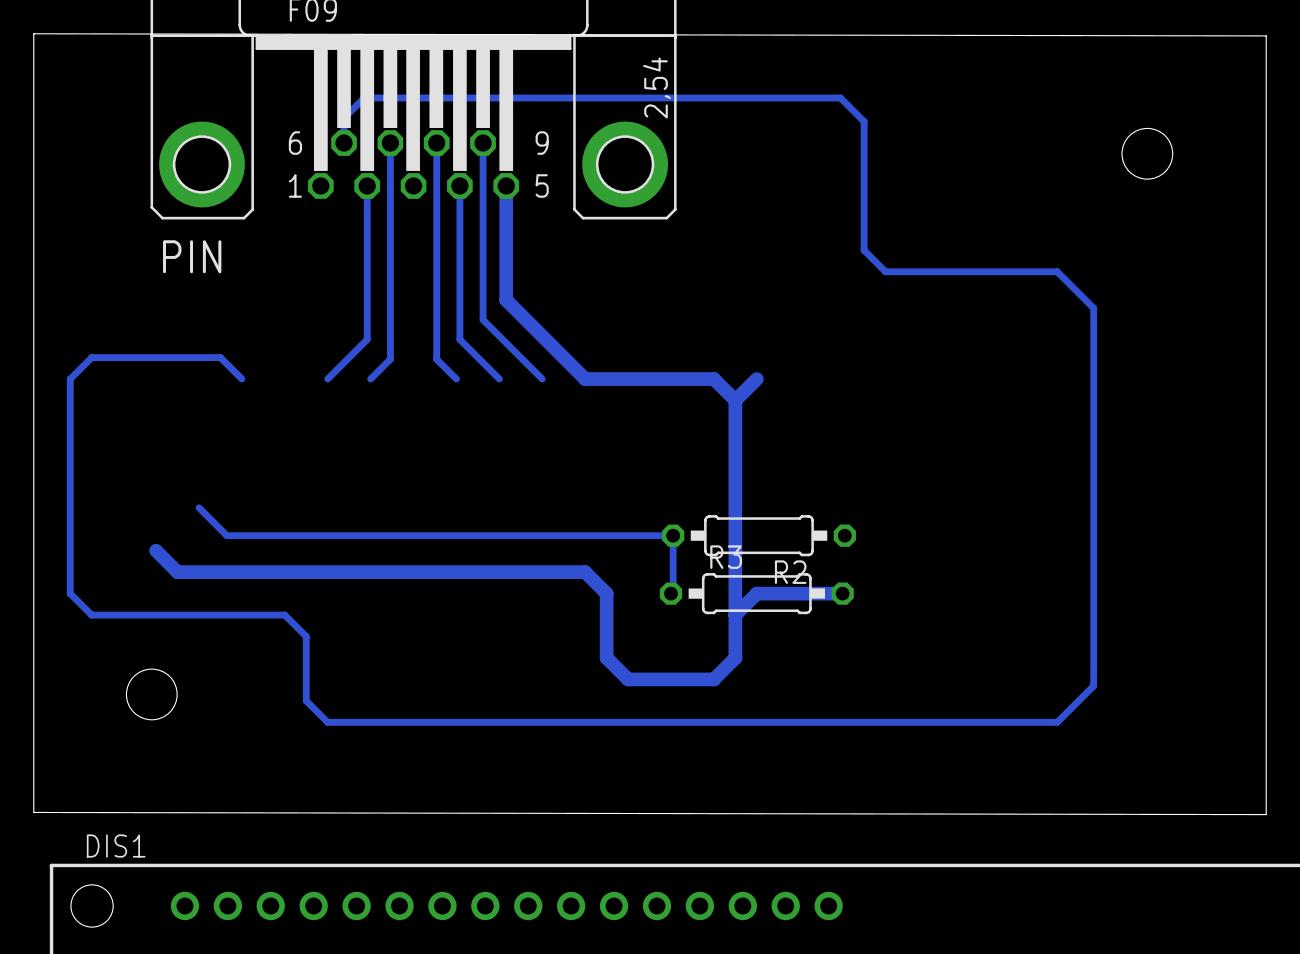
[picture p91: board displayhuhu.brd from above]

Board: 2 copper layers, 72.9 x 46.2 mm, 4 parts (0 on the bottom side), 10 nets.
