derTino89/RotaCon/Schaltung_Display/Für Doku/display.brd

## EAGLE design Schaltung_Display/Für Doku/display.brd (2020-01-16)

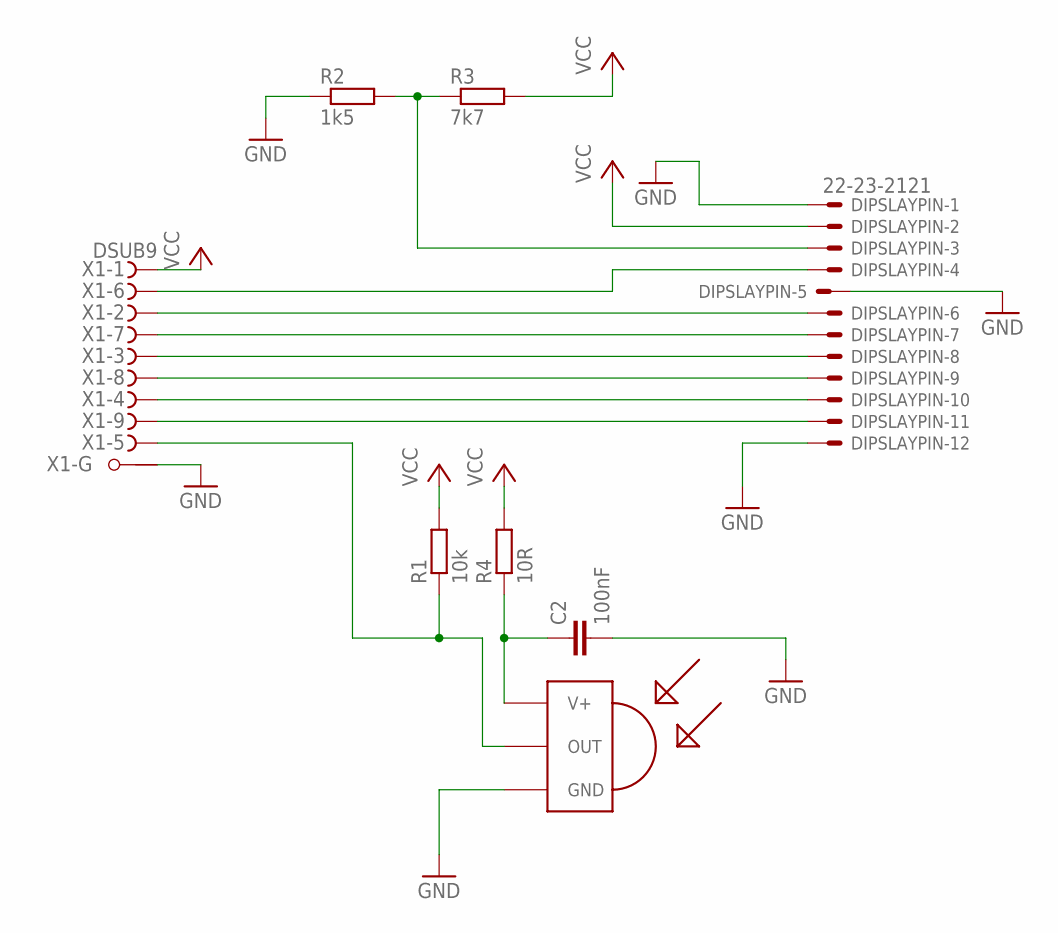
[picture p92: schematic display.sch]

Parts:
C2: 100nF; C025-025X050
DIPSLAYPIN: 22-23-2121
R1: 10k; 0207/10
R2: 1k5; 0207/10
R3: 7k7; 0207/10
R4: 10R; 0207/10
U$1: TSOP4838; TSOP18XX
X1: DSUB9; F09HP

Connections:
GND: C2.2, DIPSLAYPIN.1, DIPSLAYPIN.5, DIPSLAYPIN.12, R2.1, U$1.GND, X1.G1
unnamed: DIPSLAYPIN.6, X1.2 (F)
unnamed: DIPSLAYPIN.7, X1.7 (F)
unnamed: DIPSLAYPIN.8, X1.3 (F)
unnamed: DIPSLAYPIN.9, X1.8 (F)
unnamed: DIPSLAYPIN.10, X1.4 (F)
unnamed: DIPSLAYPIN.11, X1.9 (F)
unnamed: R1.1, U$1.OUT, X1.5 (F)
unnamed: DIPSLAYPIN.4, X1.6 (F)
unnamed: DIPSLAYPIN.3, R2.2, R3.1
unnamed: C2.1, R4.1, U$1.VCC (V+)
VCC: DIPSLAYPIN.2, R1.2, R3.2, R4.2, X1.1 (F)

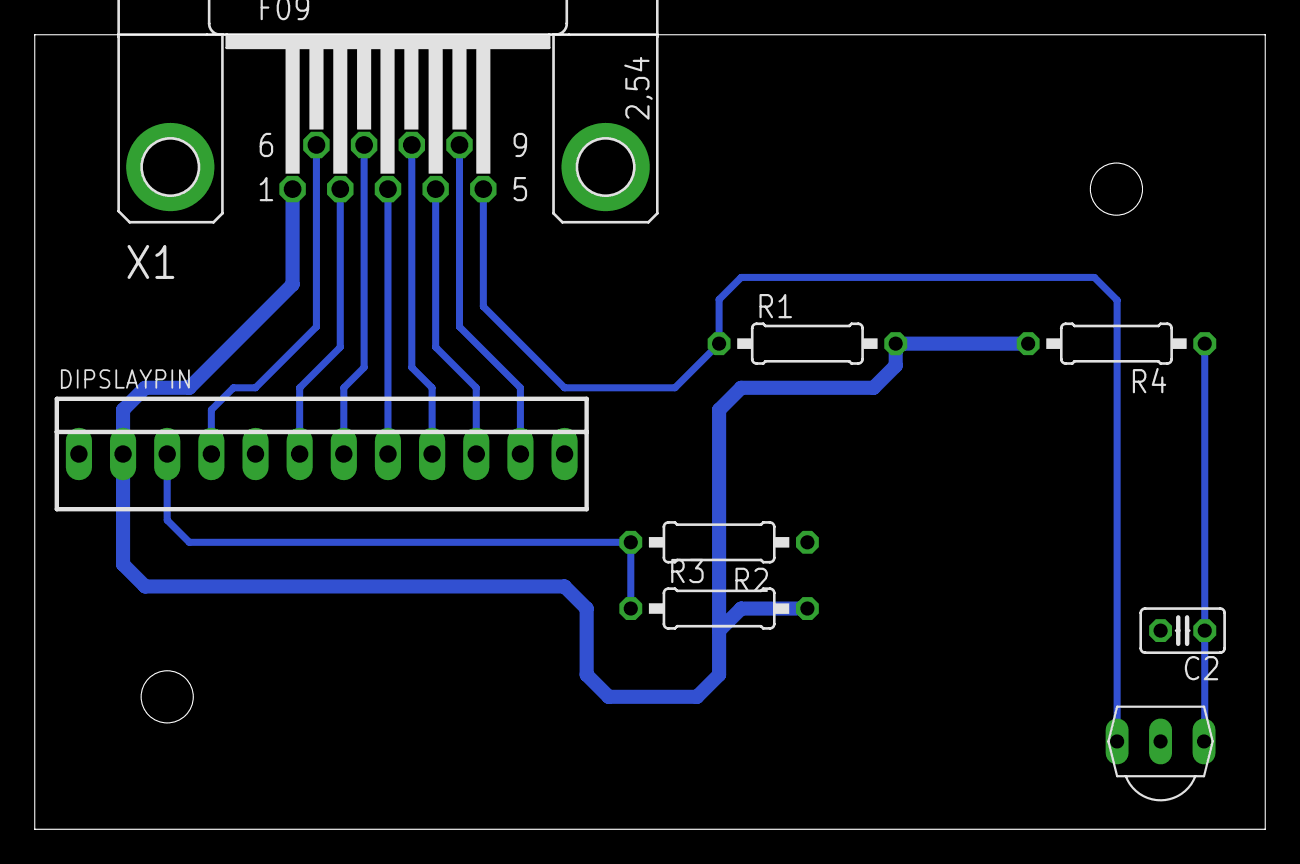
[picture p93: board display.brd from above]

Board: 2 copper layers, 70.8 x 45.7 mm, 8 parts (0 on the bottom side), 12 nets.
