derTino89/RotaCon/Schaltung_Motorsteuerung/für Doku/Motorsteuerung_op.brd

## EAGLE design Schaltung_Motorsteuerung/für Doku/Motorsteuerung_op.brd (2020-03-04)

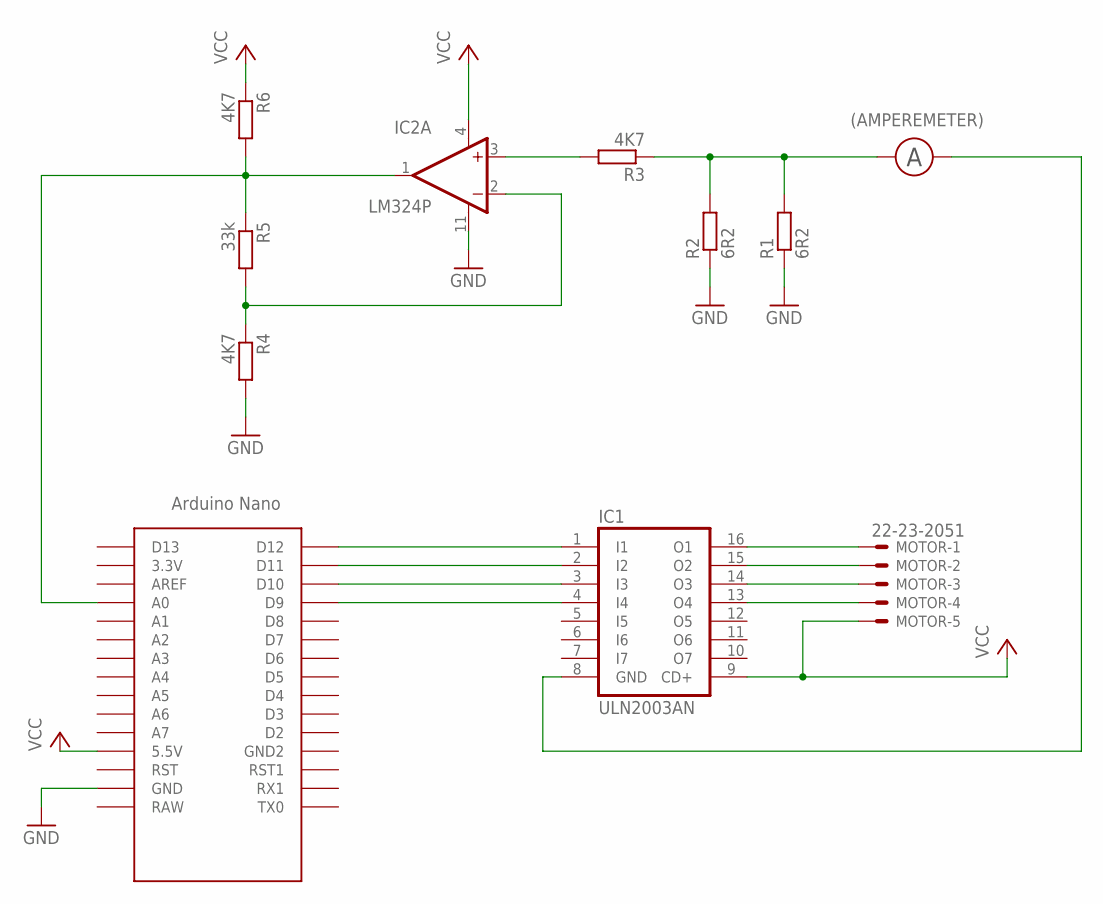
[picture p94: schematic Motorsteuerung_op.sch]

Parts:
IC1: ULN2003AN; DIL16
IC2: LM324P; DIL14
MOTOR: 22-23-2051
R1, R2: 6R2; 0207/10
R3, R4, R6: 4K7; 0207/10
R5: 33k; 0207/10
U$1: NANO

Connections:
GND: IC2.11 (V-), R1.1, R2.1, R4.2, U$1.GND
unnamed: IC1.16 (O1), MOTOR.1
unnamed: IC1.1 (I1), U$1.D12
unnamed: IC1.2 (I2), U$1.D11
unnamed: IC1.3 (I3), U$1.D10
unnamed: IC1.4 (I4), U$1.D9
unnamed: IC1.15 (O2), MOTOR.2
unnamed: IC1.14 (O3), MOTOR.3
unnamed: IC1.13 (O4), MOTOR.4
unnamed: R1.2, R2.2, R3.1
unnamed: IC2.3 (+IN), R3.2
unnamed: IC2.1 (OUT), R5.1, R6.2, U$1.A0
unnamed: IC2.2 (-IN), R4.1, R5.2
VCC: IC1.9 (CD+), IC2.4 (V+), MOTOR.5, R6.1, U$1.5V (5.5V)

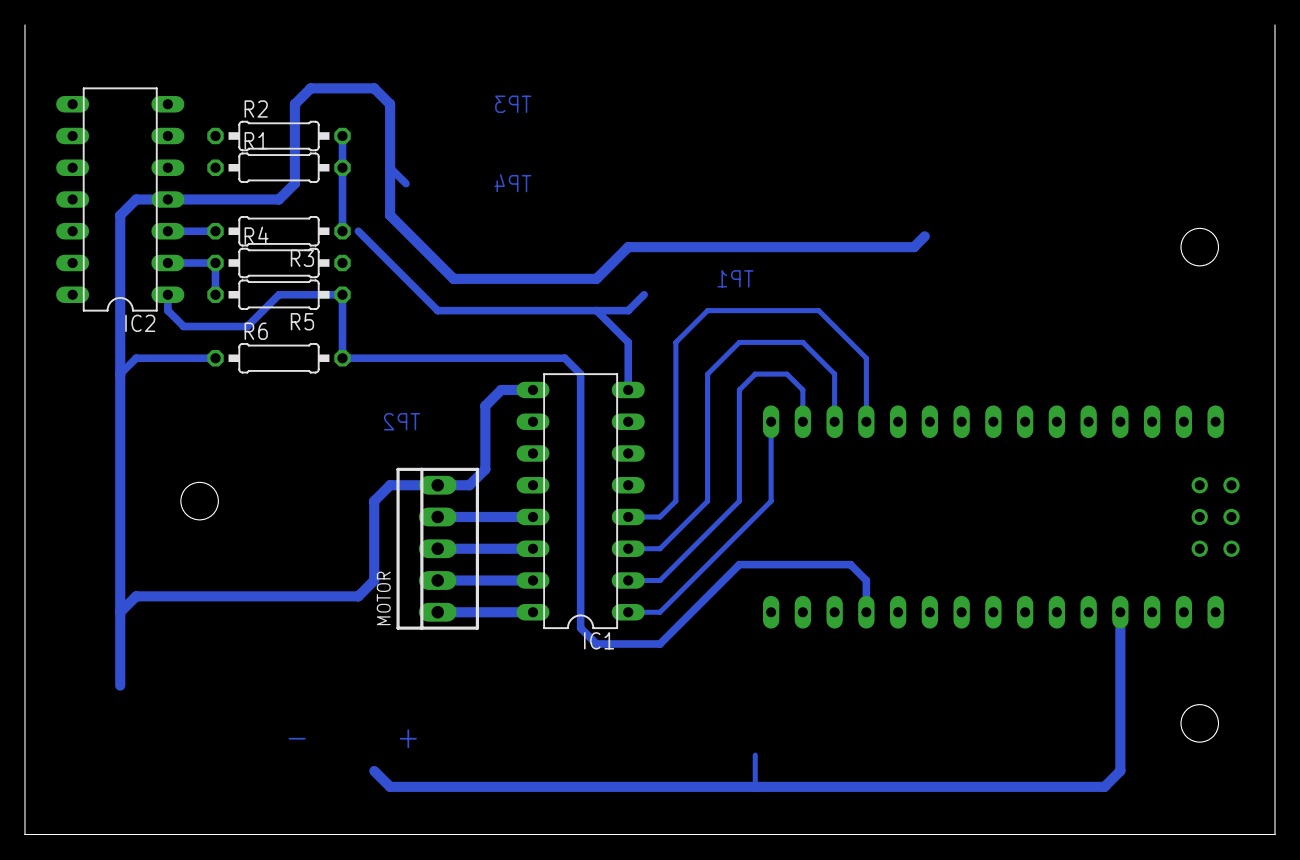
[picture p95: board Motorsteuerung_op.brd from above]

Board: 2 copper layers, 100.0 x 64.8 mm, 10 parts (0 on the bottom side), 14 nets.
