derTino89/RotaCon/Schaltung_Display/Für Doku/ir.brd

## EAGLE design Schaltung_Display/Für Doku/ir.brd (2020-02-13)

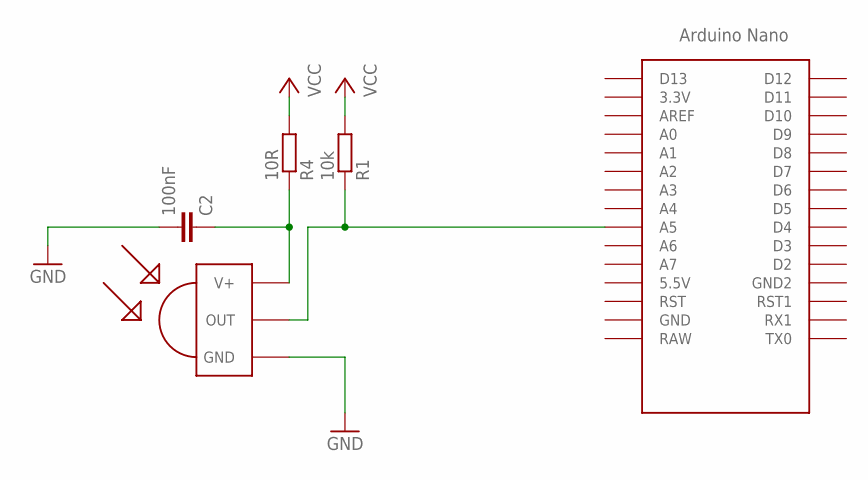
[picture p96: schematic ir.sch]

Parts:
C2: 100nF; C025-025X050
R1: 10k; 0207/10
R4: 10R; 0207/10
U$1: TSOP4838; TSOP18XX
U$2: NANO

Connections:
GND: C2.2, U$1.GND
unnamed: R1.1, U$1.OUT, U$2.A5
unnamed: C2.1, R4.1, U$1.VCC (V+)
VCC: R1.2, R4.2

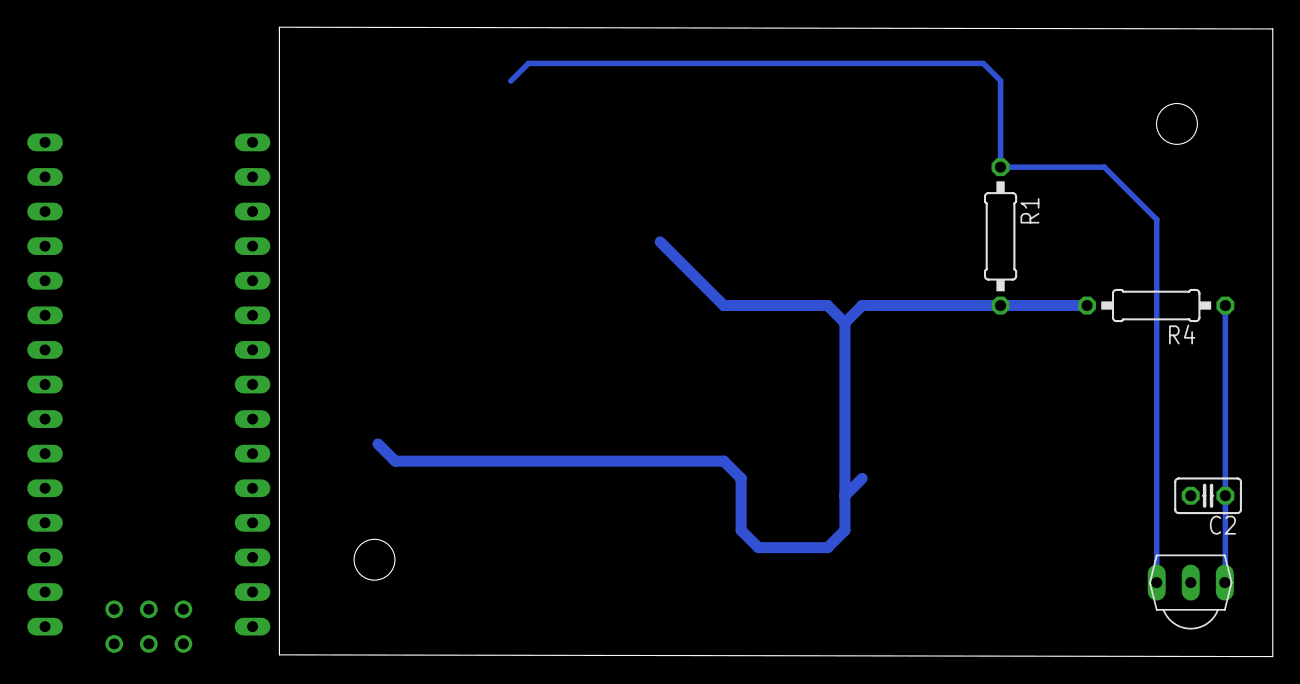
[picture p97: board ir.brd from above]

Board: 2 copper layers, 72.9 x 46.2 mm, 5 parts (0 on the bottom side), 4 nets.
