derTino89/RotaCon/Schaltung_Display/displayNEU.brd

## EAGLE design Schaltung_Display/displayNEU.brd (2020-01-16)

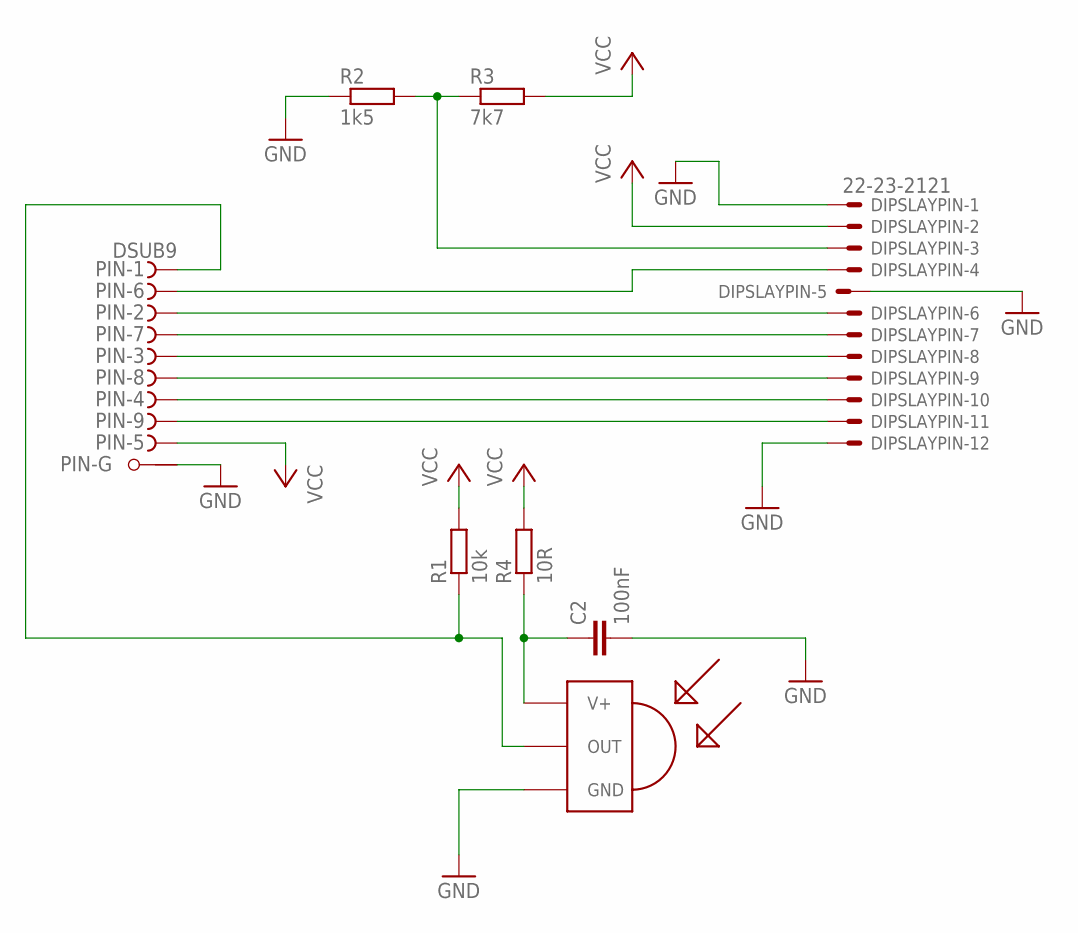
[picture p98: schematic displayNEU.sch]

Parts:
C2: 100nF; C025-025X050
DIPSLAYPIN: 22-23-2121
PIN: DSUB9; F09HP
R1: 10k; 0207/10
R2: 1k5; 0207/10
R3: 7k7; 0207/10
R4: 10R; 0207/10
U$1: TSOP4838; TSOP18XX

Connections:
GND: C2.2, DIPSLAYPIN.1, DIPSLAYPIN.5, DIPSLAYPIN.12, PIN.G1, R2.1, U$1.GND
unnamed: DIPSLAYPIN.6, PIN.2 (F)
unnamed: DIPSLAYPIN.7, PIN.7 (F)
unnamed: DIPSLAYPIN.8, PIN.3 (F)
unnamed: DIPSLAYPIN.9, PIN.8 (F)
unnamed: DIPSLAYPIN.10, PIN.4 (F)
unnamed: DIPSLAYPIN.11, PIN.9 (F)
unnamed: PIN.1 (F), R1.1, U$1.OUT
unnamed: DIPSLAYPIN.4, PIN.6 (F)
unnamed: DIPSLAYPIN.3, R2.2, R3.1
unnamed: C2.1, R4.1, U$1.VCC (V+)
VCC: DIPSLAYPIN.2, PIN.5 (F), R1.2, R3.2, R4.2

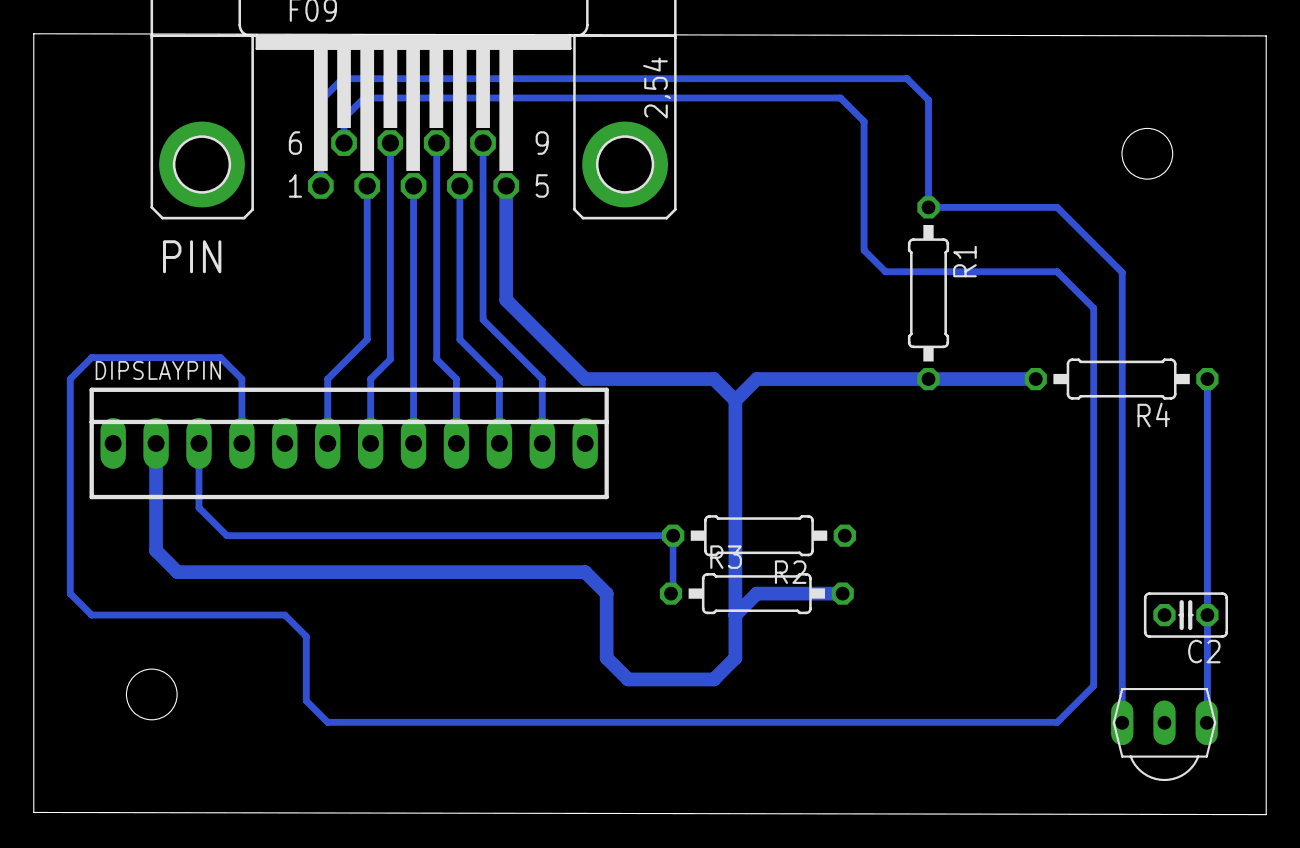
[picture p99: board displayNEU.brd from above]

Board: 2 copper layers, 72.9 x 46.2 mm, 8 parts (0 on the bottom side), 12 nets.
