derTino89/RotaCon/(commit log)

2020-02-10 Update 2
    added some parts in chapter 2 + acronyms
    [MotorsteuerungKlein.brd, MotorsteuerungKlein.sch]
2020-02-13 Update 3
    Added electric cirquit diagrams,
    pin-routing-table,
    description of IR-Module
    [Motorsteuerung_op.brd, Motorsteuerung_op.sch, displayhuhu.brd, displayhuhu.sch, dsub.brd, dsub.sch, ir.brd, ir.sch]
2020-02-15 Update 4
    added more parts
    [Motorsteuerung_op.sch, docusym demo.sch]
2020-02-19 Update 5
    added Bib-Library, Casings an many new parts to the documentation
    [Motorsteuerung.brd, RotaCon.FCStd, gehäuse1.stl, hauptgehäuse1.FCStd, hauptgehäuse2.FCStd]
2020-02-27 Update 7
    Changed format in different parts. (f.e. right border of ducument to 2.5cm)
2020-03-01 Update 8
    Included attachments (chapter 5)
    corrections in chapter 3
2020-03-04 Update 9
    completed version
    [MotorsteuerungKlein.brd, MotorsteuerungKlein.sch, Motorsteuerung_op.brd, Motorsteuerung_op.sch, display.brd, display.sch, displayNEU.brd, displayNEU.sch]
